HeTPort/Rsicv-soc/fpga/zynq_mini_revb/README.md

# ZYNQ MINI 20240221/REVB FPGA build

This directory targets the Bo Chen Jing Xin ZYNQ MINI board marked
`20240221/REVB`, with an XC7Z010 in the CLG400 package. The visible package
marking does not show a readable speed grade, so the flow uses the conservative
Vivado part `xc7z010clg400-1`. Set `ZYNQ_MINI_PART` only after positively
identifying a different speed grade.

The production profile remains 25 MHz. The P0 power baseline uses
`ZYNQ_MINI_CORE_CLOCK_HZ=95000000`, which configures the MMCM for an exact
95 MHz output and writes reports under an application-specific `_95mhz`
directory. For a timing experiment, `100000000` remains supported. The retained
100 MHz route does **not** close: WNS is -0.387 ns.

The top includes a retained but otherwise unused PS7 hard block because Vivado
requires it for correct Zynq device configuration. It supplies no clock or
application service: the custom RISC-V SoC remains entirely in PL.

No physical board is needed to build the bitstreams. A connected board is
needed only to verify JTAG discovery, program the device, and observe the real
clock/reset, LEDs, and UART.

Physical status through 2026-08-23: onboard FT232HL JTAG works after installing
the bundled Digilent Adept runtime; `timer_gpio`, `timer_irq`, external-UART
`hello`, production FreeRTOS heartbeat/D1 behavior, and repeated PL K2 restart
pass on the exact board. Speed-grade identification remains open. JTAG recovery
evidence is in the
[JTAG bring-up log](../../doc/ZYNQ_MINI_REVB_JTAG_BRINGUP_LOG.md).

## Interfaces

| Function | FPGA pin | Board location | Direction/polarity |
|---|---:|---|---|
| 50 MHz PL clock | K17 | X1 / `PL_CLK_50M` | input |
| Reset | M20 | PL K2 | input, active low |
| LED 0..3 | T12, U12, V12, W13 | PL D1..D4 | output, active high |
| UART RX | U15 | EXT IO U15 | adapter TX to board |
| UART TX | W15 | EXT IO W15 | board to adapter RX |

The onboard USB-UART is connected to Zynq PS MIO48/MIO49. It cannot carry the
custom PL UART. Use a separate **3.3 V TTL** USB-UART adapter:

1. adapter TX to EXT IO U15;
2. adapter RX to EXT IO W15;
3. adapter GND to EXT IO GND;
4. leave the adapter VCC pin disconnected.

Use 115200 baud, 8 data bits, no parity, one stop bit, and no flow control.

## Build firmware images

From WSL, build and install the Phase 5 images or the production FreeRTOS
image. The production FreeRTOS build keeps scheduling indefinitely; only its
separate `_sim` profile terminates through `tohost`:

```bash
cd /mnt/d/Rsicv-soc-worktrees/phase2-act4-cleanup
bash sw/build_firmware_wsl.sh --install hello timer_gpio timer_irq
bash sw/build_firmware_wsl.sh --install freertos_demo
bash sw/build_firmware_wsl.sh --install p0_mix
bash sw/build_firmware_wsl.sh --install p0_wfi_timer
bash sw/build_firmware_wsl.sh --install p0_ram_stream
bash sw/build_firmware_wsl.sh --install p0_idle_spin p0_uart_poll
SOC_FREERTOS_MTIME_HZ=95000000 SOC_FREERTOS_DEMO_TIME_SCALE=100 SOC_FREERTOS_SIM_COMPLETION=0 SOC_FREERTOS_POWER_PROFILE=1 SOC_FREERTOS_IMAGE_SUFFIX=_p0 bash sw/build_firmware_wsl.sh --install freertos_demo
```

## Build bitstreams with Vivado 2019.2

From PowerShell at the repository root:

```powershell
$vivado = 'D:\vivado\Vivado\2019.2\bin\vivado.bat'
& $vivado -mode batch -notrace `
  -source .\fpga\zynq_mini_revb\build.tcl -tclargs hello
& $vivado -mode batch -notrace `
  -source .\fpga\zynq_mini_revb\build.tcl -tclargs timer_gpio
& $vivado -mode batch -notrace `
  -source .\fpga\zynq_mini_revb\build.tcl -tclargs timer_irq
& $vivado -mode batch -notrace `
  -source .\fpga\zynq_mini_revb\build.tcl -tclargs freertos_demo

# Optional timing experiment; currently expected to fail the WNS gate.
$env:ZYNQ_MINI_CORE_CLOCK_HZ = '100000000'
& $vivado -mode batch -notrace `
  -source .\fpga\zynq_mini_revb\build.tcl -tclargs hello
Remove-Item Env:\ZYNQ_MINI_CORE_CLOCK_HZ

# Exact P0 routed profile.
$env:ZYNQ_MINI_CORE_CLOCK_HZ = '95000000'
& $vivado -mode batch -notrace `
  -source .\fpga\zynq_mini_revb\build.tcl -tclargs p0_mix
& $vivado -mode batch -notrace `
  -source .\fpga\zynq_mini_revb\build.tcl -tclargs p0_wfi_timer
& $vivado -mode batch -notrace `
  -source .\fpga\zynq_mini_revb\build.tcl -tclargs p0_ram_stream
& $vivado -mode batch -notrace `
  -source .\fpga\zynq_mini_revb\build.tcl -tclargs freertos_demo_p0
& $vivado -mode batch -notrace `
  -source .\fpga\zynq_mini_revb\build.tcl -tclargs p0_idle_spin
& $vivado -mode batch -notrace `
  -source .\fpga\zynq_mini_revb\build.tcl -tclargs p0_uart_poll
Remove-Item Env:\ZYNQ_MINI_CORE_CLOCK_HZ
```

Each run reads RTL and XDC, synthesizes, checks that both firmware images
survive as nonzero BRAM initialization, places, routes, writes utilization,
timing/clock/power/DRC reports, rejects negative routed WNS or any Error/Critical
Warning DRC, and generates:

```text
build/zynq_mini_revb/<application>/zynq_mini_revb_<application>.bit
```

The Phase 5 hardware profiles keep the same firmware images but slow `mtime`
so the results are visible: `timer_gpio` changes LEDs about once per second,
while `timer_irq` generates one interrupt about once per second for ten
interrupts. `freertos_demo` uses the real 25 MHz MTIME rate configured in its
production image, giving a 1 kHz RTOS tick.

The P0 measurement profiles keep `TIMER_TICK_CYCLES=1` to match ModelSim.
The routed `p0_mix` checkpoint closes setup at WNS +0.006 ns; the other five
P0 checkpoints each close at +0.003 ns. All six have TNS 0 and zero blocking
DRC findings. They are distinct workload/checkpoint identities; none can be
substituted for the other or for a 25 MHz production build. The
[power framework](../../power/README.md) and
[P0 results](../../doc/plans/p0-power-baseline/results.md) explain activity
mapping, estimates, and limits.

## Program and observe the board

These are the steps that require the board:

1. Power the board off and set BOOT to JTAG `00` (both switches toward the
   silk-screened ON/KEY side, according to the board legend).
2. Power the board only through its documented 5 V Type-C input. Connect the
   JTAG Type-C cable and the external 3.3 V UART wiring above. Do not connect
   the USB-UART adapter's VCC pin.
3. In Vivado, open Hardware Manager, select **Open Target > Auto Connect**, and
   confirm an XC7Z010 is detected.
4. Program one generated `.bit` file. If needed, press PL K2 once after
   programming.
5. For `hello`, confirm the expected UART banner at 115200 8N1. For
   `timer_gpio`, confirm the PL LEDs step through the firmware sequence. For
   `timer_irq`, confirm the ten timer-interrupt completion behavior. For
   `freertos_demo`, confirm `FreeRTOS RV32IM`, then a `heartbeat` line every
   second, while PL D1 toggles every 500 ms. Leave it running to exercise tick
   preemption, queue blocking/unblocking, and repeated context switches.

Observed through 2026-08-23:

- `timer_gpio`: PASS, `0001 -> 0010 -> 0100 -> 1000 -> 0101`, approximately
  one update per second;
- `timer_irq`: PASS, binary interrupt count `0001` through `1010`,
  approximately one update per second, with final D2/D4 on;
- `hello`: PASS through an external 3.3 V USB-TTL adapter at 115200 8N1;
- `freertos_demo`: PASS with sustained `heartbeat`, visible PL D1 toggling,
  and recovery after deliberate K2 resets.

The retained PuTTY transcript contains 74 exact hello strings, 17 banners
caused by deliberate resets, and 537 exact heartbeats. Evidence and hashes are
in [`doc/evidence/board_20260823/`](../../doc/evidence/board_20260823/README.md).

Programming is volatile: after power is removed, reload the bitstream. JTAG and
the UART/repeated-reset baseline are proven; QSPI/SD boot-image generation
remains deferred beyond the first milestone.

## JTAG cable recovery

If Hardware Manager connects to `hw_server` but shows `localhost (0)`, the
server is alive but has enumerated zero hardware cables. On this machine,
Windows already saw the FT232HL as `VID_0403:PID_6014` / `Digilent USB Device`,
which ruled out a power-only Type-C cable and moved the investigation to the
Vivado cable runtime.

Close Vivado, open an elevated PowerShell, and install the support bundled with
the same Vivado release:

```powershell
Set-Location -LiteralPath `
  'D:\vivado\Vivado\2019.2\data\xicom\cable_drivers\nt64'
.\install_drivers_wrapper.bat
```

The successful log installed Xilinx PC USB support, Digilent Adept Runtime
2.18.2/USB support, and SmartLynq support. After restarting/re-enumerating the
device, Vivado could program the board. Do not rewrite the FTDI EEPROM as a
first repair: this unit already reports a Digilent identity. Commands,
evidence, source links, rejected paths, and the reusable layer-by-layer
decision tree are in the
[JTAG bring-up log](../../doc/ZYNQ_MINI_REVB_JTAG_BRINGUP_LOG.md).

## What still needs manual review

- Confirm the physical package's speed grade with a vendor record or readable
  device-identification source. The `-1` build is deliberately conservative.
- The 50 MHz clock, active-high LED mapping, BRAM boot, timer progression, and
  interrupt-driven execution, external UART TX, production FreeRTOS, and K2
  restarts now have physical evidence. If later behavior differs from the
  schematic, stop and recheck continuity or vendor documentation before
  changing package pins.
- Vivado currently warns that asynchronously reset control registers feed data
  BRAM address/control logic (`REQP-1839`). Reset deassertion is synchronized
  and repeated K2 testing passes, but the warning remains a structural cleanup
  candidate before treating this as a production design.
