HeTPort/Rsicv-soc/sim/regress/README.md

# Automated regression runner

This directory contains the lightweight regression layer for the RV32IM core.
It deliberately does not require UVM. The runner compiles RTL once, selects
tests from a JSON manifest, launches each test in ModelSim, saves independent
logs, and returns a nonzero process status if any test fails.

## Files

- `tests.json` - test names, firmware images, timeouts, and selection tags.
- `soc_red_tests.json` - isolated Phase 2 SoC contract cases for data and
  instruction access faults.
- `phase3_tests.json` - precise timer/WFI and 10,000-interrupt Phase 3 cases.
- `phase4_tests.json` - polling UART TX/RX and GPIO Phase 4 cases.
- `phase5_tests.json` - split-image and reset-to-C Phase 5 firmware cases.
- `phase6_tests.json` - official FreeRTOS preemption/queue/UART/GPIO slice.
- `run_regression.ps1` - Windows PowerShell orchestration and result checking.
- `run_release_verification.ps1` - fail-fast release entry point for map/tool,
  focused fetch-error/fabric, directed Phase 3–6, and applicable ACT4 gates.
- `regression_result.ps1` - shared simulator result-classification policy.
- `test_regression_result.ps1` - dependency-free positive/negative classifier
  test, including the nonzero-exit false-pass case.
- `run_regression.cmd` - Command Prompt wrapper that bypasses script policy only
  for this one PowerShell process.
- `build_tests_wsl.sh` - optional GNU-toolchain builder for assembly tests in WSL.
- `elf_to_mem.py` - address-aware RV32 ELF to instruction/data RAM converter.
- `import_act4.py` - converts ACT4 ELF directories and generates a manifest.
- `build_act4_wsl.sh` - generates/imports ACT4 tests in WSL.
- `run_act4_build.ps1` - parameterized Windows/WSL ACT4 build entry point for
  either the I or M extension.
- `run_act4.ps1` - convenience wrapper for imported ACT4 ELF directories.

Generated files are kept outside the source directories:

```text
sim/build/regression/work   ModelSim work library
sim/logs/regression         compile and per-test logs
build/tests                 WSL-generated object, ELF, binary, hex, disassembly
```

## Quick start on Windows

From PowerShell:

```powershell
Set-Location D:\Rsicv-soc\sim\regress
Set-ExecutionPolicy -Scope Process -ExecutionPolicy Bypass
./run_regression.ps1
./test_regression_result.ps1
```

From Command Prompt:

```bat
cd /d D:\Rsicv-soc\sim\regress
run_regression.cmd
```

Useful selections:

```powershell
# Show the manifest without compiling or simulating.
./run_regression.ps1 -List

# Run tests having the lsu tag.
./run_regression.ps1 -Tag lsu

# A test matches when it has any requested tag.
./run_regression.ps1 -Tag csr,mret

# Explicit names take priority over tags.
./run_regression.ps1 -Test ebreak,mret

# Reuse the existing compiled library.
./run_regression.ps1 -Tag trap -NoCompile

# Enable commit and pipeline messages in each selected test log.
./run_regression.ps1 -Test ebreak -Trace

# Also request a VCD. Sequential tests overwrite the same VCD in the build
# directory, so use this mainly with one explicitly selected test.
./run_regression.ps1 -Test ebreak -Trace -DumpWaves
```

## One-command release verification

With an existing generated `build/act4/tests.json` manifest:

```powershell
./run_release_verification.ps1
```

From a clean checkout with the pinned WSL/ACT4 prerequisites installed:

```powershell
./run_release_verification.ps1 -RegenerateAct4 -Act4Jobs 8
```

This exact path passed from a new detached worktree on 2026-08-18. The wrapper
uses named hashtable splatting for `Jobs` and optional ACT4 paths; positional
array splatting is incorrect for forwarding named options to another
PowerShell script. Retained results are in
[`../../doc/evidence/release/BASELINE_2026-08-18.md`](../../doc/evidence/release/BASELINE_2026-08-18.md).

The command runs, in order:

1. generated SoC-map staleness and 9 map-generator tests;
2. 12 ELF-converter/ACT4-importer tests and the result-classifier negative test;
3. the focused fetch-error timing and SoC data-fabric protocol tests;
4. 23 directed smoke tests, including the precise illegal-JALR-funct3 case;
5. both Phase 3 tests, including 10,000 timer interrupts;
6. Phase 4 (3), Phase 5 (4), and Phase 6 (1) regressions;
7. ACT4 manifest classification (47 total, 39 RV32I, 8 RV32M) and all 47 cases.

Every step is fail-fast. `-SkipAct4` exercises the complete local preflight but
prints an explicit warning and cannot be reported as a release pass.

The Phase 2 SoC contract suite selects `tb_riscv_soc` through a separate
manifest. Run the implemented centralized data-decoder/default-target cases:

```powershell
./run_regression.ps1 `
  -Manifest .\soc_red_tests.json `
  -Tag phase2-data
```

All three selected runs (load, store, and store with inserted RAM waits) must
pass. Run the instruction-access-fault case separately with:

```powershell
./run_regression.ps1 `
  -Manifest .\soc_red_tests.json `
  -Tag phase2-fetch
```

The selected fetch case must also pass. The focused fetch timing and fabric
protocol tests are:

```powershell
Set-Location D:\Rsicv-soc\sim
vsim -c -do run_fetch_error_timing.do
vsim -c -do run_soc_data_fabric.do
```

Run the Phase 3 architectural and long-duration timer tests from
`sim/regress` with:

```powershell
./run_regression.ps1 -Manifest .\phase3_tests.json -Test soc_timer_wfi
./run_regression.ps1 -Manifest .\phase3_tests.json -Test soc_timer_10k
```

Run the Phase 4 peripheral vertical slices with:

```powershell
./run_regression.ps1 -Manifest .\phase4_tests.json -Test soc_uart_hello
./run_regression.ps1 -Manifest .\phase4_tests.json -Test soc_uart_echo
./run_regression.ps1 -Manifest .\phase4_tests.json -Test soc_gpio_out
```

The hello run enables the `tb_riscv_soc` serial-pin decoder. It passes only
after `uart_tx_o` decodes as `Hello, UART!\r\n` and firmware commits
`tohost=1`. The echo run drives 16 real 8N1 frames into `uart_rx_i`; polling
firmware drains the default 16-byte FIFO, echoes them, and passes only after
`uart_tx_o` decodes as `RX FIFO 16 OK!\r\n` with `tohost=1`.
The GPIO run writes and reads back five MMIO values while an independent
scoreboard observes `gpio_out_o = 01, 02, 04, 08, A5`. This catches both target
state errors and a missing SoC output connection.

Build the Phase 5 C firmware from WSL with:

```bash
bash sw/build_firmware_wsl.sh --install hello timer_gpio timer_irq
```

The build emits ELF, map, readelf, disassembly, size, and independent local
program/data images. It consumes `sim/generated/soc_map.json` rather than a
second handwritten map. Run all Phase 5 slices with:

```powershell
./run_regression.ps1 -Manifest .\phase5_tests.json -Tag phase5
```

The hello case checks ABI/runtime invariants before decoding
`Hello, UART!\r\n`. Its ELF-derived `.bss` tail is poisoned in the input data
image, so observing zero proves startup cleared it. The timer/GPIO case checks
timer-polled output/readback. The interrupt case independently requires ten
machine-timer trap entries, full-context `mret` return, and final GPIO `0x0A`.

Build the distinct Phase 6 simulation image from the repository root with:

```bash
SOC_FREERTOS_MTIME_HZ=5000000 \
SOC_FREERTOS_DEMO_TIME_SCALE=100 \
SOC_FREERTOS_SIM_COMPLETION=1 \
SOC_FREERTOS_IMAGE_SUFFIX=_sim \
bash sw/build_firmware_wsl.sh --install freertos_demo
```

Then run:

```powershell
./run_regression.ps1 -Manifest .\phase6_tests.json -Tag phase6
```

The scoreboard checks the FreeRTOS banner/heartbeat stream, alternating GPIO,
and at least ten timer interrupts. Firmware reports PASS only after ordered
queue traffic and the queue-forced `s2`-`s11` context sentinels succeed. Build
the production 25 MHz image without the simulation overrides.

The fast `phase6` case remains the normal release gate. A separate soak image
raises the firmware completion thresholds to 1,000 tick hooks and queue
receives, 100 GPIO updates, and 50 heartbeats:

```bash
SOC_FREERTOS_MTIME_HZ=5000000 \
SOC_FREERTOS_DEMO_TIME_SCALE=100 \
SOC_FREERTOS_SIM_COMPLETION=1 \
SOC_FREERTOS_IMAGE_SUFFIX=_soak \
SOC_FREERTOS_MIN_QUEUE_RECEIVES=1000 \
SOC_FREERTOS_MIN_LED_UPDATES=100 \
SOC_FREERTOS_MIN_HEARTBEATS=50 \
SOC_FREERTOS_MIN_TICK_HOOKS=1000 \
bash sw/build_firmware_wsl.sh --install freertos_demo
```

Run it explicitly; the `phase6-soak` tag is deliberately excluded from the
fast unified release command:

```powershell
./run_regression.ps1 -Manifest .\phase6_tests.json -Tag phase6-soak
```

Success produces process exit code `0`. Manifest, tool, compile, assertion,
timeout, simulator, or architectural failures produce a nonzero exit code. The
focused classifier test proves that a PASS-looking transcript cannot override
a nonzero simulator exit. This makes the same command usable by a person, a
batch file, or CI.

## Manifest grammar

`tests.json` uses JSON objects, arrays, strings, and numbers:

```json
{
  "schema_version": 1,
  "defaults": {
    "timeout_cycles": 20000
  },
  "tests": [
    {
      "name": "rv32im_waitstate",
      "image": "testdata/prog.hex",
      "timeout_cycles": 50000,
      "data_req_wait_cycles": 2,
      "data_rsp_wait_cycles": 3,
      "tags": ["all", "smoke", "lsu", "waitstate", "ar003"]
    }
  ]
}
```

Important JSON rules:

- `{ ... }` is an object containing named properties.
- `[ ... ]` is an ordered array.
- Property names and strings require double quotes.
- Commas separate properties and array elements, but JSON forbids a trailing
  comma after the final item.
- `image` is relative to the repository root, not the launch directory.
- Optional `data_image` initializes data RAM independently from instruction RAM.
- Optional `top` selects the elaborated simulation top. It may be supplied by
  a test or by `defaults`; when omitted it remains `work.tb_riscv_core`.
- Optional `tohost_addr` overrides the completion address for that test.
- `timeout_cycles` bounds the test independently of host execution time.
- Optional `data_req_wait_cycles` delays data-request acceptance.
- Optional `data_rsp_wait_cycles` independently delays the response after the
  synchronous RAM access. Both default to zero.
- Optional `data_error_addr` makes the RAM adapter return `rsp_error` for one
  selected address while leaving other accesses available to the trap handler.
- Optional `freertos_min_timer_irqs`, `freertos_min_uart_bytes`, and
  `freertos_min_gpio_transitions` set independent SoC-testbench minimums for a
  FreeRTOS profile.
- Tags describe capabilities and allow one test to belong to several suites.

The runner uses **any-tag matching**. `-Tag csr,mret` selects a test when it has
`csr` or `mret`. `-Test` performs exact name selection and takes priority.

## PowerShell grammar used by the runner

### Parameters and types

```powershell
param(
    [string[]]$Tag = @("smoke"),
    [switch]$Trace
)
```

- `[string[]]` declares an array of strings.
- `@(...)` forces an array even when there is only one result.
- `[switch]` is false when absent and true when written on the command line.

### Variables and interpolation

```powershell
$logPath = Join-Path $logDir "$testName.log"
```

Variables begin with `$`. Double-quoted strings expand variables; single-quoted
strings normally do not.

### Pipelines

```powershell
$failed = @($results | Where-Object { $_.Status -ne "PASS" })
```

`|` passes objects rather than plain text. `$_` means the current pipeline
object. `{ ... }` is a script block evaluated for every object.

### Splatting command arguments

```powershell
$vlogArgs = @("-sv", "-work", $workLibrary) + $sourceFiles
$output = & vlog @vlogArgs 2>&1
```

- `&` invokes a command whose name or path is an expression.
- `@vlogArgs` expands an array into separate command-line arguments.
- `2>&1` merges the error stream into captured output.
- `$LASTEXITCODE` contains the native executable's process exit status.

ModelSim can return zero after some simulation failures, depending on how Tcl
exits. The runner therefore requires all four conditions:

```text
the native simulator process exit status is zero
[TB] RESULT: PASS is present
no ** Fatal: message is present
the final ModelSim error count is zero
```

`test_regression_result.ps1` supplies a nonzero exit together with an otherwise
passing transcript and proves that the shared production classifier rejects it.

### Guaranteed directory restoration

```powershell
Push-Location $buildDir
try {
    # compile and simulate
} finally {
    Pop-Location
}
```

`finally` executes even when an exception is thrown. This prevents a failed
regression from leaving an interactive shell in a surprising directory.

## ModelSim command grammar

The runner ultimately invokes commands equivalent to:

```powershell
vlib D:/Rsicv-soc/sim/build/regression/work
vmap work D:/Rsicv-soc/sim/build/regression/work
vlog -sv -work D:/Rsicv-soc/sim/build/regression/work <absolute-source-files>
vsim -c -voptargs=+acc `
  -gPROGRAM_FILE=D:/Rsicv-soc/testdata/ebreak_test.hex `
  -gTIMEOUT_CYCLES=1000 `
  -gTRACE_ENABLE=0 `
  -gDUMP_WAVES=0 `
  work.tb_riscv_core `
  -do "run -all; quit -f"
```

- `vlib` creates a compiled HDL library.
- `vmap` assigns the logical name `work` to its physical directory.
- `vlog -sv` compiles SystemVerilog.
- `vsim -c` selects console mode.
- `-gNAME=value` overrides a top-level SystemVerilog parameter.
- `-do` supplies Tcl commands; semicolons separate Tcl commands.

The corresponding SystemVerilog parameter declaration is:

```systemverilog
module tb_riscv_core #(
  parameter string PROGRAM_FILE = "../testdata/prog.hex",
  parameter string DATA_FILE = "",
  parameter bit TRACE_ENABLE = 1'b0,
  parameter bit DUMP_WAVES = 1'b0,
  parameter int TIMEOUT_CYCLES = 20000,
  parameter logic [31:0] TOHOST_ADDR = 32'h0000_1000
);
```

Parameters are elaboration-time constants. ModelSim applies `-g` before the
testbench is elaborated, so each test can use a different image and watchdog
without recompiling the RTL.

## Building assembly tests in WSL

From Ubuntu/WSL:

```bash
cd /mnt/d/Rsicv-soc
bash sim/regress/build_tests_wsl.sh ebreak_test m_trap_test
```

Outputs are written to `build/tests`; checked-in images are not overwritten.
Inspect them before installing:

```bash
less build/tests/ebreak_test.dis
diff -u testdata/ebreak_test.hex build/tests/ebreak_test.hex
```

To copy generated images into `testdata` deliberately:

```bash
bash sim/regress/build_tests_wsl.sh --install ebreak_test m_trap_test
```

Environment variables can select another tool prefix or ISA:

```bash
RISCV_PREFIX=riscv64-unknown-elf- \
RISCV_MARCH=rv32im_zicsr \
RISCV_MABI=ilp32 \
bash sim/regress/build_tests_wsl.sh ebreak_test
```

Relevant Bash grammar:

- `set -euo pipefail` stops on command failure, unset variables, or failed
  pipeline elements.
- `$(command)` captures a command's output.
- `${name}` expands a variable without ambiguity.
- `"${array[@]}"` expands an array while preserving argument boundaries.
- `command -v tool` checks whether an executable is available.
- `a | b | c` forms a pipeline; here `od`, `tr`, and `sed` convert a
  little-endian binary into one 32-bit `$readmemh` word per line.

## Adding a test

1. Add or generate the `.hex` image.
2. Run it directly once with `-Trace` if it is new.
3. Add one object to `tests.json` with a unique name.
4. Choose a timeout based on expected architectural cycles, with margin.
5. Add meaningful tags such as `rv32m`, `lsu`, `csr`, `trap`, or `smoke`.
6. Run the focused tag, then the full smoke suite.

Example:

```powershell
./run_regression.ps1 -Test new_test -Trace
./run_regression.ps1 -Tag smoke
```

## Scope and future adapters

This runner is orchestration, not an official ISA test set. The ACT4 adapter is
documented in `verif/act4/README.md`. Future sources can include legacy
`riscv-tests`, randomized riscv-dv programs, or Spike comparison results. The
basic compile/run/log/report layer remains the same.
