HeTPort/Rsicv-soc/doc/PROJECT_KNOWLEDGE_BASE.md

# RISC-V SoC Project Knowledge Base

**Document type:** Living study guide

**Audience:** New contributors and learners

**Last updated:** 2026-10-16

**Production reference:** `codex/phase2-act4-cleanup`. Phases 1–4 are complete.
Phase 5 is complete in ModelSim and Vivado OOC synthesis. AR-024 adds the Bo
Chen Jing Xin ZYNQ MINI `20240221/REVB` top, schematic-derived XDC, 50-to-25 MHz
MMCM/reset wrapper, and routed bitstreams for all three bare-metal programs.
JTAG plus physical `timer_gpio` and `timer_irq` execution now pass. External
UART TX, production FreeRTOS heartbeat/D1 behavior, and repeated K2 restart now
also pass physically. AR-025 adds the official FreeRTOS V11.3.0 RISC-V port, a
GREEN ModelSim vertical slice and extended scheduler/context soak, a routed
exact-board bitstream, and physical execution evidence. Positive speed-grade
identification remains open.

The current owner-selected learning track is an independent specification-first
rewrite on `codex/core-v2-spec-first`, recorded in
[AR-034](ar/AR034_SPEC_FIRST_CORE_V2_REWRITE.md). Existing synthesizable `src/`
remains v1; future v2 ownership is documented in the
[directory map](plans/core-v2-foundation/architecture.md). The owner writes RTL
module by module, starting with the [ALU specification pilot](plans/core-v2-foundation/modules/alu.md).
Independent models, module/cluster tests, precise retirement observation and
later ISS checking follow the [CV2 verification plan](plans/core-v2-foundation/verification_plan.md).
This is a documentation foundation; new RTL, tests, timing and power are
unimplemented/NOT RUN. Mutable evidence is owned by
[CV2 results](plans/core-v2-foundation/results.md).

AR-026 accepts a future scalable UVM verification architecture based on stable
retirement, memory, translation, coherence, and accelerator transactions above
protocol-specific interfaces and VIP. ModelSim SE-64 2019.2 now compiles and
runs its installed UVM 1.2 library, including a passing negative result-gate
check, but there is still no DUT-facing UVM component or coverage claim. The
first DUT slice will passively adapt the existing
`commit_pkt_t` into a `retire_event`, preserve `trap_entry_t` as a separate
`trap_entry_event`, and feed an ordered scoreboard.

Post-FreeRTOS growth is now organized by an evidence-gated roadmap rather than
one flat wish list. Each active substantial phase records requirements,
architecture, registers when applicable, verification plan, and observed
results using [`PHASE_EVIDENCE_TEMPLATE.md`](PHASE_EVIDENCE_TEMPLATE.md).
The current synthesizable hierarchy, runtime paths, shared packages, and
replaceable interfaces are summarized in
[`MODULE_DEPENDENCY_VIEW.md`](MODULE_DEPENDENCY_VIEW.md).
The detailed sequence and learning prerequisites are in
[`ROADMAP_AND_LEARNING_PATH.md`](ROADMAP_AND_LEARNING_PATH.md). This planning
change adds no RTL, UVM, low-power, accelerator, or propulsion capability.
The central literature/reproduction map, W0 workload-discovery process,
decision policy, and benchmark policy are in
[`RESEARCH_PROGRAM_PLAN.md`](RESEARCH_PROGRAM_PLAN.md). Detailed paper audits
remain separate so research can grow without turning the roadmap or TODO into
an evidence dump. The first reading queue and exact source provenance are in
[`research/SOURCE_REGISTRY.md`](research/SOURCE_REGISTRY.md).

Documentation is governed through
[`CONTEXT_ROUTER.md`](CONTEXT_ROUTER.md) and
[`AR033_DOCUMENT_GOVERNANCE_AND_CONTEXT_ROUTING.md`](ar/AR033_DOCUMENT_GOVERNANCE_AND_CONTEXT_ROUTING.md).
The router defines the smallest task-specific reading set, `notes/inbox/`
accepts rough ideas without making them requirements, and the legacy `docs/`
tree is frozen pending gradual migration. This changes how project knowledge is
found and maintained; it does not change RTL or software behavior.

The repository now has an adopted noncommercial source-available license and
commercial contact (`Hetport@outlook.com`); FreeRTOS remains under its upstream
MIT terms. P0's six-scenario measurement-only portfolio is now technically
verified: mixed compute, WFI/timer, RAM stream, FreeRTOS, clocked spin idle,
and UART polling all pass deterministic marker-window backward-SAIF,
matching timing-clean 95 MHz routed analysis, reviewed per-block mapping,
and two-run <=2% dynamic-power repeatability. The old 4%/clockless OOC spike
is rejected. Direct name mapping remains about 5.5%; these are comparative
Vivado FPGA estimates, not board-rail or ASIC power. Spin idle is not deep
sleep: changing operands and repeated fetches keep BRAM and incidental DSP
logic active; WFI/timer is the separate sleep/wake reference.
AR-030 replaces AR-027's combinational RV32M multiply backend with a fixed
registered blocking backend. Four registered 17-bit partial products feed two
registered aligned sums and a registered final product; the core holds ID/EX
and emits EX/WB bubbles until the response. It retains 4 DSP48E1 cells, closes
the exact 95 MHz route at WNS +0.430 ns, reduces `p0_mix` energy 4.03%, and
eliminates multiplier switching in the no-MUL spin workload. The whole SoC
   initially missed 100 MHz at WNS -0.312 ns on a timer-to-EX/WB path.
AR-029 fixes the production architecture at RV32 instead of advertising an
unsupported RV64 macro/width matrix. The 64-bit timer and architectural
counters remain explicit paired-word state, while wide future NPU/MAC datapaths
remain independent of scalar XLEN. Fake core/SoC/bus/peripheral `AW`/`DW`
overrides were removed; genuinely generic RAM and divider parameters remain.
AR-031 centralizes pipeline movement in `core_ctrl`: typed EX and retirement
redirect candidates enter one priority point, and one `pipe_ctrl_t` drives
fetch, holds, flushes, delayed fetch invalidation, and kills. MRET redirect and
CSR restoration now occur together at retirement. Exact 95 and 100 MHz routes
pass at +0.078 and +0.098 ns; this costs 121 LUT versus P1 but leaves `p0_mix`
cycles and estimated dynamic power unchanged.
AR-032 then performs a behavior-preserving semantic cleanup: `decode` and
`execute` reserve `_i/_o` for ports and build outgoing packets from the named
canonical bubble before assigning boundary-owned fields. This changes neither
instruction behavior nor pipeline timing; focused/protocol tests, smoke 23/23,
ACT4 47/47, and layered lint pass.

> Update this document whenever a change alters a module boundary, pipeline
> timing, packet field, architectural behavior, memory map, verification
> workflow, or current project milestone. Historical reasons and tradeoffs
> belong in
> [`ARCHITECTURE_DESIGN_AND_DECISIONS.md`](ARCHITECTURE_DESIGN_AND_DECISIONS.md).

## 1. What this project is

This repository implements a small custom RISC-V processor and early SoC in
SystemVerilog. The processor currently supports:

- RV32I integer instructions;
- the RV32M multiply/divide extension;
- machine-mode CSR, synchronous-exception, and machine-timer-interrupt support;
- precise traps for the currently implemented exception classes;
- synchronous instruction and data Block RAM;
- an architectural commit interface for verification.

The first practical system milestone is:

> Run preemptive FreeRTOS on this custom RV32IM core in the programmable logic
> of a Zynq XC7Z010 device.

The FreeRTOS milestone is intentionally smaller than the original Linux goal.
It does not require S-mode, an MMU, OpenSBI, DDR, caches, atomics, AXI, or a
PLIC. Those features remain possible future work, but they should not distort
the minimal architecture needed for the first working system.

## 2. Current status at a glance

### Implemented

- RV32IM decode and execution.
- A deliberate fixed RV32 scalar/core-bus contract; RV64 is a separately
  specified future architecture rather than a compile-time setting.
- Radix-2 iterative DIV/DIVU/REM/REMU with EX backpressure and kill support;
  multiplication uses the registered blocking `rv32m_mul_reg` backend behind
  the shared `rv32m_unit` request/response facade.
- Packed pipeline packets.
- Canonical, side-effect-free pipeline bubbles.
- Register file with same-cycle WB-to-ID bypass.
- One-cycle synchronous instruction BRAM.
- Single-outstanding, wait-state-capable CPU data bus.
- Clocked LSU request/response transaction state machine.
- Synchronous data RAM outside the CPU behind a core-bus adapter.
- Centralized full-address data decode, base-subtracted RAM requests,
  registered response ownership, and a one-cycle default error target.
- EX/WB-owned raw/aligned memory response data and error status.
- Precise load/store access-fault completion.
- Precise instruction-access-fault completion for out-of-range program fetches.
- M-mode CSR instructions, WARL behavior, trap entry, and `mret`.
- Retirement-owned RF/CSR/trap/commit commands with post-retirement interrupt
  eligibility and separate asynchronous `trap_entry_t` observation.
- A CLINT-compatible 64-bit `mtime`/`mtimecmp` target and hardware MTIP.
- One-time WFI retirement followed by logical wait and precise interrupt wake.
- Timer/UART/GPIO/RAM/default full-address decode with registered response ownership.
- Parameterized polling UART TX with one queued byte plus one active byte,
  `TX_READY`/`TX_BUSY`, registered invalid-access errors, and 8N1 output.
- Parameterized polling UART RX with two-flop input synchronization, midpoint
  8N1 sampling, a default 16-byte FIFO, nonblocking empty reads, and sticky
  overrun/framing errors.
- A 32-bit memory-mapped GPIO output register with parameterized physical
  width/reset value, byte-lane merge, readback, and registered access errors.
- Precise illegal-instruction, ECALL, EBREAK, instruction-misalignment, and
  load/store-misalignment traps.
- Ordered architectural commit records.
- ModelSim directed regression and test manifest with native-exit,
  PASS-marker, fatal-marker, and error-count result gates.
- One fail-fast release entry point covering map/tool checks, focused fabric,
  smoke, Phases 3–6, ACT4 classification, and all applicable ACT4 cases.
- ELF/image conversion and ACT4 integration adapters.
- Dependency-free machine-readable SoC map validation and deterministic
  cross-language generation for the accepted configuration; the data-fabric
  RTL now consumes its SystemVerilog constants.
- Accepted Phase 1 core-to-SoC ownership, memory-map, bus, error, software, and
  verification-environment contract.
- Generated 16 KiB/64 KiB RAM experiment profiles and paired Vivado 2019.2
  out-of-context utilization and post-synthesis internal timing evidence on
  provisional `xc7z010clg400-1`.
- Current directed smoke baseline: 23/23 passing, including the precise
  illegal-JALR-funct3 case, with 4/4 Python utilities and the focused
  regression-result negative test passing.
- Separate AR-018 `tb_riscv_soc` contract manifest: all three data-path runs and
  the instruction-access-fault run are GREEN.
- Focused AR-018 decode hardening: errored fetches produce one canonical
  fault-only ID/EX packet for replacement words encoding LOAD, STORE, control
  flow, CSR, DIV, MRET, or WFI; focused PASS plus 23/23 smoke preservation.
- Focused AR-018 timing hardening: consecutive invalid responses, stale errors
  across redirect/fetch-kill, and an error held through a four-cycle LSU wait
  all PASS with exact trap/PC/side-effect scoreboarding.
- Official ACT4 baseline: 39/39 RV32I and 8/8 RV32M tests passing, with
  per-extension manifest tags and a compact checked-in evidence record.
- Clean-worktree unified release verification: all local gates, the current
  23-test smoke suite, regenerated ACT4 I/M artifacts, and ACT4 47/47 passed
  from one command on 2026-08-18 in 549.2 seconds wall time.
- Split-region ELF conversion with generated map geometry, independent local
  images, rejection tests, and optional ELF-tail `.bss` poison.
- Reset-to-C startup with ABI-safe `sp`/`gp`, direct `mtvec`, active `.bss`
  clearing, a split linker policy, and explicit failure paths.
- Minimal CSR, UART, GPIO, timer, and `tohost` firmware drivers plus C UART,
  timer-polled GPIO, and full-context timer-interrupt applications.
- Phase 5 regression: 4/4 passing, including ten independently observed
  timer interrupts and exact serial/GPIO scoreboards.
- Phase 6 initial regression: 1/1 passing with the official FreeRTOS V11.3.0
  GCC RISC-V port, 11 observed ticks, queue-forced context switching,
  `s2`-`s11` sentinels, UART heartbeat, and GPIO activity.
- Phase 6 extended regression: PASS at 7,262,975 cycles with 1,428 observed
  timer interrupts, 1,000 ordered queue/context checks, 1,579 UART bytes,
  and 286 alternating GPIO transitions.
- Vivado firmware INIT gate: 32 RAMB36E1 cells split 16 program/16 data, with
  nonzero INIT properties in both image-loaded banks.
- Exact ZYNQ MINI REVB boundary: K17 50 MHz clock, M20 active-low reset,
  T12/U12/V12/W13 LEDs, and external 3.3 V UART on U15/W15.
- Primitive MMCM/BUFG 25 MHz clock generation, four-cycle lock-qualified reset
  release, and a retained unused PS7 hard macro for Zynq configuration.
- Routed Vivado 2019.2 builds for `hello`, `timer_gpio`, `timer_irq`, and
  `freertos_demo`: all have 0 DRC errors, TNS 0.000 ns, at least +22.093 ns
  WNS, initialized 16+16 BRAMs, and generated bitstreams.
- Exact-board JTAG configuration and physical execution for `timer_gpio` and
  `timer_irq`, including the expected LED sequence and ten interrupt counts.
- Exact-board external UART TX and production FreeRTOS execution: 74 retained
  exact hello strings, 17 deliberate-reset banners, 537 heartbeats, visible D1
  activity, and repeatable K2 restart behavior on 2026-08-23.
- A reproducible FT232HL recovery record: diagnose `localhost (0)` at the cable
  layer, confirm Windows `VID_0403:PID_6014`, install the bundled Digilent Adept
  runtime, inspect its log, and retest before changing EEPROM or RTL.

### Not implemented yet

- GPIO input/direction/interrupt registers and other additional peripherals;
  polling UART TX/RX and output GPIO are implemented, while UART interrupts/
  PLIC are deferred.
- Positive identification of the package speed grade; local builds use
  conservative `xc7z010clg400-1`.
- The AR-026 passive DUT environment, ISS differential adapter, reactive memory
  agents, riscv-dv integration, generated RAL, and accelerator/cache/MMU
  domains are accepted future work. Only the standalone UVM 1.2 toolchain
  smoke and its negative result gate are implemented and verified.
- A `src/common/` primitive library. AR-030's registered multiplier is now
  implemented in `src/core`; new common blocks still require real reuse and
  their own entry gates.

The implementation contract and ordered verification gates for the first item
are defined in the
[Phase 5 startup/runtime guide](../docs/phase5-startup-runtime-guide.md).

### Phase numbers and AR numbers are different axes

Phases are ordered execution gates; AR numbers are stable review-finding IDs.
Therefore, Phase completion and AR cleanup status must be read independently.
The current mapping is:

| Work | Planning meaning |
|---|---|
| AR-001, AR-002, AR-005, AR-006, AR-007 | Phase 0A work, implemented and verified |
| AR-003, AR-004 | Phase 2 transaction/result sub-gates, implemented and verified |
| AR-009 | Phase 1 split 64 KiB map accepted and adopted by RTL, firmware, simulation, synthesis, and ACT4 consumers |
| AR-008 | Phase 3 precise timer interrupt/WFI/timer target, implemented and verified |
| AR-010 | Ongoing verification-depth work across phases |
| AR-011 | Early FPGA feasibility and exact-board timing/resource closure verified |
| AR-012 | Retirement owner and public-interface cleanup implemented and verified; obsolete `halt_o` removed |
| AR-013 | Regression infrastructure fix, implemented and verified |
| AR-023 | Phase 5 split-image runtime and applications; simulation plus physical timer/GPIO and timer-IRQ verified, UART pending |
| AR-014 | Accepted-map generation infrastructure, implemented and verified |
| AR-015 | Paired 16 KiB/64 KiB utilization/timing evidence, implemented and verified |
| AR-016 | Core-to-SoC environment contract accepted; Phase 1 complete |
| AR-017 | Radix-2 iterative divider, implemented and verified through exact-board route |
| AR-018 | SoC contract tests GREEN; fetch-error packets are canonical and consecutive/redirect/stall timing corners are executable and passing |
| AR-019 | Centralized data decoder/default target implemented and verified |
| AR-020 | Minimal polling UART TX implemented and verified through OOC synthesis |
| AR-021 | Polling UART RX and parameterized default 16-byte FIFO implemented and verified through OOC synthesis |
| AR-022 | Memory-mapped output GPIO implemented and verified through OOC synthesis |
| AR-025 | Official FreeRTOS V11.3.0 RISC-V port; focused and extended ModelSim profiles plus routed bitstream verified, physical execution pending |
| AR-026 | Scalable UVM architecture accepted; ModelSim/UVM 1.2 toolchain sub-gate verified, passive retirement vertical slice not implemented |

The authoritative phase checklist is [`TODO.md`](../TODO.md); the detailed
finding status is in
[`ARCHITECTURE_REVIEW_AND_ACTION_PLAN.md`](ARCHITECTURE_REVIEW_AND_ACTION_PLAN.md).
The overall review and FreeRTOS roadmap remain open.

### Configuration source versus RTL parameters

These mechanisms are complementary:

- `riscv_soc` parameters tell Vivado how to elaborate one hardware instance;
- [`config/soc_map.json`](../config/soc_map.json) describes the accepted
  hardware/software address-map contract;
- [`tools/gen_soc_map.py`](../tools/gen_soc_map.py) validates that contract and
  generates consumer-specific syntax;
- generated files must never be edited independently.

The current source is `accepted`: it freezes the split 64 KiB ABI while current
RTL decoding, RAM defaults, and directed test addresses remain unchanged. See
[`AR014_MACHINE_READABLE_SOC_MAP.md`](ar/AR014_MACHINE_READABLE_SOC_MAP.md) and
[`config/README.md`](../config/README.md) for the complete relationship.

The AR-015 baseline found that two 16 KiB banks use 8/60 RAMB36 tiles (13.33%),
while two 64 KiB banks use 32/60 (53.33%) on the provisional part. Its
single-cycle divider produced an identical 87.102 ns/305-level path for both
profiles and failed 50 MHz with WNS -67.124 ns and 25 MHz with WNS -47.124 ns.

AR-017 replaced only DIV/DIVU/REM/REMU with a 32-iteration restoring Radix-2
unit. LUT use fell to 3,504 for the 16 KiB profile and 3,542 for 64 KiB;
registers became 2,601, while RAMB36 and DSP counts stayed unchanged. Refreshed
OOC post-synthesis STA gives WNS +7.373 ns at 50 MHz and +27.373 ns at 25 MHz,
with a 12.605 ns/19-level multiply-high path now dominant for both profiles.
Board clock location, placement, routing, I/O timing, and physical closure
remain unmeasured. See
[`AR015_RAM_CAPACITY_UTILIZATION_COMPARISON.md`](ar/AR015_RAM_CAPACITY_UTILIZATION_COMPARISON.md)
for the RED baseline and
[`AR017_RADIX2_ITERATIVE_DIVIDER.md`](ar/AR017_RADIX2_ITERATIVE_DIVIDER.md) for the
GREEN optimization.

A separate learner-facing experiment now demonstrates the divider workflow on
the current source: deterministic ModelSim waves and a deliberate checker RED,
divider-only Vivado routed internal-path STA at 25 MHz plus a same-route 5 ns
negative constraint, RTL/netlist correspondence, and Verilator warning triage.
It changes no production RTL and deliberately does not claim board, P0 power,
reset-release, or ASIC signoff. Follow
[`DIVIDER_DIGITAL_DESIGN_LAB.md`](DIVIDER_DIGITAL_DESIGN_LAB.md); retained
scope, requirements and measured results are in
[`plans/divider-design-lab/results.md`](plans/divider-design-lab/results.md).

## 3. Recommended learning order

Read and experiment in this order:

1. **Instruction flow:** `pc_counter` → `prog_ram` → `if2id`.
2. **Decode and operands:** `decode`, `regfile`, `id2ex`.
3. **Execution:** `execute`, ALU, branches, jumps, and the `rv32m_unit` facade.
4. **Memory:** `lsu`, `data_ram`, and load/store alignment.
5. **Retirement:** `ex2wb`, `retire_stage`, semantic commands, and observations.
6. **Control:** `core_ctrl`, hazards, stalls, flushes, and kills.
7. **Privilege behavior:** `csr_regfile`, trap entry, and `mret`.
8. **Verification:** `tohost`, commit assertions, regressions, and ACT4.
9. **Future SoC work:** memory map, bus protocol, timer, peripherals, firmware,
   and FPGA integration.

Do not begin by memorizing every signal. First understand:

- what information belongs to one instruction;
- where that information is registered;
- when an instruction is allowed to cause an architectural side effect;
- how the design keeps a response paired with the request that produced it.

## 4. System-level picture

```mermaid
flowchart LR
  LOADER["External program loader"] -->|"prog_wr_*"| PRAM["Synchronous program BRAM"]
  LOADER -.->|"load_done releases CPU reset"| IF

  subgraph CORE["riscv core"]
    IF["Fetch request and response tag"]
    ID["Decode and register read"]
    EX["ALU, branch, CSR result"]
    MDU["rv32m_unit: shared MUL + iterative DIV"]
    LSU["LSU transaction FSM"]
    WB["retire_stage: RF/CSR/trap/commit/WFI"]
    CTRL["Hazard, flush, and kill control"]
    CSR["M-mode CSR state"]
  end

  EX <--> MDU

  FABRIC["Full-address data fabric"]
  TIMER["Registered mtime/mtimecmp target"]
  UART["Registered UART target + TX holding byte"]
  GPIO["Registered GPIO_OUT target"]
  SHIFTER["8N1 TX shifter"]
  RXSAMPLER["2-flop sync + 8N1 RX sampler"]
  RXFIFO["RX FIFO, default 16 bytes"]
  DEFAULT["Registered default error target"]
  ADAPTER["Core-bus to RAM adapter"]
  DRAM["Synchronous data RAM"]

  PRAM -->|"instruction response"| IF
  IF --> ID --> EX --> WB
  EX --> LSU
  LSU -->|"architectural request"| FABRIC
  FABRIC -->|"timer-local request"| TIMER
  FABRIC -->|"UART-local request"| UART --> SHIFTER -->|"uart_tx_o"| PIN["FPGA/serial pin"]
  FABRIC -->|"GPIO-local request"| GPIO -->|"gpio_out_o"| GPIOPIN["FPGA output pins"]
  RXPIN["uart_rx_i"] --> RXSAMPLER --> RXFIFO --> UART
  FABRIC -->|"base-subtracted RAM request"| ADAPTER --> DRAM
  FABRIC -->|"all unmapped data addresses"| DEFAULT
  TIMER -->|"response + MTIP"| FABRIC
  UART -->|"registered response"| FABRIC
  GPIO -->|"registered response"| FABRIC
  DRAM --> ADAPTER --> FABRIC
  DEFAULT --> FABRIC -->|"owned response/data/error"| LSU
  LSU -->|"one completion"| WB
  WB -->|"GPR result"| ID
  WB -->|"csr_retire_cmd_t"| CSR
  CSR -->|"read data / csr_irq_context_t"| WB
  CSR -->|"read data, mepc"| EX
  ID -.->|"dependency state"| CTRL
  EX -.->|"redirect / exception state"| CTRL
  WB -.->|"redirect / WFI movement events"| CTRL
  CTRL -.->|"stall / flush / kill"| IF
  CTRL -.->|"bubble / hold"| ID
  CTRL -.->|"suppress younger effects"| EX
```

`riscv.sv` exposes a small request/response data bus; `riscv_soc.sv` routes it
through `soc_data_fabric.sv` to the timer, UART, GPIO, RAM adapter, or
registered default target. Polling UART TX/RX and output GPIO are implemented.

## 5. Repository map

| Path | Purpose |
|---|---|
| `src/core/riscv.sv` | CPU composition and external data-bus wiring; consumes typed control actions without selecting policy |
| `src/core/riscv_pkg.sv` | Fixed RV32 architectural widths, ISA constants, enums, packet definitions, trap causes |
| `src/core/decode.sv` | Instruction fields, immediates, operands, and control generation |
| `src/core/execute.sv` | ALU, branches/jumps, completed RV32M result consumption, CSR operations, trap metadata |
| `src/core/rv32m_unit.sv` | Single-outstanding valid/ready RV32M facade, kill/wait ownership, and result selection |
| `src/core/rv32m_mul_reg.sv` | Fixed-latency blocking multiplier with registered partial-product, reduction, product, response/backpressure, and kill ownership |
| `src/core/radix2_divider.sv` | Iterative DIV/DIVU/REM/REMU arithmetic, completion, and kill handling |
| `src/core/core_ctrl.sv` | Redirect priority, RAW/wait policy, fetch/PC/stage movement, delayed fetch invalidation, and younger-work kills |
| `src/core/retire_stage.sv` | Final RF/CSR commands, exception/IRQ/MRET choice, WFI state, redirect candidate, and commit observations |
| `src/core/lsu.sv` | Effective address, alignment, store lanes, transaction FSM, load extension |
| `src/core/csr_regfile.sv` | M-mode CSR state, legality, WARL preview, MTIP composition, ordered retirement update |
| `src/core/regfile.sv` | 32 integer registers, x0 behavior, WB-to-read bypass |
| `src/core/if2id.sv` | Fetch-to-decode pipeline register |
| `src/core/id2ex.sv` | Decode-to-execute pipeline register |
| `src/core/ex2wb.sv` | Execute-to-writeback pipeline register |
| `src/mem/prog_ram.sv` | One-cycle synchronous instruction/program BRAM |
| `src/mem/data_ram.sv` | Synchronous byte-writeable BRAM template with native hold-last read behavior |
| `src/bus/core_bus_data_ram.sv` | CPU-local bus adapter; owns request timing and normalized read/write/error responses |
| `src/bus/soc_data_fabric.sv` | Full-address timer/UART/GPIO/RAM/default decode, local translation, registered response owner |
| `src/bus/core_bus_default_target.sv` | Registered zero-data error response with no write side effect |
| `src/periph/mtime_timer.sv` | Registered RV32 `mtime`/`mtimecmp` bus target and level-sensitive MTIP |
| `src/periph/core_bus_uart.sv` | Registered UART MMIO target, TX holding stage, parameterized RX FIFO, and sticky errors |
| `src/periph/uart_tx.sv` | Parameterized byte-handshake 8N1 serial shifter |
| `src/periph/uart_rx.sv` | Two-flop input synchronization and midpoint-sampling 8N1 receiver |
| `src/periph/core_bus_gpio.sv` | Registered output GPIO target, partial-write merge, readback, and errors |
| `src/riscv_soc.sv` | Program loader, memories, data fabric/targets, and CPU wrapper |
| `sim/tb/tb_riscv_core.sv` | Main testbench and architectural checks |
| `sim/regress/` | Manifest-driven ModelSim runner and image conversion |
| `verif/act4/` | Official architectural-test integration metadata |
| `testdata/` | Directed assembly tests and generated memory images |
| `doc/` | Architecture reviews, decisions, evidence, and learning notes |
| `doc/ar/` | Indexed numbered architecture/problem-resolution records |
| `doc/CONTEXT_ROUTER.md` | Task-to-document routing and context-loading rules |
| `docs/` | Frozen legacy notes; migrate only when a file is substantially revised |
| `notes/inbox/` | Git-synchronized, non-authoritative rough ideas awaiting triage |
| `doc/SEMANTIC_SIGNAL_SPEC.md` | Normative signal ownership, timing, naming, and packing rules |

`src/bus` contains the fabric, default target, and RAM adapter. Empty future
module placeholders were removed: a planned timer, UART, or GPIO appears in
the source tree only when its phase defines and implements a real interface.

## 6. The real pipeline

It is useful to call this a five-stage-style in-order core, but the actual
registered structure matters more than the textbook name:

```text
fetch request
    |
program BRAM response + registered request PC/valid
    |
IF/ID register
    |
decode + register-file reads
    |
ID/EX register
    |
execute and LSU request generation
    |
LSU REQUEST/RESPONSE wait while ID/EX is held
    |
one LSU completion / complete EX-WB memory result
    |
EX/WB register
    |
writeback and architectural commit
```

There is no explicit EX/MEM register and no MEM/WB register. The LSU holds the
memory instruction in EX until a response completes, then lets it enter EX/WB
once. At that completion boundary, EX/WB captures the request metadata, raw
response, aligned load value, and response-error status as one instruction-owned
result.

### 6.1 Instruction fetch timing

A fetch is accepted at a rising edge when `instr_ren_o` is high.

| Time | Event |
|---|---|
| Before edge N | `instr_addr_o=A` and `instr_ren_o=1` |
| Rising edge N | `prog_ram` captures address A; the core captures PC tag A |
| After edge N | RAM returns data plus `fetch_error_o`; PC tag is A |
| Rising edge N+1 | IF/ID may capture `{valid, error, A, instr}` |

The PC tag, instruction word, and error status must advance or hold together.
If fetch stalls, `instr_ren_o` is low, so the response and its metadata hold.
For an out-of-range address, the word is only replacement data; `error=1` is
the authoritative fact. It travels with the PC and becomes cause 1 with
`mepc=mtval=PC`. The normal register, CSR, redirect, LSU, and divider effects
of that packet are suppressed.

### 6.2 Pipeline packets

Pipeline packets let the design move one instruction's related information as
one typed value.

| Packet | Main contents | Registered by |
|---|---|---|
| `fetch_pkt_t` | `valid`, `error`, `pc`, `instr` | `if2id` |
| `id_ex_pkt_t` | operands, immediate, destination, ALU/branch/memory/CSR intent | `id2ex` |
| `ex_wb_pkt_t` | result, memory/trap metadata, resolved `next_pc`, CSR/MRET/WFI semantics | `ex2wb` |
| `rf_write_cmd_t` | selected GPR retirement effect | `retire_stage` to `regfile` |
| `csr_retire_cmd_t` | CSR write plus independent trap/MRET/instret events | `retire_stage` to `csr_regfile` |
| `csr_irq_context_t` | effective mstatus/mie/mip/mtvec preview | `csr_regfile` to `retire_stage` |
| `commit_pkt_t` | final instruction register, memory, and synchronous-trap observation | verification only |
| `trap_entry_t` | synchronous or asynchronous architectural trap-entry observation | verification only |

An invalid registered packet is always a canonical all-zero bubble. A bubble is
not a NOP instruction: it is the absence of an instruction.

Packet producers follow the same construction pattern as the registers that
consume them: begin with the packet type's canonical bubble, then fill only the
fields whose meaning is established at that boundary. `decode` keeps its
fetch-error replacement fault-only, while `execute` leaves LSU completion
fields zero for the LSU merge in `riscv.sv`. Internal helpers use semantic
names; `_i/_o` identify real module ports.

### 6.3 Valid, bubble, faulting, and killed are different

- **Valid normal instruction:** may retire and produce its permitted effects.
- **Bubble:** `valid=0`; must have no side-effect controls.
- **Faulting instruction:** remains `valid=1` so it can report a trap, but its
  normal register/memory/redirect effects are suppressed.
- **Killed younger instruction:** converted to a bubble because an older event
  has made it architecturally nonexistent.

This distinction is central to precise exceptions.

## 7. Walkthrough of a normal instruction

Consider:

```asm
add x5, x6, x7
```

1. `pc_counter` presents the instruction address.
2. `prog_ram` returns the instruction one cycle after request acceptance.
3. `if2id` registers its PC and instruction bits.
4. `decode` identifies `rs1=x6`, `rs2=x7`, and `rd=x5`.
5. `regfile` supplies the two source values.
6. `decode` creates an `id_ex_pkt_t` with:
   - `use_rs1=1`, `use_rs2=1`;
   - `rf.we=1`, `rf.addr=5`;
   - `alu_op=ALU_ADD`;
   - `wb_sel=WB_ALU`.
7. `id2ex` registers that packet.
8. `execute` adds the operands and builds an `ex_wb_pkt_t`.
9. `ex2wb` registers the result.
10. `retire_stage` selects the ALU value and emits `rf_write_cmd_t`.
11. `regfile` writes x5 on the rising edge.
12. `commit_o` reports the instruction, PC, destination, and result in order.

## 8. Data hazards

The current core has no general EX/MEM forwarding network. It uses:

- one RAW hazard bubble when the consumer is in ID and producer is in EX;
- register-file write-first bypass when the producer reaches WB.

The hazard condition is conceptually:

```text
ID is valid
AND EX is valid
AND EX will write rd != x0
AND ID actually uses a matching rs1 or rs2
```

Response:

1. hold PC;
2. hold IF/ID;
3. flush ID/EX to insert one bubble;
4. allow the producer to advance to WB;
5. use WB-to-ID bypass for the consumer's operand;
6. release the consumer on the next cycle.

`use_rs1` and `use_rs2` matter because instruction bit fields can resemble
register addresses even when the instruction does not use those operands.

## 9. Branch, jump, redirect, and stale fetch behavior

Branches, JAL, and JALR resolve in EX and emit a candidate. MRET's effective
target is captured into EX/WB, then retirement emits its redirect in the same
cycle as `mstatus` restoration.

```mermaid
flowchart TD
  C["Compute candidate target"] --> T{"Does the transfer occur?"}
  T -->|"No"| SEQ["Continue at sequential PC"]
  T -->|"Yes"| A{"Resolved target satisfies IALIGN=32?"}
  A -->|"Yes"| R["Redirect PC and flush younger pipeline state"]
  A -->|"No"| X["Keep valid trap packet; suppress redirect and link write"]
  R --> K["Delayed fetch_kill_q discards one old-path BRAM response"]
  X --> W["WB enters precise instruction-address-misaligned trap"]
```

Important details:

- A not-taken branch does not observe or fault on its encoded target.
- JALR clears target bit zero before checking alignment.
- Any older retirement redirect (trap, interrupt, or MRET) has priority over a
  younger EX branch/jump candidate in `core_ctrl`.
- One-cycle synchronous program memory permits one old-path response after a
  redirect, so one delayed kill is required.

## 10. Loads and stores

### 10.1 Address and alignment

The LSU computes:

```text
effective address = rs1 value + immediate
```

Alignment rules:

| Access | Legal offsets |
|---|---|
| Byte | 0, 1, 2, 3 |
| Halfword | 0 or 2 |
| Word | 0 only |

A misaligned request does not reach RAM. It becomes a valid load/store
misalignment trap packet.

### 10.2 Little-endian store lanes

The request `wstrb` field selects which bytes change:

| Operation | Offset | Strobe |
|---|---:|---|
| SB | 0/1/2/3 | one corresponding bit |
| SH | 0 | `0011` |
| SH | 2 | `1100` |
| SW | 0 | `1111` |

Store data is shifted into the selected byte lanes.

### 10.3 Transaction and load completion

The LSU captures a valid aligned EX memory operation, holds its request until
the target accepts it, then waits for a response:

```text
IDLE -> REQUEST -> RESPONSE -> COMPLETE -> IDLE
```

PC, IF/ID, and ID/EX stall during REQUEST and RESPONSE. EX/WB receives a
canonical bubble during the wait. COMPLETE lasts one cycle and authorizes the
memory instruction to enter EX/WB exactly once.

For a load, the LSU captures the full response word, then uses its saved access
size, unsigned flag, and byte offset to select and sign- or zero-extend the
result for WB.

During COMPLETE, the raw response, aligned load value, and error status move
from the LSU's transaction registers into the same EX/WB packet as the request
metadata. WB and the commit interface consume only that packet.

An error response completes as a valid precise trap: cause 5 for a load or 7
for a store, `mtval` equal to the attempted address, and no GPR write. The
commit record preserves request metadata but reports failed load data as zero.

### 10.4 Implemented single-outstanding core bus

AR-003 implements this CPU-local data bus:

```text
request:  valid, ready, byte address, write, size, write data, write strobes
response: valid, full-word read data, error
```

Only one request may be outstanding. Both loads and stores receive one
response. The LSU always accepts the expected response, so this milestone does
not need `rsp_ready`. AXI and APB remain adapter protocols outside the CPU; the
LSU does not inherit their channels, IDs, bursts, or setup phases.

The LSU owns the request registers and transaction state. `core_ctrl` consumes
only abstract busy state and does not duplicate bus protocol logic.

`core_bus_data_ram.sv` is the first target adapter. It can independently delay
request acceptance and response delivery, and then translates an accepted
request to the synchronous RAM controls.

The original Vivado 2019.2 OOC check retained four program-memory and four
data-memory `RAMB36E1` cells. Detailed AR-003 rationale and evidence are in
[`AR003_WAIT_STATE_SAFE_LSU.md`](ar/AR003_WAIT_STATE_SAFE_LSU.md).

### 10.5 Implemented centralized data fabric

AR-019 inserted `soc_data_fabric` between the LSU bus and targets. AR-008
extended it with the timer window, AR-020 added UART, and AR-022 adds GPIO. It compares the complete architectural
address, subtracts the selected target base only in that target-facing copy,
and records timer, UART, GPIO, RAM, or default ownership until the response arrives. It
never re-decodes a changed live address while a transaction is outstanding.

The implemented timer window selects `mtime_timer`; the UART window selects
`core_bus_uart`; the GPIO window selects `core_bus_gpio`; the data-RAM window
selects the RAM adapter; every other
address selects `core_bus_default_target`. The
default target returns zero data with `error=1` during the cycle after
acceptance and owns no writable state. The original architectural address
remains in the LSU/commit packet for correct `mtval` and debug output.

Focused boundary, back-pressure, owner-stability, cross-target, invalid-load,
and invalid-store tests pass. Instruction fetch uses a separate fixed-latency
interface whose paired `fetch_error_o` now produces precise cause-1 traps.

The accepted 64 KiB Vivado OOC check retains 32 `RAMB36E1` cells and the
fabric/default-target hierarchy. Detailed decisions and evidence are in
[`AR019_CENTRALIZED_DATA_FABRIC.md`](ar/AR019_CENTRALIZED_DATA_FABRIC.md). This
still does not replace exact-board routed timing closure.

### 10.6 Minimal polling UART TX

AR-020 implements the first observable character-output path:

```text
CPU MMIO -> fabric -> core_bus_uart holding byte -> uart_tx shifter -> uart_tx_o
```

`TXDATA` is at `0x1000_0000`; `STATUS` is at `0x1000_0004` with
`TX_READY` in bit 0 and `TX_BUSY` in bit 1. Only aligned full-strobe word
writes to TXDATA and aligned word reads from STATUS are legal. Invalid accesses
receive a registered error without enqueuing a byte.

The holding register decouples CPU transaction timing from the ten-bit serial
frame. When the shifter is idle, `valid && ready` transfers the queued byte.
The slot can accept a replacement in that same cycle, so ready means “can
transfer now,” not simply “the full register is clear.” A full legal TXDATA
write is backpressured rather than failed or dropped.

The shifter emits idle high, one low start bit, eight LSB-first data bits, and
one high stop bit. The default 25 MHz / 115200 configuration uses a rounded
integer divider. Final baud accuracy must use the actual board clock. See
[`AR020_MINIMAL_POLLING_UART_TX.md`](ar/AR020_MINIMAL_POLLING_UART_TX.md) and the
[`Phase 4 UART guide`](../docs/phase4-uart-guide.md).

### 10.7 Polling UART RX and the 16-byte FIFO

AR-021 completes the bidirectional polling path:

```text
uart_rx_i -> 2-flop synchronizer -> 8N1 sampler -> RX FIFO -> CPU MMIO
```

`RXDATA` is at local offset `0x08`; a nonempty aligned word read returns and
pops the oldest byte. An empty read returns zero without stalling or popping.
`RXERROR` at `0x0C` exposes sticky overrun and framing-error state and clears
selected bits through write-one-to-clear. `STATUS` adds RX valid/full,
overrun/framing, and the FIFO count while preserving TX bits 0 and 1.

The FIFO defaults to 16 bytes through `UART_RX_FIFO_DEPTH`. Explicit pointer
wrapping supports non-power-of-two depths from 1 to 255. When full, the newest
arrival is dropped, the already queued order is preserved, and overrun becomes
sticky. A bad stop bit sets framing error and is not enqueued. A new hardware
error wins over a same-cycle software clear.

This design separates four meanings that should not be collapsed into one
module: asynchronous synchronization, serial framing, temporary byte storage,
and architectural MMIO policy. It also makes overload behavior explicit;
adding storage without defining which data is lost is not a complete FIFO
contract. See
[`AR021_POLLING_UART_RX_FIFO.md`](ar/AR021_POLLING_UART_RX_FIFO.md).

### 10.8 Memory-mapped output GPIO

AR-022 adds a small persistent output path:

```text
CPU MMIO -> fabric -> core_bus_gpio GPIO_OUT -> gpio_out_o
```

`GPIO_OUT` is a 32-bit R/W register at `0x1000_1000`; the target sees local
offset `0x00`. Its low `GPIO_WIDTH` bits reach the SoC output, with a default
width of eight and reset value zero. Legal byte, aligned halfword, and aligned
word writes merge selected lanes. Reads return the containing word, allowing
the LSU to perform its normal byte/halfword extraction. Invalid offsets,
alignment, or strobes return a registered error with no output change.

GPIO is the fabric's fifth response owner, so the owner enum is three bits.
The owner is captured when the request transfers and selects the later
response; the fabric never re-decodes the live address during an outstanding
transaction. Focused target/fabric tests, firmware readback, an independent
pin-transition scoreboard, and OOC hierarchy retention are GREEN. See
[`AR022_MEMORY_MAPPED_GPIO_OUTPUT.md`](ar/AR022_MEMORY_MAPPED_GPIO_OUTPUT.md) and
the [`Phase 4 GPIO guide`](../docs/phase4-gpio-guide.md).

## 11. CSR and trap model

The current privilege model is machine mode only.

### 11.1 CSR instruction path

1. Decode determines CSR operation and architectural write intent.
2. EX checks implemented address, privilege, and read-only encoding.
3. EX computes the final read-modify-write value.
4. Retirement emits a raw CSR preview only when the packet is valid and not a
   synchronous trap.
5. `csr_regfile` applies WARL and returns the effective interrupt context.
6. Retirement emits one clocked command that may contain both the CSR write and
   an asynchronous trap entry.
7. A younger same-address CSR operation receives the older WARL-filtered value
   through WB-to-EX bypass.

Do not infer write intent from whether source data equals zero. CSR write intent
comes from the encoded source-register/immediate field and operation type.

### 11.2 WARL

WARL means software can write any value, but the implementation stores and
returns only a supported legal value.

Examples:

- `mstatus` retains only MIE/MPIE and fixed MPP=M.
- `mie` retains only MTIE.
- `mtvec` and `mepc` are forced to four-byte alignment.
- `misa` and delegation CSRs expose fixed supported values.

### 11.3 Precise synchronous trap sequence

```mermaid
sequenceDiagram
  participant EX as Execute
  participant EW as EX/WB
  participant WB as Retirement
  participant CSR as CSR state
  participant CTRL as Pipeline control
  participant PC as PC

  EX->>EW: valid trap packet with pc/cause/mtval
  EW->>WB: trapping instruction reaches retirement
  WB->>CSR: save mepc, mcause, mtval , update MIE/MPIE
  WB->>CTRL: pipe_kill younger instructions
  CTRL->>EX: suppress younger LSU/register/CSR effects
  WB->>PC: redirect to mtvec
```

Older instructions may complete. The faulting instruction reports the trap but
cannot perform its normal side effect. Younger instructions must disappear.

### 11.4 Precise machine-timer interrupt and WFI

An interrupt is selected at retirement, after the current normal instruction's
effects. Eligibility uses the post-retirement `csr_irq_context_t`:

```text
mstatus.MIE && mie.MTIE && mip.MTIP
```

The interrupt saves `ex_wb_pkt_t.next_pc`, not the retiring instruction PC. A
synchronous exception has priority. MRET excludes a same-boundary interrupt,
and `irq_defer_i` waits for an LSU/divider owner to complete.

WFI retires once, saves `next_pc`, kills younger packets, and leaves only a
logical wait record. WFI wake creates `trap_entry_t` without another
instruction commit or `minstret` increment. See
[`AR008_PRECISE_MACHINE_TIMER_INTERRUPTS.md`](ar/AR008_PRECISE_MACHINE_TIMER_INTERRUPTS.md).

### 11.5 Timer registers

The timer target receives local offsets from the fabric:

| Offset | Meaning |
|---:|---|
| `0x4000/0x4004` | `mtimecmp` low/high |
| `0xBFF8/0xBFFC` | `mtime` low/high |

MTIP is the level `mtime >= mtimecmp`. RV32 software replaces `mtimecmp` with
the safe low-all-ones, high, low sequence. Only aligned word accesses are
implemented in this milestone.

### 11.6 Official FreeRTOS context path

The Phase 6 application points the startup `trap_entry` symbol at the official
FreeRTOS `freertos_risc_v_trap_handler`. That assembly code, not repository
glue, owns the task stack frame, integer-register save/restore, ECALL yield,
timer-tick update, scheduler call, and `mret`.

The selected upstream chip header declares an MTIME/CLINT-compatible target
with no extra implementation-specific registers. The existing CPU already
supplies direct `mtvec`, ECALL, `mret`, `mhartid=0`, and the required M-mode CSR
bits, so the integration changes no RTL and needs no atomic `A` extension.

`heap_4.c` reserves 24 KiB in data BRAM. Task stacks come from that heap, while
the pre-scheduler 4 KiB main stack becomes the interrupt stack through
`__freertos_irq_stack_top`. The linker rejects overlap and RAM overflow.

The focused demo uses LED, heartbeat, queue producer, and queue receiver tasks.
The producer wraps a send with `s2`-`s11` sentinels; waking the higher-priority
receiver forces a scheduler switch, and any failed restore prevents PASS. See
[`AR025_OFFICIAL_FREERTOS_RISCV_PORT.md`](ar/AR025_OFFICIAL_FREERTOS_RISCV_PORT.md).

The short profile completes quickly and remains the normal release gate. The
separately tagged soak raises completion to 1,000 tick hooks and ordered queue
receives, 100 GPIO updates, and 50 heartbeats. Firmware failure hooks and
context checks are combined with independent commit-order, timer, UART, and
GPIO scoreboards, extending runtime evidence without changing production
defaults or the vendored kernel.

## 12. Architectural commit interface

`commit_o` is the stable observation record for each valid retired instruction.
It includes:

- monotonically increasing order;
- PC and instruction;
- destination-register address/data/write enable;
- memory address, masks, read data, and write data;
- trap flag, cause, and trap value.

A trapping instruction is reported as:

```text
valid = 1
trap  = 1
rd_we = 0
```

An interrupt after a normal instruction does not set that instruction's commit
`trap` bit. The separate `trap_entry_t` observation reports asynchronous entry.
This keeps commit trace semantics truthful and supports regression checking,
future differential testing, and debugging without fragile internal names.

## 13. Verification workflow

### 13.1 Main commands

From PowerShell:

```powershell
Set-Location D:\Rsicv-soc-worktrees\phase2-act4-cleanup\sim\regress
Set-ExecutionPolicy -Scope Process -ExecutionPolicy Bypass
./run_regression.ps1 -Tag smoke
./run_regression.ps1 -Manifest ./phase3_tests.json -Test soc_timer_wfi
./run_regression.ps1 -Manifest ./phase3_tests.json -Test soc_timer_10k
./run_regression.ps1 -Manifest ./phase4_tests.json -Test soc_uart_hello
./run_regression.ps1 -Manifest ./phase4_tests.json -Test soc_uart_echo
./run_regression.ps1 -Manifest ./phase4_tests.json -Test soc_gpio_out
./run_regression.ps1 -Manifest ./phase5_tests.json -Tag phase5
./run_regression.ps1 -Manifest ./phase6_tests.json -Tag phase6
./run_regression.ps1 -Manifest ./phase6_tests.json -Tag phase6-soak
./test_regression_result.ps1
python -m unittest test_elf_to_mem.py test_import_act4.py
```

From the repository root, validate generated SoC-map consumers with:

```powershell
python tools/gen_soc_map.py --check
python -m unittest tools/test_gen_soc_map.py
```

For the original single testbench:

```powershell
Set-Location D:\Rsicv-soc-worktrees\phase2-act4-cleanup\sim
vsim -do run.do
vsim -c -do run_decode_fetch_error.do
vsim -c -do run_fetch_error_timing.do
vsim -c -do run_retire_stage.do
vsim -c -do run_csr_retire_order.do
vsim -c -do run_mtime_timer.do
vsim -c -do run_soc_data_fabric.do
vsim -c -do run_uart_tx.do
vsim -c -do run_uart_rx.do
vsim -c -do run_core_bus_uart.do
vsim -c -do run_core_bus_uart_rx.do
vsim -c -do run_core_bus_gpio.do
```

The current out-of-context synthesis check consumes the retirement, timer,
UART, and GPIO source list:

```powershell
Set-Location D:\Rsicv-soc-worktrees\phase2-act4-cleanup\sim\synth
& 'D:\vivado\Vivado\2019.2\bin\vivado.bat' `
  -mode batch -source .\check_riscv_soc_ar003.tcl
```

The verified result is 0 errors, 0 critical warnings, 32 retained BRAM cells,
2 synthesized LSU-state cells, 389 UART-hierarchy objects, and 20
GPIO-hierarchy objects. This is an OOC structural result, not exact-board
timing closure.

Phase 5 also has a dedicated initialization check using the exact firmware
images produced by the bare-metal build:

```powershell
Set-Location D:\Rsicv-soc-worktrees\phase2-act4-cleanup\sim\synth
& 'D:\vivado\Vivado\2019.2\bin\vivado.bat' `
  -mode batch -source .\check_phase5_firmware_init.tcl
```

That check retains 16 program and 16 data `RAMB36E1` cells and finds nonzero
initialization properties in both banks. It proves that Vivado consumes both
images through the synthesizable top-level parameters; it does not prove the
provisional part matches the final board or replace implementation/timing and
pin-level testing.

### 13.2 Result reporting

Tests finish by committing a store to the configured `tohost` address:

- value `1`: PASS;
- another nonzero value: test-specific failure code.

The core exposes no halt output. A committed `tohost` store is the test
completion mechanism, and `commit_pkt_t` is the ordered retirement observation.

The regression runner classifies a test as PASS only when the native simulator
exit is zero, the architectural PASS marker is present, no fatal marker is
present, and ModelSim reports zero errors. The focused AR-013 infrastructure
test supplies a PASS-looking transcript with a nonzero simulator exit and
proves that it is rejected.

### 13.3 Debug from architecture inward

Use this order:

1. Read the first failing assembly check and its failure code.
2. Inspect `commit_o` for the first incorrect architectural result.
3. Decide whether the error began in fetch, decode, EX, memory, CSR, or
   retirement.
4. Inspect packet validity and PC/instruction pairing at that boundary.
5. Inspect control signals only after locating the failing instruction.
6. Turn the failure into a focused regression before changing RTL.
7. Run the focused test, then the full smoke suite and utility tests.

Recommended waveform groups:

- `if2id_pkt_out`, `id2ex_pkt_out`, `ex2wb_pkt_out`;
- `pipe_ctrl`, especially `pc_stall`, `ifid_stall`, `idex_flush`,
  `pipe_kill`, and `ex_kill`;
- `ex_redirect_candidate`, `retire_redirect`, and `selected_redirect`;
- `data_req_valid_o`, `data_req_ready_i`, `data_req_o`;
- `data_rsp_valid_i`, `data_rsp_i`, `lsu_busy`, `lsu_complete`;
- `div_start`, `div_busy`, `div_complete`, `div_wait`, `div_quotient`,
  `div_remainder`;
- `wb_rf_wen_safe`, `wb_rf_waddr`, `wb_rf_wdata`;
- CSR address/read/write/effective values;
- `commit_o`.

### 13.4 Planned UVM growth path

The current testbenches remain the release baseline. UVM will be introduced in
small vertical slices so the new framework is checked against known-good tests
before it begins driving the DUT.

```text
current directed program
        |
        v
registered commit_pkt_t + trap_entry_t
        |
        v
passive commit interface and UVM monitor
        |
        v
retire_event + trap_entry_event -> scoreboard -> tohost/coverage subscribers
```

This is the first step because `commit_pkt_t` already owns the architectural
identity and 64-bit retirement order, while `trap_entry_t` separately reports
synchronous/asynchronous trap entry. A SystemVerilog `interface` will group
clocked physical observations; the two UVM events preserve their distinct
architectural meanings. Later CoreBus, AXI, cache, MMU, GPU, or NPU agents may
change pin-level adapters without changing the retirement scoreboard.

The planned ownership tree and gates are documented in the
[verification framework](../docs/verification_framework.md) and
[`AR026_SCALABLE_UVM_VERIFICATION_ARCHITECTURE.md`](ar/AR026_SCALABLE_UVM_VERIFICATION_ARCHITECTURE.md).

## 14. Design invariants worth memorizing

1. Every architectural side effect requires a valid owner.
2. Every invalid registered packet has one canonical representation.
3. A faulting instruction is valid; a killed instruction is a bubble.
4. Metadata moves with the request or result that gives it meaning.
5. A redirect flush count comes from the number of outstanding responses.
6. The resolved value is validated before its side effect is enabled.
7. WARL-filtered architectural values, not raw operands, are forwarded.
8. Simulation behavior and FPGA resource inference are separate verification
   obligations.
9. Every accepted future bus request must receive exactly one completion.
10. A failure is not fixed until its regression remains in the suite.
11. A completed result's data, status, and identity must cross pipeline
    boundaries together.
12. A post-retirement interrupt preserves the retiring instruction's normal
    effects and saves its resolved `next_pc`.
13. Hardware-pending levels and one-cycle trap-entry events are different
    contracts.
14. WFI is a one-time retirement plus logical state, never a repeatedly valid
    pipeline instruction.
15. Verification reuse boundaries preserve semantic identity and ordering;
    physical protocol conversion remains explicit in an adapter.

## 15. Current architecture risks and open questions

| Topic | Current risk or question | Planned stage |
|---|---|---|
| Blocking LSU performance | Correct but the front end waits for every memory response | Measure before adding a MEM stage/cache |
| Memory-map implementation | Timer/UART/GPIO/RAM/default decode, 64 KiB RTL defaults, and fetch errors are implemented; future consumers must continue using generated constants | Continuous / AR-009/AR-014/AR-019/AR-022 |
| Unmapped access faults | Data load/store and out-of-range instruction fetches trap precisely; canonical fetch-fault packets plus consecutive-invalid, redirect/stale-response, and LSU-stall timing cases are directed and passing | Closed for current fixed-latency interface; revisit for instruction wait states/multiple targets / AR-018 |
| Interrupt boundary | Implemented and verified; broader randomized boundary coverage remains useful | Continuous verification / AR-008/AR-010 |
| Timer | Implemented word-access timer and polling/interrupt firmware APIs; both exact-board LED-visible timer profiles pass physically | Closed for bare-metal baseline / AR-024 |
| RV32M timing | AR-030's registered blocking backend removes multiply from the critical path, retains 4 DSPs, and passes 95 MHz at WNS +0.430 ns. It adds four cycles per MUL (+2.42% on `p0_mix`) but lowers dynamic power 6.30% and energy/work 4.03%. The 100 MHz SoC route remains -0.312 ns on `mtime_q -> EX/WB`, not multiplication | Registered multiplier closed for 95 MHz; address timer/read-to-writeback path only in a separately scoped 100 MHz phase / AR-030 |
| Central control timing | AR-031 closes the exact current 95/100 MHz routes at +0.078/+0.098 ns, but the worst path now runs from an ID/EX operand through branch/redirect selection to ID/EX enable and is route dominated | Closed for current target; pipeline or register the redirect/control boundary before raising frequency/depth / AR-031 |
| Retirement ownership | `retire_stage` is the owner; obsolete `halt_o` is removed and the public-interface cleanup is verified | Closed / AR-012 |
| Peripherals | Timer, GPIO, and external polling-UART TX pass physically; UART RX remains pin-level simulated, while UART interrupts/PLIC are deferred | Closed for first polling baseline; future interrupt phase if justified |
| UART RX capacity | The 16-byte default FIFO tolerates bounded polling latency but sustained traffic can still overrun | Firmware must monitor errors; revisit interrupts/DMA only after board baseline |
| Power and clock gating | Logical WFI and six 95 MHz activity-derived P0 workload estimates are verified, but direct SAIF mapping is only about 5.5% and no safe FPGA clock gating exists. P1 later uses clock enables/vendor clock resources and keeps wake sources alive | P0 then P1 / AR-028 |
| Reset-to-BRAM control | Deliberate K2 restart testing passes and reset deassertion is synchronized, but Vivado `REQP-1839` still warns that asynchronously reset control registers feed data-BRAM address/control logic | Keep warning visible; synchronous-reset cleanup if later behavior requires it / AR-024 |
| FreeRTOS duration/hardware | Focused and extended preemption/queue/context checks pass in ModelSim; physical production output adds 537 retained heartbeats, D1 activity, and repeatable K2 restarts | Closed for first FPGA demonstration / AR-025 |
| Documentation status and context | Duplicated status or broad recursive reading can obscure the active task | Route through `CONTEXT_ROUTER.md`, keep inbox notes non-authoritative, and run the governance checker / AR-033 |
| UVM scalability | AR-026 accepts the abstraction and the installed ModelSim/UVM 1.2 compile/runtime plus false-marker gate pass. This proves technical availability on this host, not license entitlement or DUT integration; no passive monitor/scoreboard/coverage result exists | Optional parallel U0 / AR-026 |

## 16. Practical study exercises

### Exercise 1: Follow one ADD

Run one test with trace enabled. Write down the ADD instruction's PC, source
values, ID/EX controls, ALU result, EX/WB destination, and commit record.

### Exercise 2: Observe one RAW bubble

Use two dependent arithmetic instructions. Identify:

- the comparison that raises `hazard_stall`;
- the held IF/ID packet;
- the canonical ID/EX bubble;
- the WB-to-register-read bypass;
- the consumer's eventual correct commit.

### Exercise 3: Follow a taken branch

Mark the branch request, target calculation, redirect edge, flushed younger
packets, stale program-memory response, and first target instruction.

### Exercise 4: Follow a trap

Use ECALL or a misaligned target. Record:

- the faulting instruction's PC;
- `mcause`, `mepc`, and `mtval`;
- which younger instruction was in EX;
- why that younger instruction could not update GPR/CSR/memory;
- the first instruction fetched from `mtvec`.

### Exercise 5: Check load byte lanes

Place four known bytes in a word. Execute LB/LBU/LH/LHU at legal offsets and
compare RAM data, `load_offset`, extracted value, and committed result.

## 17. Where to read next

- [Task-specific context router](CONTEXT_ROUTER.md)
- [Post-FreeRTOS roadmap and learning path](ROADMAP_AND_LEARNING_PATH.md)
- [Research program, decision gates, and W0 workload plan](RESEARCH_PROGRAM_PLAN.md)
- [Research source registry and first reading queue](research/SOURCE_REGISTRY.md)
- [Research directory and source-handling rules](research/README.md)
- [Paper audit and reproduction template](research/PAPER_AUDIT_TEMPLATE.md)
- [Phase evidence package template](PHASE_EVIDENCE_TEMPLATE.md)
- [Phase planning/evidence index](plans/README.md)
- [Engineering reference index](REFERENCE_INDEX.md)
- [Release readiness checklist](RELEASE_CHECKLIST.md)
- [License and IP strategy](LICENSE_STRATEGY.md)
- [P0 power-baseline requirements](plans/p0-power-baseline/requirements.md)
- [P0 six-scenario results and limitations](plans/p0-power-baseline/results.md)
- [AR-028 P0 95 MHz mapping decision and measured workloads](ar/AR028_P0_95MHZ_ACTIVITY_MAPPING_AND_WORKLOAD_BASELINE.md)
- [Architecture design and decisions](ARCHITECTURE_DESIGN_AND_DECISIONS.md)
- [AR-033 documentation governance and context routing](ar/AR033_DOCUMENT_GOVERNANCE_AND_CONTEXT_ROUTING.md)
- [Architecture review and action plan](ARCHITECTURE_REVIEW_AND_ACTION_PLAN.md)
- [Verification framework](../docs/verification_framework.md)
- [Memory-map and bus design guide](MEMORY_MAP_CONTRACT_DESIGN_GUIDE.md)
- [AR-009 accepted architectural memory map](ar/AR009_ARCHITECTURAL_MEMORY_MAP.md)
- [AR-016 core-to-SoC environment contract](ar/AR016_CORE_TO_SOC_ENVIRONMENT_CONTRACT.md)
- [AR-001 precise CSR squash](ar/AR001_PRECISE_CSR_SQUASH_FIX.md)
- [AR-002 canonical bubbles](ar/AR002_CANONICAL_PIPELINE_BUBBLES.md)
- [AR-005 synchronous instruction BRAM](ar/AR005_SYNCHRONOUS_INSTRUCTION_BRAM.md)
- [AR-006 control-flow misalignment](ar/AR006_CONTROL_FLOW_MISALIGNMENT.md)
- [AR-007 CSR contract](ar/AR007_CSR_LEGALITY_WARL_AND_HAZARDS.md)
- [AR-008 precise machine-timer interrupts](ar/AR008_PRECISE_MACHINE_TIMER_INTERRUPTS.md)
- [AR-012 retirement and public-interface cleanup](ar/AR012_RETIREMENT_INTERFACE_CLEANUP.md)
- [Semantic signal specification](SEMANTIC_SIGNAL_SPEC.md)
- [AR-013 regression exit-status gate](ar/AR013_REGRESSION_EXIT_STATUS_GATE.md)
- [AR-014 machine-readable SoC map](ar/AR014_MACHINE_READABLE_SOC_MAP.md)
- [AR-015 RAM-capacity utilization and timing comparison](ar/AR015_RAM_CAPACITY_UTILIZATION_COMPARISON.md)
- [AR-016 core-to-SoC environment contract](ar/AR016_CORE_TO_SOC_ENVIRONMENT_CONTRACT.md)
- [AR-017 Radix-2 iterative divider](ar/AR017_RADIX2_ITERATIVE_DIVIDER.md)
- [AR-018 SoC fabric RED tests](ar/AR018_SOC_FABRIC_RED_TESTS.md)
- [AR-019 centralized data fabric](ar/AR019_CENTRALIZED_DATA_FABRIC.md)
- [AR-020 minimal polling UART TX](ar/AR020_MINIMAL_POLLING_UART_TX.md)
- [AR-021 polling UART RX and parameterized FIFO](ar/AR021_POLLING_UART_RX_FIFO.md)
- [AR-022 memory-mapped GPIO output](ar/AR022_MEMORY_MAPPED_GPIO_OUTPUT.md)
- [AR-023 Phase 5 bare-metal runtime](ar/AR023_PHASE5_BARE_METAL_RUNTIME.md)
- [AR-024 ZYNQ MINI REVB FPGA integration](ar/AR024_ZYNQ_MINI_REVB_FPGA_INTEGRATION.md)
- [AR-025 official FreeRTOS RISC-V port](ar/AR025_OFFICIAL_FREERTOS_RISCV_PORT.md)
- [AR-026 scalable UVM verification architecture](ar/AR026_SCALABLE_UVM_VERIFICATION_ARCHITECTURE.md)
- [AR-027 common-library and multiplier-pipeline review](ar/AR027_RTL_COMMON_AND_MULTIPLIER_PIPELINE_REVIEW.md)
- [AR-029 fixed RV32 contract and refactoring scope](ar/AR029_RV32_CONTRACT_AND_REFACTORING_SCOPE.md)
- [Revised core refactoring specification](../RISC-V_Core_Refactoring_Spec.md)
- [Phase 4 UART implementation guide](../docs/phase4-uart-guide.md)
- [Phase 4 GPIO implementation guide](../docs/phase4-gpio-guide.md)
- [Phase 5 startup/runtime implementation guide](../docs/phase5-startup-runtime-guide.md)
- [ZYNQ MINI REVB build and wiring guide](../fpga/zynq_mini_revb/README.md)
- [ACT4 integration](../verif/act4/README.md)
- [ACT4 2026-08-17 compact baseline evidence](evidence/act4/BASELINE_2026-08-17.md)
- [Clean-worktree release baseline, 2026-08-18](evidence/release/BASELINE_2026-08-18.md)
- [Release-verification command](../sim/regress/README.md#one-command-release-verification)
- [Interview preparation guide](../docs/INTERVIEW_GUIDE.md)
- [Project roadmap](../TODO.md)

## 18. Living-document update checklist

When the project changes, update the relevant sections before calling the work
complete:

- [ ] Current status and milestone.
- [ ] System and timing diagrams.
- [ ] Repository/module map.
- [ ] Packet fields and ownership.
- [ ] Instruction, memory, trap, or interrupt flow.
- [ ] Build and regression commands.
- [ ] Current verification result.
- [ ] Risks and open questions.
- [ ] Learning exercises when a new concept is introduced.
- [ ] Cross-link to the detailed architecture decision entry.
