HeTPort/Rsicv-soc/doc/evidence/release/BASELINE_2026-08-18.md

# Clean-Worktree Release Baseline — 2026-08-18

## Purpose and scope

This record retains the clean-worktree evidence for the local release
follow-ups: the precise illegal-JALR regression, the extended FreeRTOS soak,
and the ACT4-regeneration wrapper correction. It does not close physical UART,
repeated-reset, speed-grade-identification, or FreeRTOS-on-board gates.

The exact modified tree was captured as detached snapshot
`f5e97da39966a673dc1a2861b974438d1a433cd5` and checked out into a new Git
worktree. `git status --porcelain=v2 --branch` reported only the detached HEAD
metadata and no tracked or untracked changes before verification.

## Problem found by the first clean run

The first `-RegenerateAct4` attempt passed every local gate but failed before
ACT4 generation. `run_release_verification.ps1` constructed
`@("-Jobs", $Act4Jobs)` and splatted that array after explicit `-Extension I`.
For a PowerShell script call, the array elements were positional arguments, so
the literal string `-Jobs` was bound as the integer `Jobs` value.

Named hashtable splatting was selected over manual positional ordering because
it preserves the meaning of `Jobs`, `Act4Root`, `Act4WorkDir`, and `WslRepoPath`
independently of parameter order. The corrected snapshot was recreated from
scratch and the complete command was rerun.

## Command

From `sim/regress/` in the detached worktree:

```powershell
Set-ExecutionPolicy -Scope Process -ExecutionPolicy Bypass
.\run_release_verification.ps1 -RegenerateAct4 -Act4Jobs 8
```

## Result

The corrected clean-worktree run completed successfully in 549.2 seconds wall
time. The release wrapper reported:

| Gate | Result | Seconds |
|---|---:|---:|
| Generated SoC map current | PASS | 0.26 |
| Map-generator tests | 9/9 PASS | 0.38 |
| ELF converter / ACT4 importer tests | 12/12 PASS | 0.74 |
| Regression-result classifier | PASS | 0.08 |
| Focused SoC data fabric | PASS | 5.36 |
| Directed smoke, including illegal JALR | 23/23 PASS | 120.45 |
| Phase 3 timer / 10,000 IRQ | 2/2 PASS | 25.70 |
| Phase 4 UART/GPIO | 3/3 PASS | 16.32 |
| Phase 5 firmware | 4/4 PASS | 21.71 |
| Phase 6 focused FreeRTOS | 1/1 PASS | 9.44 |
| Regenerate ACT4 RV32I | 195/195 build jobs; 39 imported | 104.97 |
| Regenerate ACT4 RV32M | 40/40 build jobs; combined 47 imported | 5.27 |
| ACT4 manifest classification | 47 total / 39 I / 8 M | 0.09 |
| Applicable ACT4 execution | 47/47 PASS | 237.11 |

The regenerated manifest SHA-256 was
`7632F0666E75D7556F2F2D9CF7117ECCEFB5296F7C5F3404FE1ED50D72A75C2C`.
All selected simulator processes exited zero.

## Separate extended FreeRTOS evidence

The long soak is deliberately excluded from the fast unified release tag. Its
separate 2026-08-18 run passed at 7,262,975 cycles with committed `tohost=1`,
1,428 observed timer interrupts, 1,579 valid UART bytes, 286 alternating GPIO
transitions, native simulator exit zero, and no ModelSim errors. Firmware
completion additionally requires 1,000 ordered queue receives, 1,000 tick
hooks, and the `s2`-`s11` context-sentinel checks.

## Conclusion

The local clean-checkout and ACT4-configuration gates are closed. Remaining
release work requires physical evidence or belongs to explicitly deferred
continuous-verification items; it is not hidden by this baseline.
