HeTPort/Rsicv-soc/doc/ar/README.md

# Architecture Review Index

Numbered Architecture Review (AR) reports live in this directory. They retain
focused problem statements, options, decisions, consequences, and verification
evidence. This index is for discovery; implementation status remains owned by
`TODO.md` and the applicable phase `results.md`.

AR numbers are stable identifiers. Missing numbers are historical gaps and are
not renumbered. New reports use the next unused number and are linked from the
architecture decision log and relevant phase package.

- [AR-001 Precise CSR Squash Fix](AR001_PRECISE_CSR_SQUASH_FIX.md)
- [AR-002 Canonical Pipeline Bubble Fix](AR002_CANONICAL_PIPELINE_BUBBLES.md)
- [AR-003 — Wait-State-Safe LSU Transaction Control](AR003_WAIT_STATE_SAFE_LSU.md)
- [AR-004 Registered Memory Result and Access-Fault Completion](AR004_REGISTERED_MEMORY_RESULT.md)
- [AR-005 Synchronous Instruction BRAM](AR005_SYNCHRONOUS_INSTRUCTION_BRAM.md)
- [AR-006 Precise Control-Flow Misalignment Fix](AR006_CONTROL_FLOW_MISALIGNMENT.md)
- [AR-007 — CSR Legality, WARL, No-Write Semantics, and Dependencies](AR007_CSR_LEGALITY_WARL_AND_HAZARDS.md)
- [AR-008 — Precise Machine-Timer Interrupt Retirement](AR008_PRECISE_MACHINE_TIMER_INTERRUPTS.md)
- [AR-009 Architectural Memory Topology and Map](AR009_ARCHITECTURAL_MEMORY_MAP.md)
- [AR-012 — Retirement and public-interface cleanup](AR012_RETIREMENT_INTERFACE_CLEANUP.md)
- [AR-013 Regression Simulator Exit-Status Gate](AR013_REGRESSION_EXIT_STATUS_GATE.md)
- [AR-014 Machine-Readable SoC Map](AR014_MACHINE_READABLE_SOC_MAP.md)
- [AR-015 RAM-Capacity Utilization and Timing Comparison](AR015_RAM_CAPACITY_UTILIZATION_COMPARISON.md)
- [AR-016 Core-to-SoC Environment Contract](AR016_CORE_TO_SOC_ENVIRONMENT_CONTRACT.md)
- [AR-017 — Radix-2 iterative divider timing optimization](AR017_RADIX2_ITERATIVE_DIVIDER.md)
- [AR-018 — SoC fabric contract tests](AR018_SOC_FABRIC_RED_TESTS.md)
- [AR-019 — Centralized data decoder and registered default target](AR019_CENTRALIZED_DATA_FABRIC.md)
- [AR-020 — Minimal Polling UART TX](AR020_MINIMAL_POLLING_UART_TX.md)
- [AR-021 — Polling UART RX with a Parameterized FIFO](AR021_POLLING_UART_RX_FIFO.md)
- [AR-022 — Memory-Mapped GPIO Output](AR022_MEMORY_MAPPED_GPIO_OUTPUT.md)
- [AR-023 — Phase 5 Bare-Metal Runtime and FPGA-Equivalent Images](AR023_PHASE5_BARE_METAL_RUNTIME.md)
- [AR-024 — ZYNQ MINI REVB FPGA Integration](AR024_ZYNQ_MINI_REVB_FPGA_INTEGRATION.md)
- [AR-025 — Official FreeRTOS RISC-V Port Integration](AR025_OFFICIAL_FREERTOS_RISCV_PORT.md)
- [AR-026 — Scalable UVM Verification Architecture](AR026_SCALABLE_UVM_VERIFICATION_ARCHITECTURE.md)
- [AR-027 — RTL Common-Library and Multiplier-Pipeline Review](AR027_RTL_COMMON_AND_MULTIPLIER_PIPELINE_REVIEW.md)
- [AR-028 — P0 95 MHz Activity Mapping and Workload Baseline](AR028_P0_95MHZ_ACTIVITY_MAPPING_AND_WORKLOAD_BASELINE.md)
- [AR-029 — RV32 Contract and Refactoring Scope](AR029_RV32_CONTRACT_AND_REFACTORING_SCOPE.md)
- [AR-030 — Registered Blocking Multiplier](AR030_REGISTERED_BLOCKING_MULTIPLIER.md)
- [AR-031 — Core Control Ownership Consolidation](AR031_CORE_CONTROL_OWNERSHIP.md)
- [AR-032 — P3 Semantic and Code Cleanup](AR032_P3_SEMANTIC_CODE_CLEANUP.md)
- [AR-033 — Document Governance and Just-in-Time Context Routing](AR033_DOCUMENT_GOVERNANCE_AND_CONTEXT_ROUTING.md)
- [AR-034 — Independent Specification-First Core V2 Rewrite](AR034_SPEC_FIRST_CORE_V2_REWRITE.md)
