HeTPort/Rsicv-soc/doc/evidence/board_20260823/putty_freertos_heartbeats.png

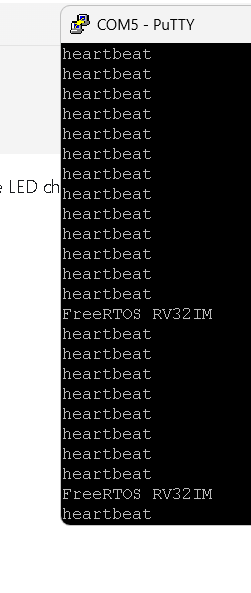
doc/evidence/board_20260823/putty_freertos_heartbeats.png
