HeTPort/Rsicv-soc/doc/evidence/board_20260823/putty_hello_to_freertos.png

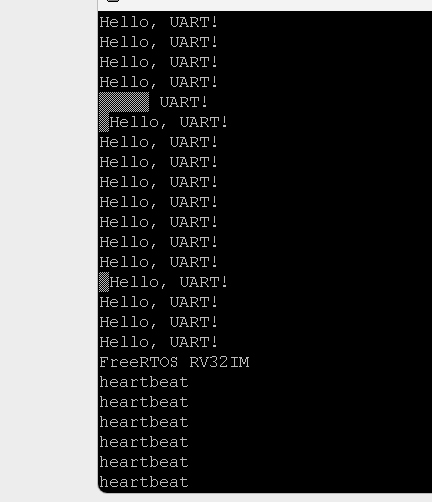
doc/evidence/board_20260823/putty_hello_to_freertos.png
