HeTPort/Rsicv-soc/doc/plans/core-v2-foundation/results.md

# CV2 Foundation Results

**Phase:** CV2 / core-v2-foundation

**Status:** Implemented documentation; governance/whitespace checks passed; new RTL/tests NOT RUN

**Owner:** Project owner / assistant

**Last updated:** 2026-10-18

**Depends on:** [requirements](requirements.md), [verification plan](verification_plan.md)

**Related evidence:** [AR-034](../../ar/AR034_SPEC_FIRST_CORE_V2_REWRITE.md)

## Tested identity

- Source/base commit: `e88bb3b62efa7074390bb948b96dfb1c3837a1de`.
- New local branch: `codex/core-v2-spec-first`, based on current worktree HEAD.
- Source changes: phase/decision/living documentation only; no v2 RTL/model/test exists yet.
- Git: `2.55.0.windows.2`; PowerShell: `7.6.5`; Python: `3.12.9`.
- Unrelated untracked `.analysis/`, `deliverables/`, `interview_deck_build/`,
  `interview_deck_planning/`, `output/` preserved.

## Actual commands and results

| Command | Native exit | Result |
| --- | --- | --- |
| `git status --short` | 0 | Starting tracked files clean; unrelated untracked directories present |
| `git branch --show-current` | 0 | Starting branch codex/phase2-act4-cleanup |
| `git rev-parse HEAD` | 0 | Base identity recorded above |
| `git switch -c codex/core-v2-spec-first` (sandbox) | 1 | Cannot create ref lock in parent Git common directory; no branch created |
| `git switch -c codex/core-v2-spec-first` (approved elevation) | 0 | New local branch created/switched; no commit or push |
| `& ./tools/check_doc_governance.ps1` | 0 | PASS: 114 Markdown files, 627 local links, AGENTS.md 188 lines |
| `git diff --check` | 0 | Tracked documentation diff clean; CRLF conversion warnings only |
| `git diff --no-index --check -- NUL <new-document>` (initial, each of six new docs) | 3 each | Found Markdown hard-break trailing spaces; replaced with separate metadata paragraphs |
| `git diff --no-index --check -- NUL <new-document>` (corrected, all six new docs) | 1 each | PASS: only expected no-index addition differences; no whitespace diagnostics; wrapper exit 0 |

The first whitespace wrapper incorrectly classified native no-index exit 1 as
a failure. Git no-index reports differences against NUL even when whitespace
is clean; corrected classification retains that native status. Exit 3 in the
initial run included actual whitespace errors and was repaired, not waived.

## Delivered artifacts

[requirements](requirements.md)、[architecture/directory ownership](architecture.md)、
[verification plan](verification_plan.md)、[first ALU specification](modules/alu.md)、
[AR-034](../../ar/AR034_SPEC_FIRST_CORE_V2_REWRITE.md)，以及相应 living-document 路由。

## RTL, regression, synthesis and hardware evidence

v2 lint/elaboration、module/cluster/core tests、ISS、formal、ACT4、UVM DUT monitor、
firmware、synthesis/route、power、board 均为 **NOT RUN**。
v1 historical passes are not new results and no v1 RTL/build manifest changed.

## Limitations and exit verdict

仅完成规格/验证工作流起点；没有生成或实现用户计划自主编写的 RTL。
Foundation documentation gate PASS；G0 ALU spec remains
Draft；G1–G5 new-DUT gates NOT RUN。

## Information-classification review

Generic engineering process and public reference links only. No third-party code,
private plant data or credentials imported. On 2026-10-18, the project owner
explicitly requested committing and pushing this branch for review on GitHub.
This documentation scope is classified DATA-PUBLIC for that authorized publication;
unrelated local/untracked directories and ignored agent plans are excluded.
Publication does not establish any new RTL, simulation or physical evidence.

## Decision outcome

**GO for the specification/model/user-RTL learning workflow.** This verdict
covers branch and foundation documentation only. Product/core correctness,
performance and power outcomes remain NOT RUN.
