HeTPort/Rsicv-soc/doc/evidence/ar018_soc_fabric_red/red_results.txt

AR=AR-018
DATE=2026-08-02
STATUS=RED_CONTRACT_VERIFIED_IMPLEMENTATION_OPEN

COMMON_COMPILE_ERRORS=0
COMMON_COMPILE_WARNINGS=20

SOC_RED_SELECTED=3
SOC_RED_EXPECTED_FAIL=3
SOC_RED_OBSERVED_FAIL=3
SOC_RED_RUNNER_EXIT=1

SOC_UNMAPPED_LOAD_RESULT=FAIL_CODE_6_EXECUTION_CONTINUED
SOC_UNMAPPED_LOAD_SIMULATOR_EXIT=0

SOC_UNMAPPED_STORE_RESULT=FAIL_CODE_6_EXECUTION_CONTINUED
SOC_UNMAPPED_STORE_SIMULATOR_EXIT=0

SOC_INVALID_FETCH_RESULT=FAIL_CODE_2_WRONG_CAUSE_EBREAK_SUBSTITUTED
SOC_INVALID_FETCH_SIMULATOR_EXIT=0

UNAFFECTED_DIRECTED_SMOKE=22_OF_22_PASS
UNAFFECTED_SIMULATOR_EXITS=ALL_ZERO
REGRESSION_CLASSIFIER_RESULT=PASS

GREEN_REQUIRES=DECODER_DEFAULT_TARGET_LOCAL_ADDRESS_REGISTERED_RESPONSE_OWNER_AND_FETCH_CAUSE_1
