HeTPort/Rsicv-soc/doc/evidence/ar017_divider/optimization_results.txt

AR=AR-017
DATE=2026-08-01
STATUS=IMPLEMENTED_AND_FUNCTIONALLY_VERIFIED
PART=xc7z010clg400-1
VIVADO_VERSION=2019.2
ANALYSIS_STAGE=OUT_OF_CONTEXT_POST_SYNTHESIS_STATIC_TIMING

DIVIDER=RESTORING_RADIX_2
DATA_WIDTH=32
ITERATION_CYCLES=32
KILL_SUPPORTED=YES

FOCUSED_DIVIDER_CASES=42
FOCUSED_DIVIDER_RESULT=PASS
RV32IM_INTEGRATION_RESULT=2_OF_2_PASS
DIRECTED_SMOKE_RESULT=22_OF_22_PASS
LSU_PROTOCOL_RESULT=PASS
REGRESSION_CLASSIFIER_RESULT=PASS

RAM_16K_BASELINE_LUT=7861
RAM_16K_ITERATIVE_LUT=3504
RAM_16K_BASELINE_REG=2465
RAM_16K_ITERATIVE_REG=2601
RAM_16K_RAMB36=8
RAM_16K_DSP=12

RAM_64K_BASELINE_LUT=7902
RAM_64K_ITERATIVE_LUT=3542
RAM_64K_BASELINE_REG=2467
RAM_64K_ITERATIVE_REG=2601
RAM_64K_RAMB36=32
RAM_64K_DSP=12

BASELINE_DATAPATH_DELAY_NS=87.102
BASELINE_LOGIC_LEVELS=305
BASELINE_50MHZ_WNS_NS=-67.124
BASELINE_25MHZ_WNS_NS=-47.124

ITERATIVE_DATAPATH_DELAY_NS=12.605
ITERATIVE_LOGIC_LEVELS=19
ITERATIVE_50MHZ_WNS_NS=7.373
ITERATIVE_50MHZ_TNS_NS=0.000
ITERATIVE_50MHZ_FAILING_ENDPOINTS=0
ITERATIVE_25MHZ_WNS_NS=27.373
ITERATIVE_25MHZ_TNS_NS=0.000
ITERATIVE_25MHZ_FAILING_ENDPOINTS=0
ITERATIVE_TIMING_IDENTICAL_FOR_16K_AND_64K=YES

NEW_CRITICAL_STARTPOINT=u_riscv/u_id2ex/pkt2ex_q_reg[ex_data][op1][16]/C
NEW_CRITICAL_ENDPOINT=u_riscv/u_ex2wb/pkt2wb_q_reg[alu_data][31]/D
NEW_CRITICAL_RESOURCES=CARRY4_12_DSP48E1_2_LUT2_1_LUT4_2_LUT6_2

LIMITATION=NOT_PLACED_OR_ROUTED_NO_EXACT_BOARD_XDC_NO_IO_TIMING_NO_ROUTED_FMAX
