HeTPort/Rsicv-soc/doc/evidence/ar015_ram_capacity/ram_64k_experiment_metadata.txt

SOURCE_MAP=freertos_64k_proposal
SOURCE_STATUS=proposed
PROFILE=ram_64k
PART=xc7z010clg400-1
VIVADO_VERSION=2019.2
BANK_BYTES=65536
DEPTH_WORDS=16384
RAMB18E1_COUNT=0
RAMB36E1_COUNT=32
