HeTPort/Rsicv-soc/doc/plans/p3-semantic-cleanup/results.md

# P3 Semantic Cleanup Results

**Phase:** p3-semantic-cleanup
**Status:** Verified
**Owner:** RTL architecture and verification
**Last updated:** 2026-09-25

| Gate | Result | Evidence |
|---|---|---|
| Structural naming | PASS | No selected internal declaration ends in `_i/_o`; suffixes remain on ports |
| Canonical packet construction | PASS | No scattered `assign decoded_pkt.*` or `assign pkt_exe_o.*`; both builders start from their typed bubble |
| Compile and fetch safety | PASS | Full hierarchy: 0 errors; decode fetch-error PASS; fetch timing 3/3 PASS |
| Control/retirement/protocol | PASS | core control 10/10; retirement, CSR ordering, and LSU protocol PASS |
| RV32M | PASS | registered multiplier 175/175; divider 42/42 |
| Smoke | PASS | 23/23 |
| ACT4 | PASS | 39 RV32I + 8 RV32M = 47/47 |
| Layered lint | PASS | Verilator 5.032 leaf/core/SoC |
| Diff integrity | PASS | `git diff --check` has no whitespace errors; only host LF/CRLF notices |

## Exit verdict

PASS. REQ-CLEAN-001/002, SAFE-CLEAN-001/002/003, and QUAL-CLEAN-001 are
satisfied. The accepted change is a behavior-preserving source cleanup, not an
area, frequency, or power optimization.

No Vivado implementation was rerun. The change adds no state, stage, interface,
physical constraint, or new critical Boolean equation, so a new route would
primarily measure implementation noise. AR-031's exact +0.078 ns at 95 MHz and
+0.098 ns at 100 MHz remain the current routed baseline, not fresh P3 evidence.

No `registers.rdl` applies because this phase adds no MMIO. No diagram update
applies because module ownership and the data/control path are unchanged.
