HeTPort/Rsicv-soc/TODO.md

# TODO.md — From a Custom RV32IM SoC Toward a Propulsion Research Platform

## Program vision, current position, and active target

The long-term goal is not merely to finish a small SoC. It is to explore an
atmospheric propulsion and control platform combining a mechanically compressed
inlet/front end with electrically assisted or electric propulsion at altitude,
supported by safe power electronics, sensing, closed-loop control, and
heterogeneous computation.

The current repository is only the **small control-SoC foundation**. It does not
yet implement or prove a power-management platform, motor/compressor controller,
plant model, thrust-producing device, or flight system.

| Program level | Exit evidence | Status |
| --- | --- | --- |
| Small control SoC | RV32IM + timer/UART/GPIO + firmware/FreeRTOS + FPGA execution | **Complete baseline** |
| Reproducible power measurement | Representative activity maps to matching 95 MHz routes and repeats within the gate | **P0 six-class technical portfolio verified; board-rail/ASIC power unmeasured** |
| Research workload basis | Audited algorithms, deterministic domain corpus, common data model, and CPU/WCET profiles | Planned W0; source registry and audit template created |
| Power-aware SoC state | Hardware counters and a truthful, wake-safe low-power state | Planned P1 after P0 |
| Safe control and low-order model | C0 PWM/capture/watchdog/fault kill plus M0 motor/inverter/compressor/flow MIL/SIL | Planned parallel C0/M0 wave |
| Sampled data and bench correlation | C1 ADC/SPI/IRQ/DMA followed by M1 HIL and low-energy measurements | Planned C1/M1 |
| Optional acceleration | Profiled A0 accelerator; RVV/NPU/GPU only after measured entry gates | Deferred |
| Propulsion feasibility and integration | Energy/thermal/flow/mission evidence, then much later integrated hardware | Long-term vision |

The former primary target was to boot **FreeRTOS on this repository's custom
RV32IM CPU** in the programmable logic (PL) of a Zynq XC7Z010 and demonstrate:

- preemptive task switching from a machine-timer interrupt;
- UART console output;
- an LED controlled through memory-mapped GPIO;
- repeatable ModelSim regression and Vivado bitstream generation;
- stable execution on the physical FPGA board.

That first hardware milestone is now complete. It remains below as historical
and regression evidence; completing it did not complete the propulsion program.

The completed measurement baseline is **P0 — Reproducible workload power
baseline**. The next research step is W0 workload/data-model discovery while
M0 and C0 requirements are developed as the first propulsion-relevant wave.
The old 4%/clockless OOC spike and 17.583 W estimate remain rejected. All six
P0 workload classes now have deterministic marker windows, matching 95 MHz
routed checkpoints, reviewed block activity coverage, and <=2% repeatability.
The 25 MHz production profile remains a separate build and measurement context.

For that completed milestone, FreeRTOS had to execute on the custom RISC-V core,
not on the Zynq ARM processing system. The ARM processing system could be used
only to provide a PL clock/reset if the selected board did not expose a suitable
oscillator directly to the PL.

Linux is intentionally deferred. This target does **not** require S-mode, an
MMU, OpenSBI, U-Boot, DDR, caches, RV64GC, AXI, or a PLIC.

The detailed architecture findings, remediation steps, verification cases, and
recommended Phase 0A gate are recorded in
[`doc/ARCHITECTURE_REVIEW_AND_ACTION_PLAN.md`](doc/ARCHITECTURE_REVIEW_AND_ACTION_PLAN.md).

> **Board identified:** Bo Chen Jing Xin ZYNQ MINI `20240221/REVB`, XC7Z010 in
> CLG400, with direct 50 MHz PL clock on K17. Clock/reset/UART/LED pins are
> recorded in AR-024 and `fpga/zynq_mini_revb/`. The package speed grade is not
> readable; builds conservatively target `xc7z010clg400-1` until it is
> positively identified.

## CV2 — Independent specification-first core rewrite

**Active user-selected learning/engineering track:** develop on
`codex/core-v2-spec-first` from the current baseline. The owner will write each
RTL module from its specification. Product/research value, clear contracts and
independent verification determine the architecture; diff size is not a goal.
This track does not establish W0/M0 or product-control evidence.

- [x] Create the independent local branch and record the baseline identity.
- [x] Define [directory ownership](doc/plans/core-v2-foundation/architecture.md),
      [requirements](doc/plans/core-v2-foundation/requirements.md), and
      [module-to-system verification gates](doc/plans/core-v2-foundation/verification_plan.md).
- [x] Draft the first [RV32 ALU module specification](doc/plans/core-v2-foundation/modules/alu.md).
- [ ] Accept the first module contract before writing its RTL.
- [ ] Implement an independent model/checker, including deliberate-mismatch tests.
- [ ] Owner writes ALU RTL; close required bins, lint, boundary/random tests and
      applicable formal checks with actual evidence.
- [ ] Freeze v2 core ISA/CSR, memory/IRQ/debug/power/trace contracts before
      relevant cluster/core integration.
- [ ] Establish passive retirement/trap observation, then ISS differential
      checking and generated ISA according to the CV2 gates.

No new RTL or verification capability is claimed by these documents. The owning
evidence package is [core-v2-foundation](doc/plans/core-v2-foundation/results.md);
the architectural direction is [AR-034](doc/ar/AR034_SPEC_FIRST_CORE_V2_REWRITE.md).

## Development and learning rules

1. Preserve the v1 reference and its regression identity. For v2, require the
   applicable module/cluster/core gates at each integration boundary; existing
   v1 passes do not establish correctness of a rewritten module.
2. Use focused tests while debugging, then run the complete smoke suite.
3. A checkbox is complete only when its implementation and verification
   evidence both exist.
4. Before completing a phase, be able to explain why the interface or mechanism
   is needed, not only how it was coded.
5. Design for accepted product/research requirements and measurable exit gates,
   not minimum diff size. Choose AXI, PLIC, DDR, accelerators, NPU/GPU and debug
   features through explicit requirements and workload evidence.
6. Use [`doc/CONTEXT_ROUTER.md`](doc/CONTEXT_ROUTER.md) to start from one scoped
   phase/context pack. Do not read every document or treat
   [`notes/inbox/`](notes/inbox/) as requirements or evidence.

New post-FreeRTOS work is coordinated by
[`doc/ROADMAP_AND_LEARNING_PATH.md`](doc/ROADMAP_AND_LEARNING_PATH.md). When a
substantial phase becomes active, create its evidence package under
`doc/plans/<phase-id>/` using
[`doc/PHASE_EVIDENCE_TEMPLATE.md`](doc/PHASE_EVIDENCE_TEMPLATE.md). Standards,
mature repositories, and reuse limits are indexed in
[`doc/REFERENCE_INDEX.md`](doc/REFERENCE_INDEX.md); release and licensing gates
are in [`doc/RELEASE_CHECKLIST.md`](doc/RELEASE_CHECKLIST.md) and
[`doc/LICENSE_STRATEGY.md`](doc/LICENSE_STRATEGY.md).
The research taxonomy, paper decision registry, workload-discovery gate, and
CoreMark/domain-benchmark policy are in
[`doc/RESEARCH_PROGRAM_PLAN.md`](doc/RESEARCH_PROGRAM_PLAN.md).
AR-033 records the progressive document-governance decision: new canonical
documents use `doc/`, `docs/` is a frozen legacy guide set, and ignored local
plans/generated output are not authoritative project context.

The repository license decision is now adopted: original material uses the
root noncommercial source-available terms, commercial requests go to
`Hetport@outlook.com`, and FreeRTOS retains its upstream MIT license.

The long-term atmospheric propulsion idea is a research-program vision. This
repository remains the experimental control-SoC foundation until later phases
produce model, control, power, and bench evidence. A longer TODO does not turn
future work into implemented capability.

---

## ACT4 policy: parallel verification, not a starting barrier

The complete official ACT4 suite does **not** have to pass before SoC and
FreeRTOS work starts. ACT4 checks ISA behavior; it does not implement or verify
the timer, UART, GPIO, linker script, FreeRTOS port, or FPGA constraints.

Development therefore proceeds in two parallel tracks:

```text
Track A: official ACT4 RV32I/RV32M coverage and CPU bug fixing
Track B: SoC bus -> timer interrupt -> UART/GPIO -> FreeRTOS -> FPGA
```

The tracks join at release gates:

- **Before timer/FreeRTOS debugging:** the existing directed smoke regression
  must remain green.
- **Before declaring FreeRTOS simulation complete:** CSR, trap, `mret`, timer
  interrupt, LSU, and context-switch-directed tests must pass.
- **Before declaring the CPU/FPGA target complete:** all applicable official
  RV32I/RV32M ACT4 tests should pass. Any unexecuted or unsupported test must be
  documented; a synthetic ACT4 harness smoke test is not ISA compliance.

This ordering prevents ACT4 integration work from blocking useful SoC progress
while still preventing FreeRTOS from hiding CPU correctness defects.

---

## Current project state — small SoC foundation, not a propulsion system

Implemented:

- [x] RV32IM in-order core with packed pipeline packets.
- [x] Explicit architectural commit/retirement interface.
- [x] Obsolete fixed-low `halt_o` removed; committed `tohost` stores are the
      single test-completion ABI.
- [x] M-mode CSR instructions and synchronous trap entry/return support.
- [x] Explicit M-mode CSR legality, no-write rules, WARL filtering, and
      same-address dependency bypass.
- [x] Lightweight JSON/PowerShell ModelSim regression runner with native
  simulator-exit and transcript result gates; UVM was not required to close
  the completed FreeRTOS target, and AR-026 adds it only as a future expansion
  track.
- [x] Separate instruction/data image support and commit-based `tohost`
  completion checking.
- [x] ELF-to-memory converter and ACT4 import/runner adapters.
- [x] Synthetic ACT4 harness smoke test.
- [x] Official ACT4 RV32IM baseline: 39/39 RV32I and 8/8 RV32M tests passed;
  refreshed after release-interface cleanup on 2026-08-17 with no failures,
  timeouts, or nonzero simulator exits.
- [x] Synchronous instruction BRAM with PC/response alignment across stalls and
      redirects, verified as four `RAMB36E1` primitives in Vivado 2019.2.
- [x] Single-outstanding wait-state-capable CPU data bus and LSU transaction
      state machine, with data RAM outside the CPU.
- [x] Registered EX/WB memory results with precise load/store access-fault
      completion and packet-owned WB/commit data.
- [x] Centralized full-address SoC data decoder and one-cycle registered default
  error target, plus registered instruction-access-fault reporting.
- [x] Existing directed regression last verified at 23/23 passing, including
  the precise illegal-JALR-funct3 case, with
  converter/importer tests at 12/12 and the regression-result negative test
  passing.

Completed after the original CPU-only baseline:

- [x] Hardware interrupt input and precise interrupt entry.
- [x] `mtime`/`mtimecmp` machine timer with registered core-bus target.
- [x] Polling UART TX with native bus target, queued byte, 8N1 shifter, and
  serial-pin firmware scoreboard.
- [x] Polling UART RX with synchronized 8N1 sampling, parameterized default
  16-byte FIFO, sticky errors, and pin-to-firmware-to-pin echo scoreboard.
- [x] Memory-mapped output GPIO peripheral with readback, partial writes,
  fabric ownership, firmware waveform checking, and OOC synthesis evidence.
- [x] Bare-metal startup code, linker script, split images, peripheral drivers,
  and three C sanity applications.
- [x] FreeRTOS application, focused ModelSim vertical slice, and separate
  extended scheduler/context soak.
- [x] FPGA top, XDC constraints, and routed Vivado bitstream build script.
- [x] Physical-board JTAG discovery plus LED-visible `timer_gpio` and
  `timer_irq` results.
- [x] Physical-board external-UART `hello`, production FreeRTOS UART/GPIO, and
  repeated PL K2 reset result.
- [x] Complete the six-class P0 95 MHz power-workload portfolio with reviewed
  block mapping and repeatability; direct name mapping remains about 5.5%.

Not implemented yet—the actual gap between this SoC and the long-term vision:

- [ ] Positive XC7Z010 speed-grade identification; the conservative `-1`
  target remains in use.
- [ ] Performance/activity counters and a verified safe low-power state.
- [ ] PWM, capture, watchdog and CPU-independent external-fault shutdown.
- [ ] ADC/SPI, interrupt controller and DMA sampled-data path.
- [ ] Versioned motor/inverter/compressor/flow model with MIL/SIL evidence.
- [ ] HIL and low-energy bench correlation with measured uncertainty.
- [ ] Workload-justified accelerator; RVV/NPU/GPU are not current requirements.
- [ ] Propulsion energy/thermal/flow feasibility, high-energy safety case,
  thrust-producing hardware, integrated vehicle, or flight qualification.

Current planning position:

- Phase 0A is complete; this closes its correctness gate, not the whole
  architecture review or post-FreeRTOS propulsion roadmap.
- Phase 1 is complete: AR-009 and the generated
  `freertos_split_64k_v1` hardware/software ABI are accepted.
- Phase 2 is complete: AR-003/AR-004 close transaction/result ownership,
  AR-019 supplies centralized data decode and the registered default target,
  and AR-018 verifies precise data and instruction access faults.
- AR-008 belongs to Phase 3; AR-010 is continuous verification; AR-011 is an
  early FPGA feasibility gate; AR-012 retirement/public-interface cleanup is
  complete and verified.
- Phase 3 is complete. Phase 4 is complete in RTL simulation and OOC
  synthesis: polling UART TX/RX and output GPIO satisfy its combined exit
  gate. Physical GPIO and external-UART TX output now pass; UART RX remains
  covered by pin-level simulation rather than a physical-board stress test.
- Phase 5 is complete in ModelSim and Vivado OOC synthesis: four firmware
  slices pass and both ELF-derived BRAM images retain nonzero initialization.
  Its timer/GPIO, timer-interrupt, and external-UART `hello` images now pass on
  the physical board.
- Phase 6 simulation is complete using the unmodified
  official FreeRTOS V11.3.0 GCC RISC-V port. Tick/preemption, queue traffic,
  context sentinels, UART, and GPIO pass in both the focused profile and a
  1,000-tick/1,000-queue-receive soak. The exact-board bitstream routes with
  positive timing; the production FPGA image now emits sustained heartbeats
  and toggles PL D1 on the physical board.
- Phase 7 is complete through exact-board bitstream generation: AR-024 adds
  the ZYNQ MINI REVB wrapper/XDC/build, removes a routed CPU combinational loop,
  and produces all three Phase 5 bitstreams with non-negative timing. JTAG
  programming, LED/timer applications, external UART, production FreeRTOS, and
  deliberate K2 restarts now pass on hardware. Only positive speed-grade
  identification remains open.
- AR-014 accepted-map generation infrastructure is complete. AR-019 uses its
  SystemVerilog constants in the implemented data decoder/default target;
  remaining software/tool consumers continue in their owning later phases.
- AR-015 records the paired 16 KiB/64 KiB baseline and its failing
  combinational MULDIV path. AR-017 replaces that divider with a verified
  Radix-2 iterative implementation; both profiles now pass the 25/50 MHz OOC
  post-synthesis checks, and AR-024 closes exact-board 25 MHz placement,
  routing, timing, DRC, power-estimate, and resource evidence.
- AR identifiers are stable finding numbers, not phase numbers. Detailed
  ownership and status are maintained in
  [`doc/ARCHITECTURE_REVIEW_AND_ACTION_PLAN.md`](doc/ARCHITECTURE_REVIEW_AND_ACTION_PLAN.md).
- AR-026 accepts the scalable UVM architecture. Its ModelSim/UVM 1.2 toolchain
  sub-gate is verified; the passive `commit_pkt_t`/`trap_entry_t` monitor and
  scoreboard remain unimplemented and must preserve all current regressions.

---

## Phase 0 — Freeze the present green baseline

**Purpose:** make failures introduced by the SoC work easy to identify.

- [x] Review and checkpoint the current uncommitted regression, ACT4 adapter,
  CSR, testbench, and test-image changes.
- [x] Run and archive the complete directed regression summary.
- [x] Run the ELF/importer unit tests and archive their summary.
- [x] Record the tool versions used: ModelSim/Questa, Python, WSL Ubuntu,
  RISC-V GNU toolchain, Spike, and Vivado.
- [x] Remove generated build/log files from source control while retaining
  reproducible scripts and manifests.
- [x] Require a zero native simulator exit in addition to the PASS/fatal/error
  transcript gates, with RED/GREEN evidence in
  [`doc/ar/AR013_REGRESSION_EXIT_STATUS_GATE.md`](doc/ar/AR013_REGRESSION_EXIT_STATUS_GATE.md).

Baseline evidence is archived in
[`doc/PHASE0_BASELINE_2026-07-24.md`](doc/PHASE0_BASELINE_2026-07-24.md).

Baseline commands on Windows:

```powershell
Set-Location D:\Rsicv-soc\sim\regress
Set-ExecutionPolicy -Scope Process -ExecutionPolicy Bypass
./run_regression.ps1 -Tag smoke
python -m unittest test_elf_to_mem.py test_import_act4.py
```

**Exit gate:** all checked-in directed tests and Python tests pass from a clean
build directory.

---

## Phase 0A — Make retirement and pipeline side effects precise

**Status:** complete. This does not close the overall architecture review or any
later phase.

**Purpose:** close the correctness gap identified by the architecture review
before a wait-state bus or asynchronous interrupts make the same failures more
difficult to isolate.

- [x] Reproduce AR-001 with a trap immediately followed by a younger CSR write.
- [x] Require packet validity for CSR writes and clear the complete younger
  EX/WB packet on `pipe_kill`.
- [x] Promote the precise CSR squash regression into the smoke suite.
- [x] Record the RED/GREEN evidence in
  [`doc/ar/AR001_PRECISE_CSR_SQUASH_FIX.md`](doc/ar/AR001_PRECISE_CSR_SQUASH_FIX.md).
- [x] Test a trap followed by a younger GPR write and a younger store.
- [x] Make every reset and flush produce a completely initialized packet bubble.
- [x] Record the AR-002 implementation problems, handling decisions, and
  reusable principles in
  [`doc/ar/AR002_CANONICAL_PIPELINE_BUBBLES.md`](doc/ar/AR002_CANONICAL_PIPELINE_BUBBLES.md).
- [x] Implement precise IALIGN=32 traps for taken branch, JAL, and JALR targets.
- [x] Record AR-006 implementation and verification evidence in
  [`doc/ar/AR006_CONTROL_FLOW_MISALIGNMENT.md`](doc/ar/AR006_CONTROL_FLOW_MISALIGNMENT.md).
- [x] Implement AR-007 CSR legality, no-write semantics, WARL behavior, and
      back-to-back dependency handling.
- [x] Record the AR-007 contract, RED/GREEN evidence, implementation decisions,
      and learning notes in
  [`doc/ar/AR007_CSR_LEGALITY_WARL_AND_HAZARDS.md`](doc/ar/AR007_CSR_LEGALITY_WARL_AND_HAZARDS.md).
- [x] Implement and verify AR-005 synchronous instruction BRAM timing across
      sequential fetch, RAW stalls, and redirects.
- [x] Record the AR-005 timing contract, Vivado inference evidence, problems,
      handling decisions, and reusable principles in
  [`doc/ar/AR005_SYNCHRONOUS_INSTRUCTION_BRAM.md`](doc/ar/AR005_SYNCHRONOUS_INSTRUCTION_BRAM.md).
- [x] Complete the remaining Phase 0A exit criteria in
  [`doc/ARCHITECTURE_REVIEW_AND_ACTION_PLAN.md`](doc/ARCHITECTURE_REVIEW_AND_ACTION_PLAN.md).

AR-003 and AR-004 are Phase 2 sub-gates completed early to satisfy the
cross-cutting wait-state and registered-result criteria. AR-019 now implements
the centralized data decoder and default error target. AR-018's cause-1 path
and SoC regression complete the Phase 2 exit gate; real peripherals belong to
Phases 3 and 4.

Current verification after the AR-013 regression-gate fix:
directed smoke **22/22 passed**
and regression utility tests **4/4 passed**. The AR-013 negative result
classifier test also passes.

---

## Continuous Track A — Maintain official ACT4 RV32IM coverage

**Status:** baseline complete. On 2026-08-03, all 39 applicable RV32I tests and
all 8 applicable RV32M tests passed on unchanged RTL. This is a verified
project baseline, not a formal RISC-V compliance certification.

**Purpose:** prove instruction semantics independently of FreeRTOS behavior.

- [x] Provide an address-aware ELF converter for separate instruction/data RAM.
- [x] Provide an ACT4 ELF importer and generated JSON manifest.
- [x] Provide a PowerShell wrapper that imports and runs ACT4 ELFs.
- [x] Build and import 39 official RV32I machine-mode self-checking ELFs.
- [x] Run all 39 RV32I tests through ModelSim: 39 PASS, 0 FAIL/TIMEOUT.
- [x] Extend the ACT4 configuration and import flow for the applicable RV32M
  corpus.
- [x] Build, import, and run all 8 RV32M tests: combined manifest 47/47 PASS.
- [x] Classify the complete baseline: no environment, adapter, harness,
  unsupported, or DUT/RTL failures remained.
- [x] Re-run the directed smoke regression and importer/converter unit tests.
- [x] Record counts, commands, scope, and classification evidence in
  `doc/ACT4_RV32I_INTEGRATION_HANDOFF_2026-07-27.md`.

Rebuild either extension with the consolidated Windows launcher:

```powershell
Set-Location D:\Rsicv-soc\sim\regress
.\run_act4_build.ps1 -Extension I
.\run_act4_build.ps1 -Extension M
```

Maintenance policy: keep the 47/47 baseline green after changes to decode,
ALU, LSU, CSR, trap, or pipeline control. If a future ACT4 test exposes an RTL
bug, first add a small directed regression that reproduces it. Use Spike only
when the ACT4 signature and commit trace cannot isolate the mismatch. These are
ongoing regression rules, not open Track A completion items.

---

## Phase 1 — Define the minimal FreeRTOS SoC contract

**Status:** complete. AR-009 and the 64 KiB split-memory ABI were accepted on
2026-08-01. Behavioral RTL adoption remains Phase 2 work.

**Purpose:** freeze the memory map and bus behavior before writing peripherals
or software.

The accepted design rules, transaction invariants, topology decision, and
freeze evidence are recorded in
[`doc/MEMORY_MAP_CONTRACT_DESIGN_GUIDE.md`](doc/MEMORY_MAP_CONTRACT_DESIGN_GUIDE.md).
The detailed accepted split-memory decision, consequences, verification plan,
and review answers are recorded in
[`doc/ar/AR009_ARCHITECTURAL_MEMORY_MAP.md`](doc/ar/AR009_ARCHITECTURAL_MEMORY_MAP.md).
It is accepted but must not be treated as implemented until Phase 2 is
verified. The accepted constants have one validated machine-readable source and
generated consumers, as recorded in
[`doc/ar/AR014_MACHINE_READABLE_SOC_MAP.md`](doc/ar/AR014_MACHINE_READABLE_SOC_MAP.md).
The complete core-to-SoC ownership and integration boundary is recorded in
[`doc/ar/AR016_CORE_TO_SOC_ENVIRONMENT_CONTRACT.md`](doc/ar/AR016_CORE_TO_SOC_ENVIRONMENT_CONTRACT.md).
The paired resource measurement is recorded in
[`doc/ar/AR015_RAM_CAPACITY_UTILIZATION_COMPARISON.md`](doc/ar/AR015_RAM_CAPACITY_UTILIZATION_COMPARISON.md):
the 16 KiB pair uses 8/60 RAMB36 tiles and the selected 64 KiB pair uses 32/60
on the provisional `xc7z010clg400-1`. Exact-board resource and timing closure
remain mandatory implementation gates.

Accepted first-milestone memory map:

| Region | Address | Initial size / registers |
|---|---:|---|
| Instruction BRAM | `0x0000_0000` | 64 KiB |
| CLINT-compatible timer | `0x0200_0000` | `mtimecmp=+0x4000`, `mtime=+0xBFF8` |
| UART | `0x1000_0000` | 4 KiB decode window |
| GPIO | `0x1000_1000` | 4 KiB decode window |
| Data BRAM | `0x8000_0000` | 64 KiB |

The linker will place `.text` in instruction BRAM and `.rodata`, `.data`,
`.bss`, heap, and stacks in data BRAM. Memory sizes remain parameters and must
be adjusted using the final ELF size report rather than guesswork.

- [x] Document byte addressing, little-endian lanes, alignment rules, response
  latency, unmapped access behavior, and reset behavior.
- [x] Review and accept the AR-009 split-memory contract,
      including topology, `tohost`, instruction access faults, and default
      target behavior.
- [x] Select 64 KiB for each instruction/data RAM bank, informed by the AR-015
      provisional utilization and timing comparison.
- [x] Define a small single-outstanding-transaction core bus:
  `req_valid`, `req_ready`, `req_addr`, `req_write`, `req_wdata`, `req_wstrb`,
  `req_size`, `rsp_valid`, `rsp_rdata`, and `rsp_error`.
- [x] Define how pipeline back-pressure uses `ex_stall` without duplicating or
  dropping a load/store.
- [x] Decide and document access-fault causes for unmapped or failed accesses.
- [x] Add a dependency-free generator and stale-file check for accepted
      SystemVerilog, C, linker, simulation, Vivado Tcl, and ACT4-facing map
      artifacts without changing current implemented addresses.
- [x] Generate named 16 KiB/64 KiB RAM profiles and preserve paired Vivado
      LUT/FF/BRAM/DSP utilization reports for the provisional XC7Z010 part.
- [x] Apply identical 25/50 MHz post-synthesis clock constraints to both RAM
      profiles and preserve WNS/TNS and critical-path reports; both identify
      the same failing 87.102 ns combinational MULDIV baseline. AR-017 records
      the later iterative-divider GREEN comparison.
- [x] Generate accepted memory-map and peripheral-register definitions for
      SystemVerilog, C, GNU linker, simulation, Vivado Tcl, and ACT4-facing
      consumers. Behavioral RTL/test adoption remains a Phase 2 gate.

**Exit gate:** satisfied. A review can answer the owner, address, access width,
latency, response, and fault behavior for every first-milestone region without
claiming that Phase 2 RTL has implemented it.

**Knowledge checkpoint:** explain request/response handshaking, why synchronous
BRAM reads need a response phase, and why memory-mapped peripherals must be
outside the CPU core.

---

## Phase 2 — Externalize the data bus

**Status:** complete (2026-08-03).

**Purpose:** allow load/store instructions to reach RAM or peripherals.

- [x] Correct the LSU interface direction: `ram_req_ready_i` must be supplied by
  the target rather than driven by the LSU.
- [x] Replace RAM-specific LSU names with the Phase 1 bus contract.
- [x] Move `data_ram` from `src/core/riscv.sv` into `src/riscv_soc.sv`.
- [x] Add centralized full-address decode, local RAM address subtraction, and
  registered return-path ownership. See
  [`doc/ar/AR019_CENTRALIZED_DATA_FABRIC.md`](doc/ar/AR019_CENTRALIZED_DATA_FABRIC.md).
- [x] Add a one-cycle registered, zero-data, side-effect-free default error
  target for every non-RAM data address.
- [x] Preserve byte/halfword store strobes, load sign extension, and
  misalignment behavior.
- [x] Connect `rsp_error` to load/store access-fault trap generation.
- [x] Keep the commit interface accurate for stalled, completed, and faulting
  memory instructions.
- [x] Add assertions for stable requests during stalls, one response per
  accepted request, and no memory operation after a pipeline kill.
- [x] Add isolated SoC-level RED tests for unmapped load/store access faults,
  side-effect-free invalid stores, and instruction access fault cause 1. See
  [`doc/ar/AR018_SOC_FABRIC_RED_TESTS.md`](doc/ar/AR018_SOC_FABRIC_RED_TESTS.md).
- [x] Add initial RAM-boundary, unmapped-address, request-wait, owner-stability,
  and back-to-back cross-target GREEN tests through the implemented decoder.
- [x] Add explicit instruction-fetch error signaling and turn the AR-018
  cause-1 case GREEN.

SoC-level target coverage expands in Phases 3 and 4 as timer/UART/GPIO targets
are implemented; that future expansion is not part of the Phase 2 exit gate.

**Exit gate:** all old LSU tests pass through the new bus, plus the new bus
tests pass with zero-delay and inserted-wait-state targets.

AR-003 transaction-control details and RED/GREEN evidence are recorded in
[`doc/ar/AR003_WAIT_STATE_SAFE_LSU.md`](doc/ar/AR003_WAIT_STATE_SAFE_LSU.md).
AR-004 registered-result ownership and access-fault evidence are recorded in
[`doc/ar/AR004_REGISTERED_MEMORY_RESULT.md`](doc/ar/AR004_REGISTERED_MEMORY_RESULT.md).
The AR-003/AR-004 sub-gates are satisfied. AR-019 closes centralized data
decode/default-target ownership with focused protocol coverage, 3/3 SoC data
fault runs (including inserted RAM waits), 23/23 smoke, and accepted-map OOC
synthesis. AR-018 is GREEN for all four selected SoC runs: three data cases
and one instruction-access-fault case.

### Non-blocking Phase 2 / ACT4 hardening

These maintenance items do not reopen Phase 2 and are not prerequisites for
Phase 3. Schedule them when the related fetch or verification interface is
next changed, or earlier only if a regression exposes a real failure.

- [x] Make a fetch-error decode packet canonical by clearing normal RF, CSR,
  memory, redirect, operand-use, and mul/div controls; verify with deliberately
  side-effectful replacement instruction data.
- [x] Turn the AR-018 consecutive-invalid, redirect/stale-response, and
  fault-during-stall scenarios into executable directed tests.
- [ ] If instruction wait states or multiple fetch targets are introduced,
  separate response-valid from response-error and move range ownership into a
  SoC-level instruction decoder.
- [x] Tag imported RV32I and RV32M entries distinctly and preserve the compact
  2026-08-17 baseline under `doc/evidence/act4/`.

---

## Phase 3 — Implement precise machine timer interrupts

**Status:** complete (2026-08-09). Detailed decisions and verification evidence
are in [`doc/ar/AR008_PRECISE_MACHINE_TIMER_INTERRUPTS.md`](doc/ar/AR008_PRECISE_MACHINE_TIMER_INTERRUPTS.md).

**Purpose:** provide the periodic scheduler tick required by preemptive
FreeRTOS.

### CPU interrupt work

- [x] Add a machine-timer interrupt input to the CPU.
- [x] Drive `mip.MTIP` from hardware and prevent ordinary CSR writes from
  falsely creating or clearing the hardware-pending state.
- [x] Gate timer interrupts with `mie.MTIE` and `mstatus.MIE`.
- [x] Give synchronous exceptions priority over an interrupt at the same
  retirement boundary.
- [x] On interrupt entry, write `mcause = 0x8000_0007`, save the correct resume
  PC in `mepc`, update `MIE/MPIE`, flush younger instructions, and suppress
  younger stores/register writes.
- [x] Verify `mret` restores interrupt-enable state and resumes exactly once.
- [x] Define useful `wfi` behavior; a simple wait-until-interrupt implementation
  is sufficient.

### Timer peripheral work

- [x] Implement 64-bit `mtime`, incrementing from the SoC clock.
- [x] Implement 64-bit memory-mapped `mtimecmp`.
- [x] Assert MTIP while `mtime >= mtimecmp`.
- [x] Support safe RV32 high/low-word accesses without a transient early tick.
- [x] Make timer frequency and reset values explicit parameters.

### Required verification

- [x] Timer increments and compare crossing test.
- [x] Masked-pending interrupt test.
- [x] Enabled interrupt entry test.
- [x] `mcause`, `mepc`, `mtval`, and `mstatus` value tests.
- [x] Interrupt taken around load, store, branch, CSR, and pipeline-stall tests.
- [x] Repeated tick and `mret` loop test to detect skipped or duplicated work.
- [x] Commit-interface assertions proving precise retirement around interrupts.

**Exit gate:** a bare-metal handler services at least 10,000 simulated timer
interrupts and returns correctly, with the complete smoke regression green.

---

## Phase 4 — Add minimal peripherals

**Status:** complete in RTL simulation and OOC synthesis (2026-08-11).
Polling UART TX/RX and output GPIO satisfy the Phase 4 exit gate. UART
interrupts/PLIC and physical-board validation remain deliberately deferred. See
[`doc/ar/AR020_MINIMAL_POLLING_UART_TX.md`](doc/ar/AR020_MINIMAL_POLLING_UART_TX.md)
[`doc/ar/AR021_POLLING_UART_RX_FIFO.md`](doc/ar/AR021_POLLING_UART_RX_FIFO.md), and
[`doc/ar/AR022_MEMORY_MAPPED_GPIO_OUTPUT.md`](doc/ar/AR022_MEMORY_MAPPED_GPIO_OUTPUT.md).

**Purpose:** provide observable hardware behavior and a FreeRTOS console.

### UART

- [x] Implement parameterized UART TX with data register, busy/ready status,
  baud divider, start/data/stop bits, and polling operation.
- [x] Add a loopback or serial decoder testbench that checks the transmitted
  byte stream and baud timing.
- [x] Add UART RX with two-flop synchronization, midpoint 8N1 sampling, and a
  parameterized FIFO whose default depth is 16 bytes.
- [x] Define and test empty-read, full/drop-newest, overrun, framing-error, and
  write-one-to-clear semantics.
- [x] Add a serial-input/firmware/serial-output echo regression for a 16-byte
  stream; separately fill all 16 FIFO entries in the focused target test.
- [x] Keep UART interrupts and PLIC deferred until polling TX/RX work on
  physical hardware.

### GPIO

- [x] Implement a memory-mapped output register for LEDs.
- [x] Parameterize output width and define reset value.
- [x] Add byte-strobe and readback tests.

### Integration

- [x] Add UART address decode and registered response ownership to the SoC bus.
- [x] Add GPIO address decode and registered response ownership.
- [x] Verify RAM, timer, UART, GPIO, and default targets cannot accept/respond to one
  request simultaneously.
- [x] Add a SoC-level polling program whose decoded UART output is
  `Hello, UART!\r\n`.
- [x] Add a SoC-level RX echo program whose decoded output is
  `RX FIFO 16 OK!\r\n`.
- [x] Extend the SoC-level peripheral program/scoreboard with GPIO output.

**Exit gate:** satisfied. ModelSim decodes the expected UART text and observes
the `01 -> 02 -> 04 -> 08 -> A5` GPIO waveform from bare-metal programs.

---

## Phase 5 — Establish bare-metal firmware and FPGA sanity tests

**Status:** complete in ModelSim/Vivado and on the physical board.
`timer_gpio` and `timer_irq` passed on 2026-08-15; external-UART `hello` passed
on 2026-08-23. The reset/runtime contract, decisions, and verification evidence
are recorded in
[`docs/phase5-startup-runtime-guide.md`](docs/phase5-startup-runtime-guide.md)
and [`doc/ar/AR023_PHASE5_BARE_METAL_RUNTIME.md`](doc/ar/AR023_PHASE5_BARE_METAL_RUNTIME.md).

**Purpose:** separate CPU/peripheral/board failures from FreeRTOS port failures.

- [x] Define the repository-specific reset-to-C contract, including the split
  BRAM `.data` preload policy, `.bss` clear, ABI-safe `sp`/`gp`, direct-mode
  `mtvec`, linker assertions, and verification ladder.
- [x] Extend `sim/regress/elf_to_mem.py` for ELF load segments split across the
  accepted program- and data-RAM regions, with positive and rejection tests.
- [x] Make `tb_riscv_soc.DATA_FILE` initialize data RAM before reset release and
  forward reproducible program/data initialization parameters through the SoC
  synthesis boundary.
- [x] Add `sw/common/startup.S`: initialize `sp`/`gp`, set `mtvec`, initialize
  memory as required, and call `main`.
- [x] Add `sw/common/linker.ld` matching the final BRAM memory map.
- [x] Add minimal UART, GPIO, timer, and CSR headers/drivers.
- [x] Add a reproducible WSL build script using
  `riscv64-unknown-elf-gcc -march=rv32im_zicsr -mabi=ilp32`.
- [x] Produce ELF, disassembly, size report, instruction image, and data image.
- [x] Run three separate programs in simulation:
  1. UART `hello`;
  2. timer-polled LED toggle;
  3. timer-interrupt counter with `mret`.
- [x] Run `timer_gpio` and `timer_irq` on the FPGA and observe their expected
  LED sequences.
- [x] Run `hello` on the FPGA through an external 3.3 V USB-TTL adapter.

**Exit gate:** the bare-metal timer-interrupt program works both in ModelSim and
on the physical board.

---

## Phase 6 — Integrate the official FreeRTOS RISC-V port

**Status:** official-port focused/extended ModelSim profiles and the routed
exact-board image pass; physical heartbeat/D1/restart execution passed on
2026-08-23. See
[`doc/ar/AR025_OFFICIAL_FREERTOS_RISCV_PORT.md`](doc/ar/AR025_OFFICIAL_FREERTOS_RISCV_PORT.md).

**Purpose:** run an existing, reviewed kernel rather than inventing a scheduler
or context-switch ABI.

- [x] Vendor a pinned FreeRTOS Kernel V11.3.0 source subset.
- [x] Use the official `portable/GCC/RISC-V` port and document any platform
  adaptation rather than rewriting its context switch.
- [x] Add `FreeRTOSConfig.h` with explicit CPU clock and a 1 kHz tick.
- [x] Start with one hart, M-mode only, preemption enabled, and no atomic `A`
  extension requirement.
- [x] Choose and document `heap_4.c`; keep heap and task
  stacks in data BRAM.
- [x] Enable `configASSERT`, stack-overflow checking, and malloc-failure hooks.
- [x] Avoid full `printf`; use a small polling UART writer.
- [x] Add build-time RAM/ROM overflow checks using the ELF size and linker map.
- [x] Add three demonstration functions (implemented as four tasks so queue
      producer/receiver priorities are explicit):
  1. toggle an LED every 500 ms;
  2. print a UART heartbeat every second;
  3. send and receive values through a FreeRTOS queue.
- [x] Verify register/context preservation using sentinel register values across
  forced context switches.
- [x] Run a separate long simulation with illegal/unexpected-trap failure
  hooks, ordered-commit assertions, stack/context checks, and UART/GPIO
  write scoreboards. The 2026-08-18 soak passed after 1,000 tick hooks and
  ordered queue receives, with 1,428 observed timer IRQs, 1,579 UART bytes,
  and 286 alternating GPIO transitions.

**Exit evidence:** FreeRTOS starts in ModelSim, the tick count advances,
tasks preempt through timer and ECALL paths, queue communication succeeds, the
`s2`-`s11` sentinels survive a forced switch, and UART/GPIO output matches the
scoreboard. The focused profile remains a fast release gate; the separately
tagged extended profile passed at 7,262,975 cycles without changing the
production firmware defaults or vendored kernel.

---

## Phase 7 — Zynq XC7Z010 FPGA integration

**Purpose:** prove the custom RISC-V SoC in silicon.

The board identity, schematic-derived PL pins, and local implementation flow
are known. JTAG, clock/BRAM boot, LED GPIO, timer progression, timer interrupt,
external-UART TX, production FreeRTOS, and repeated-reset execution now have
physical evidence. Speed-grade confirmation remains external; ACT4 is not a
blocker for that identification.

- [x] Record the exact board model, revision, XC7Z010 package, oscillator,
  reset, UART, and LED information.
- [ ] Confirm the unreadable XC7Z010 speed grade from a reliable device/vendor
  record; use conservative `xc7z010clg400-1` until then.
- [x] Create `fpga/zynq_mini_revb/top.sv` with explicit clock, reset, UART, and LED
  ports.
- [x] Create and review `fpga/zynq_mini_revb/constraints.xdc` from the board schematic
  or vendor reference file.
- [x] Add synchronizers and reset deassertion logic for asynchronous board
  inputs.
- [x] Retain the otherwise-unused PS7 hard block required for Zynq
  configuration; use neither PS FCLK nor ARM application execution.
- [x] Add a non-interactive Vivado Tcl flow for project creation, synthesis,
  implementation, reports, and bitstream generation.
- [x] Initialize instruction/data BRAM images reproducibly in the bitstream.
- [x] Run the early post-synthesis timing checkpoint and inspect the
      combinational RV32M divider critical path; AR-015 confirms it fails both
      25 MHz and 50 MHz for both RAM capacities.
- [x] Replace DIV/DIVU/REM/REMU with the AR-017 Radix-2 iterative divider and
      rerun the paired internal timing comparison. Both profiles pass 50 MHz
      with WNS +7.373 ns; the worst path is now multiply-high.
- [x] Begin with a conservative 25 MHz core clock; attempt 50 MHz only after
  timing closes with margin.
- [x] Capture utilization, WNS/TNS, clock, BRAM, LUT, FF, and power estimates.
- [x] Program and verify the bare-metal LED and timer-interrupt tests.
- [x] Program and verify bare-metal UART `hello` through external 3.3 V
  USB-TTL on U15/W15.
- [x] Repeat PL K2 reset testing and record behavior around the existing
  `REQP-1839` warning.
- [x] Program and verify the FreeRTOS demonstration.
- [x] Do not add an ILA: external UART/LED evidence was sufficient for this
  milestone; retain ILA as a future diagnostic option.

**Exit gate:** after programming or power-up, the custom RISC-V core boots the
BRAM firmware, prints the FreeRTOS banner and task heartbeats, switches tasks at
1 kHz, and controls the LED without ARM software executing the application.

**Result:** satisfied on 2026-08-23. The retained PuTTY transcript contains 74
exact `Hello, UART!` matches, 17 deliberate-reset FreeRTOS banners, and 537
heartbeats; PL D1 toggled and deliberate K2 restarts recovered. See
[`doc/evidence/board_20260823/README.md`](doc/evidence/board_20260823/README.md).

---

## Phase 8 — Release verification and definition of done

- [x] All applicable official RV32I and RV32M ACT4 tests pass (47/47 refreshed
  from a clean detached worktree on 2026-08-18 after regenerating the official
  artifacts).
- [x] All directed, CSR/trap, LSU, bus, timer, UART, GPIO, and focused FreeRTOS
  tests pass from one documented regression command; the extended FreeRTOS soak
  passes through its separately documented tag.
- [x] ModelSim logs contain no fatal errors or unexpected assertions.
- [x] Vivado synthesis and implementation complete with non-negative timing
  slack at the selected clock.
- [x] BRAM, LUT, FF, clock, and estimated power usage fit the XC7Z010 target.
- [x] FPGA UART output demonstrates task scheduling and sustained operation of
  the production queue application.
- [x] FPGA LED output demonstrates timed task execution.
- [x] Stack-overflow, malloc-failure, and unexpected-trap indicators remain
  clear during the approximately 23-minute captured hardware session, which
  included deliberate resets.
- [x] A reproducible README documents Windows 11, ModelSim, Vivado, WSL Ubuntu,
  GNU RISC-V toolchain, firmware build, simulation, bitstream build, and board
  programming commands.

---

## Continuous Track W — Workload and acceleration discovery

**Status:** W0 planning baseline, source registry, claim/product-hypothesis
registers, decision-outcome rules, and paper-audit template created; starter
sources are queued, but no paper has passed local audit, no W0 workload has
been profiled, and no accelerator is selected.

The central research map is
[`doc/RESEARCH_PROGRAM_PLAN.md`](doc/RESEARCH_PROGRAM_PLAN.md). It keeps
concise program-level paper decisions while detailed audits use
[`doc/research/PAPER_AUDIT_TEMPLATE.md`](doc/research/PAPER_AUDIT_TEMPLATE.md).
Exact citations, provenance, and first reading order are in
[`doc/research/SOURCE_REGISTRY.md`](doc/research/SOURCE_REGISTRY.md).
`TODO.md` remains the execution ledger; a paper or simulation result is not an
implemented feature.

### W0 — Workload and data-model discovery

- [x] Define the research-document structure, paper lifecycle, audit template,
      provenance boundary, and links to TODO/phase evidence.
- [x] Define stable research/product hypothesis IDs, revision rules,
      GO/PIVOT/DEFER/NO-GO outcomes, and evidence-preserving stop/re-entry
      requirements.
- [x] Define repository-wide `DATA-*` information classes, pre-commit/upload
      questions, external-storage boundaries, and phase result review rules.
- [ ] Execute `W0-D1`: decide whether one replaceable battery–DC-bus–motor/
      compressor surrogate is bounded enough for deterministic rule/PI
      comparison. Produce the signal/unit/range/status table, timing and safe
      state, three scenario classes, baseline contract, explicit unknowns, and
      an outcome using
      [`doc/research/W0_D1_EXECUTION_BRIEF.md`](doc/research/W0_D1_EXECUTION_BRIEF.md);
      keep it `NOT RUN` until those artifacts exist.
- [ ] After a `W0-D1` GO outcome, freeze the selected surrogate boundary in the
      active W0 phase requirements and trace stable requirement IDs into its
      scenarios and tests.
- [ ] Classify energy-management/control/estimation algorithm families and
      select auditable baselines rather than choosing by venue or novelty.
- [ ] Create deterministic high-level and bounded-C versions of the first
      rule/PI workload with one shared functional/control oracle.
- [ ] Add small optimizer/MPC and estimator or fault-classifier workloads only
      when the M0 signal model justifies them.
- [ ] Extract shared domain types, bounds, lifetimes, access patterns, and
      candidate kernels from real implementations; do not assume that a
      source-level list or dictionary deserves hardware.
- [ ] Characterize L0 machine costs, optional L1 CoreMark, L2 domain kernels,
      and L3 end-to-end tasks with exact clock/tool/flags/input identity.
- [ ] Record cycles, instructions, memory/branch/wait events, footprint,
      observed execution high-water marks, deadlines, control quality, and P0
      activity/energy comparisons.
- [ ] Open `doc/plans/w0-workload-discovery/` when implementation starts and
      trace stable W0 requirement IDs into tests and actual results.
- [ ] Pass the W0 accelerator gate before specifying A0: repeatable common
      hotspot, bounded numeric/fault behavior, full transfer/software overhead,
      and feasible area/timing/power/verification cost.

**W0 exit gate:** at least one stable C0/M0-relevant end-to-end workload and
comparable algorithm baselines identify a repeatable bounded kernel, or produce
a documented no-accelerator decision. A0 remains gated by P1 counters and a
stable C0/M0 workload.

---

## Continuous Track U — Scalable UVM adoption

**Status:** architecture accepted in AR-026; UVM 1.2 toolchain sub-gate
verified on 2026-09-16; passive retirement integration not started.

This track is additive. Directed smoke, ACT4, focused SVA testbenches,
firmware, synthesis/timing, and board checks remain required evidence. Create
only directories needed by the current slice; do not add empty cache/MMU/GPU/
NPU placeholders.

Detailed design and directory ownership are in
[`doc/ar/AR026_SCALABLE_UVM_VERIFICATION_ARCHITECTURE.md`](doc/ar/AR026_SCALABLE_UVM_VERIFICATION_ARCHITECTURE.md)
and [`docs/verification_framework.md`](docs/verification_framework.md).

### U0 — Toolchain and passive retirement vertical slice (optional parallel track)

- [x] Prove which UVM version the installed ModelSim/Questa toolchain can
      compile and run. ModelSim SE-64 2019.2 explicitly selects its installed
      UVM 1.2 library, runs `uvm_test`/`run_phase`, reports zero UVM
      errors/fatals, and rejects a false-marker run with exit 3. Commands and
      evidence are retained under `doc/plans/u0-passive-uvm/`.
- [ ] Create the minimum real tree: `verif/uvm/domains/retirement`,
      `verif/uvm/tb/interfaces`, `verif/uvm/adapters`,
      `verif/uvm/envs/core`, `verif/uvm/tests`, and the required simulation
      filelist/script. Do not create unused future directories.
- [ ] Define `retire_event` with a lossless mapping from `commit_pkt_t` and a
      separate `trap_entry_event` mapping from `trap_entry_t`; preserve
      instruction commit versus asynchronous entry semantics and include
      64-bit `order`, `hart_id=0`, and `retire_lane=0` from the start.
- [ ] Add a clocking-block-based passive commit interface and monitor. The
      slice must not drive the DUT or change memory/fetch timing.
- [ ] Add an ordered retirement scoreboard plus independent committed-`tohost`
      and retirement-coverage subscribers.
- [ ] Reproduce existing commit order/count, trap/write exclusion, and test
      completion on a small smoke subset.
- [ ] Add a negative infrastructure test proving an injected mismatch produces
      a native nonzero simulator result and cannot be classified PASS.
- [ ] Run focused retirement plus 23/23 smoke and keep the unified release flow
      green; record compile/runtime overhead.

**U0 exit gate:** the passive UVM slice agrees with the existing architectural
checks, detects a deliberate mismatch, introduces no DUT timing/behavior
change, and leaves every existing release gate available.

### U1 — ISA differential checking

- [ ] Place Spike, Sail, or another selected model behind a typed adapter; the
      core environment and scoreboard must not depend on model-specific APIs.
- [ ] Establish one authoritative memory view and define interrupt/MMIO/model
      synchronization rules before continuous comparison.
- [ ] Compare existing directed programs first, including traps, CSR behavior,
      loads/stores, and `tohost`, then preserve every mismatch as a regression.

### U2 — Generated instruction workloads

- [ ] Integrate riscv-dv through a target capability description and
      machine-readable testlist.
- [ ] Archive generator configuration, seed, generated program, tool/model
      versions, and failure signature for exact reproduction.
- [ ] Keep ACT4 as the architectural standards gate; random generation is
      complementary coverage, not a replacement.

### U3 — Active memory and register verification

- [ ] Add reactive instruction/data memory agents only after their latency,
      error, reset, kill, and authoritative-state contracts are documented.
- [ ] Extend the accepted SoC-map schema with access policy and side-effect
      metadata needed to generate UVM RAL; do not hand-maintain a parallel map.
- [ ] Add block/core/SoC virtual sequences without exposing protocol handles
      directly to domain scoreboards.

### U4 — Cache, MMU, multicore, GPU, and NPU expansion

- [ ] Add translation, coherence, and accelerator domains only with the RTL
      feature that consumes them.
- [ ] Use `source_id`, `hart_id`, `txn_id`, `epoch`, and explicit order rules;
      add warp/lane/context identity only to the accelerator domain.
- [ ] Replace FIFO-only comparison with associative or partial-order checking
      wherever legal completion order is not unique.
- [ ] Add SVA/formal checks for protocol safety, coherence invariants,
      deadlock, starvation, barriers/fences, and forward progress.

---

## Active Track P0 — Reproducible workload power baseline

**Status:** measurement infrastructure and all six REQ-P0-001 scenario classes
VERIFIED on exact 95 MHz routes. The older 4%/no-clock spike remains rejected;
direct SAIF mapping is still only about 5.5%, with a reviewed per-block
alternative. No physical board-rail power claim is made.

The authoritative package is
[`doc/plans/p0-power-baseline/`](doc/plans/p0-power-baseline/). P0 changes
measurement only; it does not add clock gating, power domains, or MMIO.

- [x] Confirm the installed ModelSim exposes VCD capture commands.
- [x] Confirm the installed ModelSim exposes `power add/on/off/report` and
      backward-SAIF output; this is capability evidence, not a power result.
- [x] Define stable P0 requirements, workload classes, measurement identity,
      negative test, repeatability gate, and explicit limitations.
- [x] Establish the source-controlled [`power/`](power/) workload hierarchy,
      mandatory per-workload design/KPI contract, structured manifest gate, and
      all six workload design, identity, mapping-policy, and measured-result
      packages.
- [x] Select one short compute/memory test and run its existing functional
      oracle with `-DumpWaves`; record image/configuration, cycles, file size,
      command, tool version, and hashes.
- [x] Add a narrow, deterministic capture window after reset/warmup and emit a
      backward-SAIF for the SoC hierarchy; keep large activity under ignored
      build output.
- [x] Freeze matching implemented 95 MHz checkpoints and record part/speed
      grade, XDC clock, WNS/TNS, DRC, LUT/FF/BRAM/DSP, and environmental
      assumptions.
- [x] Run `read_saif` with the explicit testbench strip path; retain parse,
      matched/unmatched hierarchy, and fallback information.
- [x] Produce vectorless and activity-based reports from the same checkpoint
      and compare total/static/dynamic plus clock/logic/signal/BRAM/DSP/I/O.
- [x] Repeat an identical workload independently and meet the 2% dynamic-power
      repeatability gate or explain/mark the result PARTIAL.
- [x] Add UART polling, FreeRTOS steady-state, and fixed clocked spin-idle
      windows; keep WFI+timer as the separate sleep/wake scenario. All six
      pass functional, route, reviewed block-coverage, and two-run <=2%
      dynamic-power gates.
- [x] Run one deliberate missing-file or bad-strip-path case and require a
      native error or explicit FAIL.

**P0 exit gate:** at least two representative workloads pass functionally,
map activity into the same valid routed design with retained annotation
summaries, repeat within the stated bound, and distinguish estimate from
unmeasured board/ASIC power.

---

## Deferred work after the FreeRTOS milestone

These may improve performance or broaden the SoC, but they are not prerequisites
for the first FreeRTOS FPGA demonstration:

- [ ] EX/MEM/WB forwarding and reduced RAW stalls.
- [x] Add the AR-027 replaceable RV32M facade and shared single-product
  combinational multiplier; focused protocol/corner/kill tests, smoke 23/23,
  ACT4 RV32M 8/8, FreeRTOS demo, layered lint, 4-DSP OOC synthesis, and the
  exact-board 25 MHz route at WNS +17.517 ns pass.
- [x] Freeze the production scalar/core-bus contract at RV32 in AR-029; remove
  unsupported RV64 macro branches and shadow core/SoC/bus/peripheral `AW`/`DW`
  parameters while retaining 64-bit timers/counters and genuine RAM/divider
  parameters. Focused/full verification is recorded in the phase evidence
  package.
- [x] Implement and evaluate the AR-030 registered blocking multiplier behind
  `rv32m_unit`. Focused 175-case, divider 42-case, smoke 23/23, ACT4 47/47,
  layered lint, 95/100 MHz routes, and two-run `p0_mix`/`p0_idle_spin` power
  comparisons pass their declared gates. Accept it for 95 MHz; 100 MHz remains
  deferred on the new timer-to-EX/WB critical path (WNS -0.312 ns).
- [x] Complete AR-031 core-control ownership: typed redirect candidates,
  retirement-over-EX priority, one `pipe_ctrl_t`, retirement-owned MRET, and
  centralized fetch/hold/flush/kill actions. Focused/protocol/smoke/ACT4/lint
  pass; exact 95/100 MHz routes close at +0.078/+0.098 ns. The P1-relative cost
  is +121 LUT/-2 FF with unchanged BRAM/DSP and neutral `p0_mix` power/cycles.
- [x] Complete the first AR-032 P3 semantic-cleanup slice: reserve `_i/_o` for
  ports in decode/execute, remove redundant pass-through aliases, and build
  ID/EX and EX/WB packets from canonical bubbles. Focused/protocol tests,
  smoke 23/23, ACT4 47/47, and layered lint pass; ALU/immediate/alignment
  extraction remains gated by dedicated contracts and tests.
- [x] UART RX FIFO baseline; keep external UART interrupt deferred.
- [ ] Machine software interrupt (`msip`).
- [ ] PLIC or a small external interrupt controller.
- [ ] AXI bridge and access to Zynq PS DDR.
- [ ] JTAG RISC-V Debug Module and GDB integration.
- [ ] Random instruction generation and continuous Spike differential testing;
      execute through U1/U2 rather than as an ad-hoc standalone environment.
- [ ] Additional performance events, `mcountinhibit`, and profiling beyond the
      existing `mcycle`/`minstret` baseline.
- [ ] Linux research: S/U modes, MMU, atomics, OpenSBI, DDR, and a larger ISA.

## Immediate next action — advance from the SoC foundation, not skip to hardware

The owner's current development focus is the CV2 specification-first rewrite
above. Start with its ALU specification/model/checker pilot while freezing the
core-facing contracts. The list below retains the independent v1/program
maintenance and research gates; it does not make CV2 RTL implemented.

1. Use the verified six-workload P0 baseline for later architectural
   comparisons; do not claim 80% direct SAIF mapping or physical board power.
2. AR-030's registered multiplier is the 95 MHz production default. Its next
   action is maintenance only; do not parameterize stage count without a new
   throughput/latency requirement.
3. The exact AR-031 build now closes 100 MHz, but with only +0.098 ns margin.
   Before treating 100 MHz as a product guarantee, run seed/temperature/board
   closure and address the operand-to-redirect-to-ID/EX-enable control path.
4. Continue U0 later or in parallel only through the installed/licensed tool
   path. UVM 1.2 compile/runtime and the negative result gate now pass; the next
   U0 work is the passive retirement contract/monitor, not a download. U0 does
   not block P0.
5. Execute the research plan's `W0-D1` decision contract first. Only after its
   GO outcome, start the bounded rule/PI reference and C workload; CoreMark is
   a secondary L1 baseline, not the accelerator-selection gate.
6. Advance M0 low-order modelling and C0 safe-control requirements in parallel;
   open their evidence packages only with stable requirement IDs, and do not
   treat documentation as implementation evidence.
7. Open P1 as the measurement-driven low-power/counter slice; its events should
   serve W0 profiling without making A0 eligible before stable C0/M0 evidence.
8. Confirm the XC7Z010 speed grade from a reliable vendor/device record; keep
   targeting conservative `xc7z010clg400-1` until then.
9. When rebuilding board images, retain the exact bitstream SHA-256 and run
   duration alongside the existing UART/reset evidence.
10. Keep the 47-test ACT4, 23-test smoke, scheduler-soak, and board timing/DRC
   gates active for future changes.

Do not jump directly from the present SoC to a motor, compressor, plasma/electric
thruster, or human-carrying platform. The first propulsion-relevant work starts
only after P0 with C0 safe low-energy control and M0 versioned plant modelling;
C1 sensing, M1 HIL/bench correlation, energy/thermal/flow feasibility and an
explicit safety case must precede any integrated high-energy experiment.

Default-branch integration is deliberately deferred. It must later follow the
reviewed [`doc/RELEASE_CHECKLIST.md`](doc/RELEASE_CHECKLIST.md); merely switching
the GitHub default branch is not an implementation or release gate.
