HeTPort/Rsicv-soc/src/core/riscv.sv

`timescale 1ns / 1ps
`default_nettype none
import riscv_pkg::*;

module riscv (
  input  wire logic          clk_i,
  input  wire logic          rst_ni,
  output logic          instr_ren_o,
  output logic [AW-1:0] instr_addr_o,
  input  wire logic [DW-1:0] instr_rdata_i,
  input  wire logic          instr_fetch_error_i,
  output logic          data_req_valid_o,
  input  wire logic          data_req_ready_i,
  output core_bus_req_t data_req_o,
  input  wire logic          data_rsp_valid_i,
  input  wire core_bus_rsp_t data_rsp_i,
  input  wire logic          irq_mti_i,
  output logic          wfi_wait_o,
  output trap_entry_t   trap_entry_o,
  output logic          illegal_instr_o,
  output logic          exception_o,
  output commit_pkt_t   commit_o
);
  // ============================================================
  // 1. Pipeline Payload Structures (Vertical Data Flow)
  // ============================================================
  fetch_pkt_t if2id_pkt, if2id_pkt_out;
  id_ex_pkt_t id2ex_pkt, id2ex_pkt_out;
  ex_wb_pkt_t ex2wb_pkt_in, ex2wb_pkt_in_safe, ex2wb_pkt_out;

  // ============================================================
  // 2. Horizontal Control & Bus Signals
  // ============================================================
  logic [AW-1:0] if_pc;
  logic [AW-1:0] if_resp_pc_q;
  logic          if_resp_valid_q;

  // Regfile interface
  logic [4:0]    id_rs1_raddr;
  logic [4:0]    id_rs2_raddr;
  logic [DW-1:0] id_rs1_rdata;
  logic [DW-1:0] id_rs2_rdata;
  logic          wb_rf_wen;
  logic [4:0]    wb_rf_waddr;
  logic [DW-1:0] wb_rf_wdata;

  // Architectural retirement contracts
  rf_write_cmd_t    retire_rf_write;
  csr_write_req_t   csr_preview_req;
  csr_retire_cmd_t  csr_retire_cmd;
  csr_irq_context_t csr_irq_context;
  redirect_t        retire_redirect;
  trap_entry_t      retire_trap_entry;
  logic             retire_wfi_enter;
  logic             retire_wfi_wait;

  // EX produces a candidate; centralized control owns redirect selection.
  redirect_t     ex_redirect_candidate;

  // CSR interface
  logic [DW-1:0] csr_rdata;
  logic [DW-1:0] csr_rdata_for_ex;
  logic          csr_implemented;
  logic          csr_read_only;
  logic          csr_privilege_ok;
  logic [AW-1:0] csr_mepc;

  // Trap / mret controls
  logic          wb_trap_event;

  // LSU <-> pipeline interface
  mem_pkt_t       lsu_mem_info;
  logic           lsu_mem_misaligned;
  logic [DW-1:0]  lsu_raw_rdata;
  logic [DW-1:0]  lsu_load_data;
  logic           lsu_load_fault;
  logic           lsu_store_fault;
  logic           lsu_busy;
  logic           lsu_complete;
  logic           ex_mem_transaction;

  // Replaceable RV32M unit <-> pipeline interface
  rv32m_req_t     rv32m_req;
  rv32m_rsp_t     rv32m_rsp;
  logic           rv32m_req_valid;
  logic           rv32m_req_ready;
  logic           rv32m_rsp_valid;
  logic           rv32m_wait;
  logic           ex_wait;

  // ============================================================
  // 3. Control Unit Interface Signals
  // ============================================================
  redirect_t selected_redirect;
  pipe_ctrl_t pipe_ctrl;

  retire_stage u_retire_stage (
    .clk_i             (clk_i),
    .rst_ni            (rst_ni),
    .pkt_i             (ex2wb_pkt_out),
    .csr_irq_context_i (csr_irq_context),
    .irq_defer_i       (ex_wait),
    .csr_preview_req_o (csr_preview_req),
    .rf_write_cmd_o    (retire_rf_write),
    .csr_retire_cmd_o  (csr_retire_cmd),
    .redirect_o        (retire_redirect),
    .trap_entry_o      (retire_trap_entry),
    .commit_o          (commit_o),
    .sync_trap_o       (wb_trap_event),
    .wfi_enter_o       (retire_wfi_enter),
    .wfi_wait_o        (retire_wfi_wait)
  );

  assign wfi_wait_o   = retire_wfi_wait;
  assign trap_entry_o = retire_trap_entry;

  // ============================================================
  // 4. Core Control Unit Instantiation
  // ============================================================
  core_ctrl u_core_ctrl (
    .clk_i             (clk_i),
    .rst_ni            (rst_ni),
    .id_valid_i        (if2id_pkt_out.valid),
    .id_rs1_addr_i     (id_rs1_raddr),
    .id_rs2_addr_i     (id_rs2_raddr),
    .id_use_rs1_i      (id2ex_pkt.use_rs1),
    .id_use_rs2_i      (id2ex_pkt.use_rs2),
    .ex_valid_i        (id2ex_pkt_out.valid),
    .ex_rd_addr_i      (id2ex_pkt_out.rf.addr),
    .ex_rf_we_i        (id2ex_pkt_out.rf.we),
    .ex_exc_i          (id2ex_pkt_out.exc),
    .ex_redirect_i     (ex_redirect_candidate),
    .ex_wait_i         (ex_wait),
    .retire_redirect_i (retire_redirect),
    .wfi_enter_i       (retire_wfi_enter),
    .wfi_wait_i        (retire_wfi_wait),
    .redirect_o        (selected_redirect),
    .pipe_ctrl_o       (pipe_ctrl)
  );

  assign illegal_instr_o = ex2wb_pkt_out.valid && ex2wb_pkt_out.exc.illegal_instr;
  assign exception_o     = wb_trap_event;

  // ============================================================
  // 4.5 CSR Register File
  // ============================================================
  logic wb_csr_we;
  logic [11:0] wb_csr_addr;
  logic [DW-1:0] wb_csr_wdata_effective;
  logic [AW-1:0] csr_mepc_for_ex;

  assign wb_csr_we    = csr_preview_req.valid;
  assign wb_csr_addr  = csr_preview_req.addr;
  // An adjacent CSR instruction in EX must observe the effective (WARL-filtered)
  // value written by the older CSR instruction in WB.
  assign csr_rdata_for_ex =
      (wb_csr_we && (wb_csr_addr == id2ex_pkt_out.csr.addr)) ?
      wb_csr_wdata_effective : csr_rdata;

  // MRET may immediately follow a write to mepc. Reuse the same effective
  // WB value so redirect generation cannot use stale or unaligned state.
  assign csr_mepc_for_ex =
      (wb_csr_we && (wb_csr_addr == CSR_MEPC)) ?
      AW'(wb_csr_wdata_effective) : csr_mepc;

  csr_regfile u_csr_regfile (
    .clk_i        (clk_i),
    .rst_ni       (rst_ni),
    .current_priv_i(PRIV_MODE_M),
    // Read port (used in EX stage)
    .csr_addr_i   (id2ex_pkt_out.csr.addr),
    .csr_rdata_o  (csr_rdata),
    .csr_implemented_o(csr_implemented),
    .csr_read_only_o(csr_read_only),
    .csr_privilege_ok_o(csr_privilege_ok),
    // Preview and clocked retirement command
    .preview_req_i             (csr_preview_req),
    .preview_wdata_effective_o (wb_csr_wdata_effective),
    .irq_context_o             (csr_irq_context),
    .retire_cmd_i              (csr_retire_cmd),
    .irq_mti_i                 (irq_mti_i),
    .mepc_o       (csr_mepc)
  );

`ifndef SYNTHESIS
  always_ff @(posedge clk_i) begin
    if (ex2wb_pkt_out.valid && ex2wb_pkt_out.exc.illegal_instr)
      $info("RV32IM core illegal instruction detected; entering trap handler");
    if (ex2wb_pkt_out.valid && ex2wb_pkt_out.exc.ecall)
      $info("RV32IM core ECALL detected; entering trap handler");
    if (ex2wb_pkt_out.valid && ex2wb_pkt_out.exc.ebreak)
      $info("RV32IM core EBREAK detected; entering trap handler");
    if (ex2wb_pkt_out.valid && ex2wb_pkt_out.instr_misaligned)
      $info("RV32IM core instruction-address misalignment detected; entering trap handler");
    if (ex2wb_pkt_out.valid && ex2wb_pkt_out.mem_misaligned)
      $info("RV32IM core memory misaligned access detected; entering trap handler");
  end
`endif

  // ============================================================
  // 5. PC & IF Stage
  // ============================================================
  pc_counter #(
    .RESET_PC('0)
  ) u_pc_counter (
    .clk_i        (clk_i),
    .rst_ni       (rst_ni),
    .stall_i      (pipe_ctrl.pc_stall),
    .redirect_en_i(selected_redirect.valid),
    .redirect_pc_i(selected_redirect.pc),
    .pc_o         (if_pc)
  );
  assign instr_ren_o  = pipe_ctrl.instr_req;
  assign instr_addr_o = if_pc;

  always_ff @(posedge clk_i or negedge rst_ni) begin
    if (!rst_ni) begin
      if_resp_pc_q    <= '0;
      if_resp_valid_q <= 1'b0;
    end else begin
      if (instr_ren_o) begin
        if_resp_pc_q    <= instr_addr_o;
        if_resp_valid_q <= 1'b1;
      end
    end
  end

  assign if2id_pkt.valid = if_resp_valid_q;
  assign if2id_pkt.error = if_resp_valid_q && instr_fetch_error_i;
  assign if2id_pkt.pc    = if_resp_pc_q;
  assign if2id_pkt.instr = instr_rdata_i;

  // ============================================================
  // 6. Pipeline Registers & Datapath
  // ============================================================
  if2id u_if2id (
    .clk_i   (clk_i),
    .rst_ni  (rst_ni),
    .flush_i (pipe_ctrl.ifid_flush),
    .stall_i (pipe_ctrl.ifid_stall),
    .pkt2id_i (if2id_pkt),
    .pkt2id_o (if2id_pkt_out)
  );

  decode u_decode (
    .pktd_i          (if2id_pkt_out),
    .rf_rs1_raddr_o (id_rs1_raddr),
    .rf_rs2_raddr_o (id_rs2_raddr),
    .rf_rs1_rdata_i (id_rs1_rdata),
    .rf_rs2_rdata_i (id_rs2_rdata),
    .pktd_o          (id2ex_pkt)
  );

  id2ex u_id2ex (
    .clk_i   (clk_i),
    .rst_ni  (rst_ni),
    .flush_i (pipe_ctrl.idex_flush),
    .stall_i (pipe_ctrl.idex_stall),
    .pkt2ex_i (id2ex_pkt),
    .pkt2ex_o (id2ex_pkt_out)
  );

  assign rv32m_req_valid = id2ex_pkt_out.valid &&
                           id2ex_pkt_out.ex_ctrl.muldiv_valid;
  assign rv32m_req.op    = id2ex_pkt_out.ex_ctrl.muldiv_op;
  assign rv32m_req.lhs   = id2ex_pkt_out.ex_data.op1;
  assign rv32m_req.rhs   = id2ex_pkt_out.ex_data.op2;

  assign ex_wait    = lsu_busy || rv32m_wait;

  rv32m_unit u_rv32m_unit (
    .clk_i       (clk_i),
    .rst_ni      (rst_ni),
    .req_valid_i (rv32m_req_valid),
    .req_ready_o (rv32m_req_ready),
    .req_i       (rv32m_req),
    .rsp_valid_o (rv32m_rsp_valid),
    .rsp_ready_i (1'b1),
    .rsp_o       (rv32m_rsp),
    .kill_i      (pipe_ctrl.ex_kill),
    .wait_o      (rv32m_wait),
    .busy_o      ()
  );

  // ============================================================
  // 7. Execute (no longer drives data_ram directly)
  // ============================================================
  execute u_execute (
    .pkt_exe_i        (id2ex_pkt_out),
    .mem_misaligned_i (lsu_mem_misaligned), // Feedback from LSU
    .csr_rdata_i      (csr_rdata_for_ex),
    .csr_implemented_i(csr_implemented),
    .csr_read_only_i  (csr_read_only),
    .csr_privilege_ok_i(csr_privilege_ok),
    .mepc_i           (csr_mepc_for_ex),
    .rv32m_result_i   (rv32m_rsp.result),
    .redirect_candidate_o(ex_redirect_candidate),
    .pkt_exe_o        (ex2wb_pkt_in)
  );

  // ============================================================
  // 8. LSU (Load/Store Unit) — transaction owner for the external data bus
  // ============================================================
  lsu u_lsu (
    .clk_i             (clk_i),
    .rst_ni            (rst_ni),
    .pkt_ex_i          (id2ex_pkt_out),
    .ex_kill_i         (pipe_ctrl.ex_kill),
    .bus_req_valid_o   (data_req_valid_o),
    .bus_req_ready_i   (data_req_ready_i),
    .bus_req_o         (data_req_o),
    .bus_rsp_valid_i   (data_rsp_valid_i),
    .bus_rsp_i         (data_rsp_i),
    .mem_info_o        (lsu_mem_info),
    .mem_misaligned_o  (lsu_mem_misaligned),
    .raw_rdata_o       (lsu_raw_rdata),
    .load_data_o       (lsu_load_data),
    .load_fault_o      (lsu_load_fault),
    .store_fault_o     (lsu_store_fault),
    .busy_o            (lsu_busy),
    .complete_o        (lsu_complete)
  );

  // ============================================================
  // 9. ex2wb_pkt_in_safe assembly
  //    A memory or divide instruction enters EX/WB only on completion.
  // ============================================================
  assign ex_mem_transaction = id2ex_pkt_out.valid &&
                              id2ex_pkt_out.ex_ctrl.mem_req &&
                              !lsu_mem_misaligned &&
                              !pipe_ctrl.ex_kill;

  always_comb begin
    ex2wb_pkt_in_safe = ex2wb_pkt_in;
    if (ex_mem_transaction) begin
      if (lsu_complete) begin
        ex2wb_pkt_in_safe.mem_info  = lsu_mem_info;
        ex2wb_pkt_in_safe.mem_valid = 1'b1;
        ex2wb_pkt_in_safe.mem_we    = data_req_o.write;
        ex2wb_pkt_in_safe.mem_addr  = data_req_o.addr;
        ex2wb_pkt_in_safe.mem_wdata = data_req_o.wdata;
        ex2wb_pkt_in_safe.mem_wstrb = data_req_o.wstrb;
        ex2wb_pkt_in_safe.mem_rdata = lsu_raw_rdata;
        ex2wb_pkt_in_safe.mem_load_data = lsu_load_data;
        ex2wb_pkt_in_safe.mem_error = lsu_load_fault || lsu_store_fault;
        if (lsu_load_fault || lsu_store_fault) begin
          ex2wb_pkt_in_safe.rf.we = 1'b0;
          ex2wb_pkt_in_safe.wb_sel = WB_NONE;
          ex2wb_pkt_in_safe.trap_cause =
              lsu_store_fault ? MCAUSE_STORE_ACCESS : MCAUSE_LOAD_ACCESS;
          ex2wb_pkt_in_safe.trap_val = data_req_o.addr;
        end
      end else begin
        ex2wb_pkt_in_safe = EX_WB_PKT_BUBBLE;
      end
    end

    if (rv32m_req_valid && !rv32m_rsp_valid)
      ex2wb_pkt_in_safe = EX_WB_PKT_BUBBLE;

    if (pipe_ctrl.pipe_kill)
      ex2wb_pkt_in_safe = EX_WB_PKT_BUBBLE;
  end

`ifndef SYNTHESIS
  always @(posedge clk_i) begin
    if (rst_ni) begin
      assert (!(wb_csr_we && !ex2wb_pkt_out.valid))
        else $error("Invalid EX/WB packet enabled a CSR write");

      if (pipe_ctrl.pipe_kill) begin
        assert (!(ex2wb_pkt_in_safe.valid ||
                  ex2wb_pkt_in_safe.rf.we ||
                  ex2wb_pkt_in_safe.csr.valid ||
                  ex2wb_pkt_in_safe.mem_valid))
          else $error("Pipeline kill did not clear EX/WB side effects");
        assert (!data_req_valid_o)
          else $error("Pipeline kill did not suppress the LSU request");
        assert (!rv32m_req_ready)
          else $error("Pipeline kill did not suppress RV32M request acceptance");
      end

      if (rv32m_req_valid && !rv32m_rsp_valid) begin
        assert (!ex2wb_pkt_in_safe.valid)
          else $error("Incomplete RV32M instruction entered EX/WB");
      end

    end
  end
`endif

  // ============================================================
  // 10. EX/WB Pipeline Register
  // ============================================================
  ex2wb u_ex2wb (
    .clk_i    (clk_i),
    .rst_ni   (rst_ni),
    .stall_i  (1'b0),
    .pkt2wb_i (ex2wb_pkt_in_safe),
    .pkt2wb_o (ex2wb_pkt_out)
  );

  // ============================================================
  // 11. Regfile
  // ============================================================
  assign wb_rf_wen      = retire_rf_write.valid;
  assign wb_rf_waddr    = retire_rf_write.addr;
  assign wb_rf_wdata    = retire_rf_write.data;

  regfile u_regfile (
    .clk_i       (clk_i),
    .rst_ni      (rst_ni),
    .rs1_raddr_i (id_rs1_raddr),
    .rs1_rdata_o (id_rs1_rdata),
    .rs2_raddr_i (id_rs2_raddr),
    .rs2_rdata_o (id_rs2_rdata),
    .rd_wen_i    (wb_rf_wen),
    .rd_waddr_i  (wb_rf_waddr),
    .rd_wdata_i  (wb_rf_wdata)
  );

`ifndef SYNTHESIS
  // Check stable post-clock values. Raw control fields may exist inside valid
  // instructions, so assert the externally effective side effects here.
  always @(negedge clk_i) begin
    if (rst_ni) begin
      if (!id2ex_pkt_out.valid) begin
        assert (!(data_req_valid_o || ex_redirect_candidate.valid))
          else $error("Invalid ID/EX packet caused an EX-stage side effect");
      end

      if (ex2wb_pkt_in.instr_misaligned) begin
        assert (!(ex_redirect_candidate.valid || ex2wb_pkt_in.rf.we))
          else $error("Misaligned control transfer was not suppressed");
        assert (ex2wb_pkt_in.trap_cause == MCAUSE_INST_MISALIGNED)
          else $error("Misaligned control transfer has the wrong trap cause");
        assert (ex2wb_pkt_in.trap_val[IALIGN_LSB-1:0] != '0)
          else $error("Misaligned control transfer has an aligned trap value");
      end

      if (!ex2wb_pkt_out.valid) begin
        assert (!(wb_rf_wen ||
                  wb_csr_we ||
                  ex2wb_pkt_out.mem_valid ||
                  ex2wb_pkt_out.mem_we ||
                  wb_trap_event ||
                  csr_retire_cmd.mret))
          else $error("Invalid EX/WB packet caused a retirement side effect");
      end
    end
  end
`endif

endmodule
`default_nettype wire
