HeTPort/Rsicv-soc/src/core/riscv_pkg.sv

`timescale 1ns / 1ps
`default_nettype wire
// ============================================================
// Package: riscv_pkg
// Description:
//   Global definitions for the simple RISC-V core.
//
// Notes:
//   - The production architecture is deliberately fixed to RV32IM.
//   - Opcode/funct3/funct7 constants are kept compatible with the original code.
//   - New enum control types are used to move instruction decode
//     out of execute and into decode.
// ============================================================
package riscv_pkg;

  // ------------------------------------------------------------
  // Section 1: Fixed architectural widths
  // ------------------------------------------------------------
  // Wide timers, counters, and future accelerators remain independent of XLEN.
  // A future RV64 core is a separately specified architecture, not a macro
  // configuration of this RV32 implementation.
  localparam int unsigned XLEN       = 32;
  localparam int unsigned AW         = 32;
  localparam int unsigned DW         = 32;
  localparam int unsigned REG_NUM    = 32;
  localparam int unsigned REG_ADDR_W = 5; // $clog2(32)
  localparam int unsigned BYTE_NUM   = DW / 8;
  localparam int unsigned IALIGN_BITS = 32;
  localparam int unsigned IALIGN_LSB  = $clog2(IALIGN_BITS / 8);

  localparam int unsigned SHAMT_W    = 5;

  // ------------------------------------------------------------
  // Section 2: Common instruction constants
  // ------------------------------------------------------------
  localparam logic [31:0] INST_NOP    = 32'h0000_0013; // addi x0,x0,0
  localparam logic [31:0] INST_ECALL  = 32'h0000_0073;
  localparam logic [31:0] INST_EBREAK = 32'h0010_0073;
  localparam logic [31:0] INST_MRET   = 32'h3020_0073; // 特权架构返回
  localparam logic [31:0] INST_WFI    = 32'h1050_0073;

  // ------------------------------------------------------------
  // Section 3: Opcodes
  // ------------------------------------------------------------
  localparam logic [6:0] OPCODE_LOAD     = 7'b0000011;
  localparam logic [6:0] OPCODE_MISC_MEM = 7'b0001111;
  localparam logic [6:0] OPCODE_OP_IMM   = 7'b0010011;
  localparam logic [6:0] OPCODE_AUIPC    = 7'b0010111;
  localparam logic [6:0] OPCODE_STORE    = 7'b0100011;
  localparam logic [6:0] OPCODE_OP       = 7'b0110011;
  localparam logic [6:0] OPCODE_LUI      = 7'b0110111;
  localparam logic [6:0] OPCODE_BRANCH   = 7'b1100011;
  localparam logic [6:0] OPCODE_JALR     = 7'b1100111;
  localparam logic [6:0] OPCODE_JAL      = 7'b1101111;
  localparam logic [6:0] OPCODE_SYSTEM   = 7'b1110011;
  
  // ------------------------------------------------------------
  // Section 4: OP-IMM funct3
  // ------------------------------------------------------------
  localparam logic [2:0] FUNCT3_ADDI  = 3'b000;
  localparam logic [2:0] FUNCT3_SLLI  = 3'b001;
  localparam logic [2:0] FUNCT3_SLTI  = 3'b010;
  localparam logic [2:0] FUNCT3_SLTIU = 3'b011;
  localparam logic [2:0] FUNCT3_XORI  = 3'b100;
  localparam logic [2:0] FUNCT3_SRI   = 3'b101;
  localparam logic [2:0] FUNCT3_ORI   = 3'b110;
  localparam logic [2:0] FUNCT3_ANDI  = 3'b111;

  // ------------------------------------------------------------
  // Section 5: OP funct3
  // ------------------------------------------------------------
  localparam logic [2:0] FUNCT3_ADD_SUB = 3'b000;
  localparam logic [2:0] FUNCT3_SLL     = 3'b001;
  localparam logic [2:0] FUNCT3_SLT     = 3'b010;
  localparam logic [2:0] FUNCT3_SLTU    = 3'b011;
  localparam logic [2:0] FUNCT3_XOR     = 3'b100;
  localparam logic [2:0] FUNCT3_SR      = 3'b101;
  localparam logic [2:0] FUNCT3_OR      = 3'b110;
  localparam logic [2:0] FUNCT3_AND     = 3'b111;

  // ------------------------------------------------------------
  // Section 6: Load funct3
  // ------------------------------------------------------------
  localparam logic [2:0] FUNCT3_LB  = 3'b000;
  localparam logic [2:0] FUNCT3_LH  = 3'b001;
  localparam logic [2:0] FUNCT3_LW  = 3'b010;
  localparam logic [2:0] FUNCT3_LBU = 3'b100;
  localparam logic [2:0] FUNCT3_LHU = 3'b101;

  // ------------------------------------------------------------
  // Section 7: Store funct3
  // ------------------------------------------------------------
  localparam logic [2:0] FUNCT3_SB = 3'b000;
  localparam logic [2:0] FUNCT3_SH = 3'b001;
  localparam logic [2:0] FUNCT3_SW = 3'b010;

  // ------------------------------------------------------------
  // Section 8: Branch funct3
  // ------------------------------------------------------------
  localparam logic [2:0] FUNCT3_BEQ  = 3'b000;
  localparam logic [2:0] FUNCT3_BNE  = 3'b001;
  localparam logic [2:0] FUNCT3_BLT  = 3'b100;
  localparam logic [2:0] FUNCT3_BGE  = 3'b101;
  localparam logic [2:0] FUNCT3_BLTU = 3'b110;
  localparam logic [2:0] FUNCT3_BGEU = 3'b111;

  // ------------------------------------------------------------
  // Section 9: funct7
  // ------------------------------------------------------------
  localparam logic [6:0] FUNCT7_BASE   = 7'b0000000;
  localparam logic [6:0] FUNCT7_ALT    = 7'b0100000;
  localparam logic [6:0] FUNCT7_MULDIV = 7'b0000001;

  // ------------------------------------------------------------
  // Section 10: Control Enumerations
  // ------------------------------------------------------------
  
  // ALU operation type
  typedef enum logic [4:0] {
    ALU_NONE   = 5'd0,
    ALU_ADD    = 5'd1,
    ALU_SUB    = 5'd2,
    ALU_SLL    = 5'd3,
    ALU_SLT    = 5'd4,
    ALU_SLTU   = 5'd5,
    ALU_XOR    = 5'd6,
    ALU_SRL    = 5'd7,
    ALU_SRA    = 5'd8,
    ALU_OR     = 5'd9,
    ALU_AND    = 5'd10,
    ALU_COPY_B = 5'd11
  } alu_op_e;

  // Branch operation type
  typedef enum logic [2:0] {
    BR_NONE = 3'd0,
    BR_BEQ  = 3'd1,
    BR_BNE  = 3'd2,
    BR_BLT  = 3'd3,
    BR_BGE  = 3'd4,
    BR_BLTU = 3'd5,
    BR_BGEU = 3'd6
  } branch_op_e;

  // Jump operation type
  typedef enum logic [1:0] {
    JMP_NONE = 2'd0,
    JMP_JAL  = 2'd1,
    JMP_JALR = 2'd2
  } jump_op_e;

  // Memory access size
  typedef enum logic [1:0] {
    MEM_SIZE_BYTE = 2'd0,
    MEM_SIZE_HALF = 2'd1,
    MEM_SIZE_WORD = 2'd2
  } mem_size_e;

  // Writeback select type
  typedef enum logic [2:0] {
    WB_NONE   = 3'd0,
    WB_ALU    = 3'd1,
    WB_MEM    = 3'd2,
    WB_PC4    = 3'd3,
    WB_MULDIV = 3'd4,
    WB_CSR    = 3'd5
  } wb_sel_e;

  // ------------------------------------------------------------
  // Section 10a: CSR addresses
  // ------------------------------------------------------------
  localparam logic [11:0] CSR_MSTATUS   = 12'h300;
  localparam logic [11:0] CSR_MISA      = 12'h301;
  localparam logic [11:0] CSR_MEDELEG   = 12'h302;
  localparam logic [11:0] CSR_MIDELEG   = 12'h303;
  localparam logic [11:0] CSR_MIE       = 12'h304;
  localparam logic [11:0] CSR_MTVEC     = 12'h305;
  localparam logic [11:0] CSR_MSCRATCH  = 12'h340;
  localparam logic [11:0] CSR_MEPC      = 12'h341;
  localparam logic [11:0] CSR_MCAUSE    = 12'h342;
  localparam logic [11:0] CSR_MTVAL     = 12'h343;
  localparam logic [11:0] CSR_MIP       = 12'h344;
  localparam logic [11:0] CSR_MCYCLE    = 12'hB00;
  localparam logic [11:0] CSR_MINSTRET  = 12'hB02;
  localparam logic [11:0] CSR_MCYCLEH   = 12'hB80;
  localparam logic [11:0] CSR_MINSTRETH = 12'hB82;
  localparam logic [11:0] CSR_MVENDORID = 12'hF11;
  localparam logic [11:0] CSR_MARCHID   = 12'hF12;
  localparam logic [11:0] CSR_MIMPID    = 12'hF13;
  localparam logic [11:0] CSR_MHARTID   = 12'hF14;
  localparam logic [11:0] CSR_MCONFIGPTR = 12'hF15;

  // ------------------------------------------------------------
  // Section 10b: mcause exception / interrupt codes
  // ------------------------------------------------------------
  // Interrupt bit is at RV32 mcause[31].
  localparam logic [DW-1:0] MCAUSE_INST_MISALIGNED  = {1'b0, 31'd0};
  localparam logic [DW-1:0] MCAUSE_INST_ACCESS      = {1'b0, 31'd1};
  localparam logic [DW-1:0] MCAUSE_ILLEGAL_INST     = {1'b0, 31'd2};
  localparam logic [DW-1:0] MCAUSE_BREAKPOINT       = {1'b0, 31'd3};
  localparam logic [DW-1:0] MCAUSE_LOAD_MISALIGNED  = {1'b0, 31'd4};
  localparam logic [DW-1:0] MCAUSE_LOAD_ACCESS      = {1'b0, 31'd5};
  localparam logic [DW-1:0] MCAUSE_STORE_MISALIGNED = {1'b0, 31'd6};
  localparam logic [DW-1:0] MCAUSE_STORE_ACCESS     = {1'b0, 31'd7};
  localparam logic [DW-1:0] MCAUSE_ECALL_U          = {1'b0, 31'd8};
  localparam logic [DW-1:0] MCAUSE_ECALL_S          = {1'b0, 31'd9};
  localparam logic [DW-1:0] MCAUSE_ECALL_M          = {1'b0, 31'd11};

  localparam logic [DW-1:0] MCAUSE_IRQ_M_SOFT       = {1'b1, 31'd3};
  localparam logic [DW-1:0] MCAUSE_IRQ_M_TIMER      = {1'b1, 31'd7};
  localparam logic [DW-1:0] MCAUSE_IRQ_M_EXT        = {1'b1, 31'd11};

  localparam int MSTATUS_MIE_BIT  = 3;
  localparam int MSTATUS_MPIE_BIT = 7;
  localparam int MIE_MTIE_BIT     = 7;
  localparam int MIP_MTIP_BIT     = 7;

  // Multiply/divide operation type
  typedef enum logic [3:0] {
    MULDIV_NONE   = 4'd0,
    MULDIV_MUL    = 4'd1,
    MULDIV_MULH   = 4'd2,
    MULDIV_MULHSU = 4'd3,
    MULDIV_MULHU  = 4'd4,
    MULDIV_DIV    = 4'd5,
    MULDIV_DIVU   = 4'd6,
    MULDIV_REM    = 4'd7,
    MULDIV_REMU   = 4'd8
  } muldiv_op_e;

  // Stable transaction payloads for replaceable RV32M implementations.
  // The current core is RV32-only, but using DW here keeps the contract tied
  // to the architectural data width rather than to one implementation.
  typedef struct packed {
    muldiv_op_e    op;
    logic [DW-1:0] lhs;
    logic [DW-1:0] rhs;
  } rv32m_req_t;

  typedef struct packed {
    logic [DW-1:0] result;
  } rv32m_rsp_t;

  // Privilege modes
  typedef enum logic [1:0] {
    PRIV_MODE_U = 2'd0,
    PRIV_MODE_S = 2'd1,
    PRIV_MODE_M = 2'd3
  } priv_mode_e;

  // CSR operation type (matches SYSTEM funct3)
  typedef enum logic [2:0] {
    CSR_OP_NONE = 3'b000,
    CSR_OP_RW   = 3'b001,
    CSR_OP_RS   = 3'b010,
    CSR_OP_RC   = 3'b011,
    CSR_OP_RWI  = 3'b101,
    CSR_OP_RSI  = 3'b110,
    CSR_OP_RCI  = 3'b111
  } csr_op_e;

  typedef enum logic [2:0] {
    REDIRECT_NONE      = 3'd0,
    REDIRECT_BRANCH    = 3'd1,
    REDIRECT_JUMP      = 3'd2,
    REDIRECT_MRET      = 3'd3,
    REDIRECT_SYNC_TRAP = 3'd4,
    REDIRECT_INTERRUPT = 3'd5
  } redirect_reason_e;

   // ============================================================
  // Section 11: Pipeline Payload Structures
  // ============================================================

  // 11.1 Fetch Packet (对应 if2id 模块的接口)
  // error: instruction fetch returned an invalid/unmapped response.
  //        The instruction field is architecturally meaningless when error=1.
  typedef struct packed {
    logic          valid;
    logic          error;
    logic [AW-1:0] pc;
    logic [DW-1:0] instr;
  } fetch_pkt_t;

  // 11.2 Register File Write Control (对应 rd, rf_we)
  // 注意：wdata 不在此包内，因为 wdata 是在 WB 阶段才最终生成的
  typedef struct packed {
    logic          we;    // 对应 rf_we
    logic [4:0]    addr;  // 对应 rd / rf_waddr
  } rf_pkt_t;

  // 11.3 Execute Data Payload (对应 op1, op2, imm, store_data)
  typedef struct packed {
    logic [DW-1:0] op1;
    logic [DW-1:0] op2;
    logic [DW-1:0] imm;
    logic [DW-1:0] store_data;
  } ex_data_pkt_t;

  // 11.4 Execute Control Payload (对应译码后的所有控制信号)
  typedef struct packed {
    alu_op_e       alu_op;
    branch_op_e    branch_op;
    jump_op_e      jump_op;
    logic          mem_req;
    logic          mem_we;
    mem_size_e     mem_size;
    logic          mem_unsigned;
    wb_sel_e       wb_sel;
    logic          muldiv_valid;
    muldiv_op_e    muldiv_op;
  } ex_ctrl_pkt_t;

  // 11.5 Exception Packet (对应 ID/EX 阶段的异常信号)
  // 注意: mem_misaligned 是在 EX 阶段计算出的，所以不在此包中
  //       instr_access_fault is set when the instruction fetch itself failed;
  //       it suppresses decode-time exception interpretation of the bogus instr bits.
  typedef struct packed {
    logic          illegal_instr;
    logic          instr_access_fault;
    logic          ecall;
    logic          ebreak;
  } exc_pkt_t;

  // 11.6 Memory Info Packet (对应 ex2wb 和 wb_stage 的 mem 接口)
  typedef struct packed {
    mem_size_e     mem_size;
    logic          mem_unsigned;
    // RV32 byte offset within one 32-bit word.
    logic [1:0]    load_offset;
  } mem_pkt_t;

  // Single-outstanding CPU data-bus payloads. Handshake state remains in the
  // LSU; adapters outside the CPU translate these payloads to RAM/APB/AXI.
  typedef struct packed {
    logic [AW-1:0]   addr;
    logic            write;
    mem_size_e       size;
    logic [DW-1:0]   wdata;
    logic [DW/8-1:0] wstrb;
  } core_bus_req_t;

  typedef struct packed {
    logic [DW-1:0] rdata;
    logic          error;
  } core_bus_rsp_t;

  // Semantic retirement contracts. These structures group signals that share
  // one owner, validity rule, direction, and architectural lifetime.
  typedef struct packed {
    logic          valid;
    logic [4:0]    addr;
    logic [DW-1:0] data;
  } rf_write_cmd_t;

  typedef struct packed {
    logic          valid;
    logic [11:0]   addr;
    logic [DW-1:0] wdata;
  } csr_write_req_t;

  typedef struct packed {
    logic [DW-1:0] mstatus;
    logic [DW-1:0] mie;
    logic [DW-1:0] mip;
    logic [AW-1:0] mtvec;
  } csr_irq_context_t;

  typedef struct packed {
    logic          valid;
    logic          interrupt;
    logic [AW-1:0] pc;
    logic [DW-1:0] cause;
    logic [DW-1:0] tval;
  } trap_entry_t;

  typedef struct packed {
    logic             valid;
    logic [AW-1:0]    pc;
    redirect_reason_e reason;
  } redirect_t;

  // Same-cycle pipeline movement actions. These fields share one producer
  // (`core_ctrl`), direction, and validity window; functional-unit protocol
  // state and architectural retirement commands deliberately remain separate.
  typedef struct packed {
    logic pc_stall;
    logic instr_req;
    logic ifid_stall;
    logic idex_stall;
    logic ifid_flush;
    logic idex_flush;
    logic pipe_kill;
    logic ex_kill;
  } pipe_ctrl_t;

  typedef struct packed {
    csr_write_req_t csr_write;
    trap_entry_t    trap;
    logic           mret;
    logic           instret;
  } csr_retire_cmd_t;

  // 11.7 CSR Packet
  typedef struct packed {
    logic          valid;     // This instruction is a CSR operation
    logic          write;     // Architectural write intent after zero-source rules
    csr_op_e       op;        // CSR sub-operation
    logic [11:0]   addr;      // CSR address
    logic [DW-1:0] wdata;     // Source data (rs1 or zero-extended uimm)
    logic [4:0]    rd;        // Destination register
  } csr_pkt_t;

  // ============================================================
  // Section 12: Aggregate Pipeline Packets
  // ============================================================

  // 12.1 ID/EX Pipeline Register Payload (精确对应 id2ex 模块的数据接口)
  typedef struct packed {
    logic          valid;
    logic [AW-1:0] pc;
    logic [DW-1:0] instr;
    rf_pkt_t       rf;          // 包含 rf_we, rd
    ex_data_pkt_t  ex_data;     // 包含 op1, op2, imm, store_data
    ex_ctrl_pkt_t  ex_ctrl;     // 包含 alu_op, branch_op, mem_req 等
    exc_pkt_t      exc;         // 包含 illegal_instr, instr_access_fault, ecall, ebreak
    csr_pkt_t      csr;         // CSR 指令信息
    logic          is_mret;     // Instruction is mret
    logic          is_wfi;      // Instruction is wfi
    logic          use_rs1;
    logic          use_rs2;
  } id_ex_pkt_t;

  // 12.2 EX/WB Pipeline Register Payload (精确对应 ex2wb 模块的数据接口)
  typedef struct packed {
    logic          valid;
    logic [AW-1:0] pc;
    logic [AW-1:0] next_pc;     // Architectural resume PC after this instruction
    logic [31:0]   instr;
    rf_pkt_t       rf;          // 包含 rf_wen, rf_waddr
    wb_sel_e       wb_sel;
    logic [DW-1:0] alu_data;
    logic [DW-1:0] pc4_data;
    mem_pkt_t      mem_info;    // 包含 mem_size, mem_unsigned, load_offset
    logic          mem_valid;   // Memory request was actually issued
    logic          mem_we;      // 1: store, 0: load
    logic [AW-1:0] mem_addr;
    logic [DW-1:0] mem_wdata;
    logic [DW/8-1:0] mem_wstrb;
    logic [DW-1:0] mem_rdata;     // Registered raw bus response
    logic [DW-1:0] mem_load_data; // Registered aligned/extended load value
    logic          mem_error;     // Registered response error
    logic          instr_misaligned; // Taken control-flow target violates IALIGN
    logic          mem_misaligned; // EX 阶段新增的异常
    exc_pkt_t      exc;         // 包含 illegal_instr, instr_access_fault, ecall, ebreak
    csr_pkt_t      csr;         // CSR 指令信息
    logic [AW-1:0] trap_pc;     // Trapping instruction PC
    logic [DW-1:0] trap_cause;  // mcause value
    logic [DW-1:0] trap_val;    // mtval value
    logic          is_mret;     // Instruction is mret
    logic          is_wfi;      // Instruction is wfi
  } ex_wb_pkt_t;

  // Canonical pipeline bubbles. All-zero packets make every control and
  // side-effect field safe, and automatically cover fields added in the future.
  localparam fetch_pkt_t FETCH_PKT_BUBBLE = '0;
  localparam id_ex_pkt_t ID_EX_PKT_BUBBLE = '0;
  localparam ex_wb_pkt_t EX_WB_PKT_BUBBLE = '0;

  // Stable architectural completion record for verification/co-simulation.
  // A trapped instruction is reported with valid=1, trap=1, and rd_we=0.
  typedef struct packed {
    logic             valid;
    logic [63:0]      order;
    logic [AW-1:0]    pc;
    logic [31:0]      instr;
    logic             rd_we;
    logic [4:0]       rd_addr;
    logic [DW-1:0]    rd_data;
    logic             mem_valid;
    logic             mem_we;
    logic [AW-1:0]    mem_addr;
    logic [DW/8-1:0]  mem_rmask;
    logic [DW/8-1:0]  mem_wmask;
    logic [DW-1:0]    mem_rdata;
    logic [DW-1:0]    mem_wdata;
    logic             trap;
    logic [DW-1:0]    trap_cause;
    logic [DW-1:0]    trap_val;
  } commit_pkt_t;
endpackage
`default_nettype wire
