HeTPort/Rsicv-soc/src/core/regfile.sv

`timescale 1ns / 1ps
`default_nettype none
module regfile (
  input  wire logic          clk_i,
  input  wire logic          rst_ni,
  input  wire logic [4:0]    rs1_raddr_i,
  output logic [riscv_pkg::DW-1:0] rs1_rdata_o,
  input  wire logic [4:0]    rs2_raddr_i,
  output logic [riscv_pkg::DW-1:0] rs2_rdata_o,
  input  wire logic          rd_wen_i,
  input  wire logic [4:0]    rd_waddr_i,
  input  wire logic [riscv_pkg::DW-1:0] rd_wdata_i
);
  logic [riscv_pkg::DW-1:0] regs [0:31];
  integer i;
  always_comb begin
    if (rs1_raddr_i == 5'd0)
      rs1_rdata_o = '0;
    else if (rd_wen_i && rd_waddr_i != 5'd0 && rs1_raddr_i == rd_waddr_i)
      rs1_rdata_o = rd_wdata_i;
    else
      rs1_rdata_o = regs[rs1_raddr_i];
  end
  always_comb begin
    if (rs2_raddr_i == 5'd0)
      rs2_rdata_o = '0;
    else if (rd_wen_i && rd_waddr_i != 5'd0 && rs2_raddr_i == rd_waddr_i)
      rs2_rdata_o = rd_wdata_i;
    else
      rs2_rdata_o = regs[rs2_raddr_i];
  end
  always_ff @(posedge clk_i or negedge rst_ni) begin
    if (!rst_ni) begin
      for (i = 0; i < 32; i = i + 1)
        regs[i] <= '0;
    end
    else if (rd_wen_i && rd_waddr_i != 5'd0) begin
      regs[rd_waddr_i] <= rd_wdata_i;
    end
  end
endmodule
`default_nettype wire
