HeTPort/Rsicv-soc/sim/tb/tb_soc_data_fabric.sv

`timescale 1ns/1ps
`default_nettype wire
import riscv_pkg::*;

module tb_soc_data_fabric;
  localparam logic [31:0] TIMER_BASE = 32'h0200_0000;
  localparam logic [31:0] TIMER_END  = 32'h0200_ffff;
  localparam logic [31:0] UART_BASE = 32'h1000_0000;
  localparam logic [31:0] UART_END  = 32'h1000_0fff;
  localparam logic [31:0] GPIO_BASE = 32'h1000_1000;
  localparam logic [31:0] GPIO_END  = 32'h1000_1fff;
  localparam logic [31:0] DATA_BASE = 32'h8000_0000;
  localparam logic [31:0] DATA_END  = 32'h8000_ffff;

  logic clk;
  logic rst_n;

  logic cpu_req_valid;
  logic cpu_req_ready;
  core_bus_req_t cpu_req;
  logic cpu_rsp_valid;
  core_bus_rsp_t cpu_rsp;

  logic timer_req_valid;
  logic timer_req_ready;
  core_bus_req_t timer_req;
  logic timer_rsp_valid;
  core_bus_rsp_t timer_rsp;

  logic uart_req_valid;
  logic uart_req_ready;
  core_bus_req_t uart_req;
  logic uart_rsp_valid;
  core_bus_rsp_t uart_rsp;

  logic gpio_req_valid;
  logic gpio_req_ready;
  core_bus_req_t gpio_req;
  logic gpio_rsp_valid;
  core_bus_rsp_t gpio_rsp;

  logic data_req_valid;
  logic data_req_ready;
  core_bus_req_t data_req;
  logic data_rsp_valid;
  core_bus_rsp_t data_rsp;

  int cpu_accept_count;
  int timer_accept_count;
  int uart_accept_count;
  int gpio_accept_count;
  int data_accept_count;
  int cpu_response_count;

  soc_data_fabric #(
    .TIMER_BASE(TIMER_BASE),
    .TIMER_END(TIMER_END),
    .UART_BASE(UART_BASE),
    .UART_END(UART_END),
    .GPIO_BASE(GPIO_BASE),
    .GPIO_END(GPIO_END),
    .DATA_RAM_BASE(DATA_BASE),
    .DATA_RAM_END(DATA_END),
    .DEFAULT_RDATA(32'h0000_0000),
    .DEFAULT_ERROR(1'b1)
  ) u_dut (
    .clk_i            (clk),
    .rst_ni           (rst_n),
    .cpu_req_valid_i  (cpu_req_valid),
    .cpu_req_ready_o  (cpu_req_ready),
    .cpu_req_i        (cpu_req),
    .cpu_rsp_valid_o  (cpu_rsp_valid),
    .cpu_rsp_o        (cpu_rsp),
    .timer_req_valid_o(timer_req_valid),
    .timer_req_ready_i(timer_req_ready),
    .timer_req_o      (timer_req),
    .timer_rsp_valid_i(timer_rsp_valid),
    .timer_rsp_i      (timer_rsp),
    .uart_req_valid_o (uart_req_valid),
    .uart_req_ready_i (uart_req_ready),
    .uart_req_o       (uart_req),
    .uart_rsp_valid_i (uart_rsp_valid),
    .uart_rsp_i       (uart_rsp),
    .gpio_req_valid_o (gpio_req_valid),
    .gpio_req_ready_i (gpio_req_ready),
    .gpio_req_o       (gpio_req),
    .gpio_rsp_valid_i (gpio_rsp_valid),
    .gpio_rsp_i       (gpio_rsp),
    .data_req_valid_o (data_req_valid),
    .data_req_ready_i (data_req_ready),
    .data_req_o       (data_req),
    .data_rsp_valid_i (data_rsp_valid),
    .data_rsp_i       (data_rsp)
  );

  always #5 clk = ~clk;

  always_ff @(posedge clk or negedge rst_n) begin
    if (!rst_n) begin
      cpu_accept_count   <= 0;
      timer_accept_count <= 0;
      uart_accept_count  <= 0;
      gpio_accept_count  <= 0;
      data_accept_count  <= 0;
      cpu_response_count <= 0;
    end else begin
      if (cpu_req_valid && cpu_req_ready)
        cpu_accept_count <= cpu_accept_count + 1;
      if (timer_req_valid && timer_req_ready)
        timer_accept_count <= timer_accept_count + 1;
      if (uart_req_valid && uart_req_ready)
        uart_accept_count <= uart_accept_count + 1;
      if (gpio_req_valid && gpio_req_ready)
        gpio_accept_count <= gpio_accept_count + 1;
      if (data_req_valid && data_req_ready)
        data_accept_count <= data_accept_count + 1;
      if (cpu_rsp_valid)
        cpu_response_count <= cpu_response_count + 1;
    end
  end

  task automatic set_request(
    input logic [31:0] addr,
    input logic write,
    input mem_size_e size,
    input logic [31:0] wdata,
    input logic [3:0] wstrb
  );
    begin
      cpu_req       = '0;
      cpu_req.addr  = addr;
      cpu_req.write = write;
      cpu_req.size  = size;
      cpu_req.wdata = wdata;
      cpu_req.wstrb = wstrb;
    end
  endtask

  initial begin
    clk            = 1'b0;
    rst_n          = 1'b0;
    cpu_req_valid  = 1'b0;
    cpu_req        = '0;
    data_req_ready = 1'b1;
    data_rsp_valid = 1'b0;
    data_rsp       = '0;
    timer_req_ready = 1'b1;
    timer_rsp_valid = 1'b0;
    timer_rsp       = '0;
    uart_req_ready  = 1'b1;
    uart_rsp_valid  = 1'b0;
    uart_rsp        = '0;
    gpio_req_ready  = 1'b1;
    gpio_rsp_valid  = 1'b0;
    gpio_rsp        = '0;

    repeat (3) @(posedge clk);
    @(negedge clk);
    rst_n = 1'b1;

    // Timer decode uses the full SoC window but presents a base-subtracted
    // local register offset to the target. The registered owner must retain
    // timer response ownership even if the live CPU request changes.
    set_request(TIMER_BASE + 32'h4000, 1'b0, MEM_SIZE_WORD, '0, '0);
    cpu_req_valid = 1'b1;
    #1;
    assert (cpu_req_ready && timer_req_valid && !data_req_valid &&
            timer_req.addr == 32'h0000_4000)
      else $fatal(1, "timer decode/local address translation is wrong");
    @(posedge clk);
    @(negedge clk);
    cpu_req_valid = 1'b0;
    set_request(DATA_BASE, 1'b0, MEM_SIZE_WORD, '0, '0);
    timer_rsp.rdata = 32'h1234_abcd;
    timer_rsp.error = 1'b0;
    timer_rsp_valid = 1'b1;
    #1;
    assert (!cpu_req_ready && !data_req_valid && cpu_rsp_valid &&
            cpu_rsp.rdata == 32'h1234_abcd && !cpu_rsp.error)
      else $fatal(1, "registered timer owner did not route its response");
    @(posedge clk);
    @(negedge clk);
    timer_rsp_valid = 1'b0;

    // UART decode also presents a local offset. Its registered response owner
    // must not be affected by the live CPU address after acceptance.
    set_request(UART_BASE + 32'h4, 1'b0, MEM_SIZE_WORD, '0, '0);
    cpu_req_valid = 1'b1;
    #1;
    assert (cpu_req_ready && uart_req_valid && !timer_req_valid &&
            !data_req_valid && uart_req.addr == 32'h0000_0004)
      else $fatal(1, "UART decode/local address translation is wrong");
    @(posedge clk);
    @(negedge clk);
    cpu_req_valid = 1'b0;
    set_request(TIMER_BASE, 1'b0, MEM_SIZE_WORD, '0, '0);
    uart_rsp.rdata = 32'h0000_0001;
    uart_rsp.error = 1'b0;
    uart_rsp_valid = 1'b1;
    #1;
    assert (!cpu_req_ready && !timer_req_valid && cpu_rsp_valid &&
            cpu_rsp.rdata == 32'h0000_0001 && !cpu_rsp.error)
      else $fatal(1, "registered UART owner did not route its response");
    @(posedge clk);
    @(negedge clk);
    uart_rsp_valid = 1'b0;


    // GPIO uses a full architectural address at the CPU boundary, but the target
// must receive only the base-subtracted local byte offset.
set_request(
  GPIO_BASE + 32'h0000_0000,
  1'b1,
  MEM_SIZE_WORD,
  32'hdead_beef,
  4'b1111
);

cpu_req_valid = 1'b1;

#1;

assert (
  cpu_req_ready &&
  gpio_req_valid &&
  !timer_req_valid &&
  !uart_req_valid &&
  !data_req_valid
)
  else $fatal(
    1,
    "GPIO full-address decode or target selection is wrong"
  );

assert (
  gpio_req.addr  == 32'h0000_0000 &&
  gpio_req.write == 1'b1 &&
  gpio_req.size  == MEM_SIZE_WORD &&
  gpio_req.wdata == 32'hdead_beef &&
  gpio_req.wstrb == 4'b1111
)
  else $fatal(
    1,
    "GPIO local-address translation or request payload is wrong"
  );

// This edge transfers ownership of the request to GPIO.
@(posedge clk);
@(negedge clk);

/*
 * Change the live CPU request to UART while GPIO is still outstanding.
 *
 * A correct fabric must:
 *
 * 1. refuse to accept/redecode the UART request;
 * 2. continue waiting for the GPIO response;
 * 3. route the GPIO response when it arrives.
 */
set_request(
  UART_BASE + 32'h0000_0004,
  1'b0,
  MEM_SIZE_WORD,
  '0,
  '0
);

cpu_req_valid = 1'b1;

gpio_rsp.rdata = 32'h4750_494f; // ASCII-like "GPIO" sentinel
gpio_rsp.error = 1'b0;
gpio_rsp_valid = 1'b1;

#1;

assert (
  !cpu_req_ready &&
  !timer_req_valid &&
  !uart_req_valid &&
  !gpio_req_valid &&
  !data_req_valid
)
  else $fatal(
    1,
    "fabric redecoded a live request while GPIO owned a transaction"
  );

assert (
  cpu_rsp_valid &&
  cpu_rsp.rdata == 32'h4750_494f &&
  !cpu_rsp.error
)
  else $fatal(
    1,
    "registered GPIO owner did not route the GPIO response"
  );

/*
 * The GPIO response retires on this edge. The already-present UART request
 * should then become eligible, but it must not have been accepted earlier.
 */
@(posedge clk);
#1;

gpio_rsp_valid = 1'b0;

assert (
  cpu_req_ready &&
  uart_req_valid &&
  !gpio_req_valid
)
  else $fatal(
    1,
    "next target was not released after the GPIO response"
  );

// Keep valid and payload stable until the released UART request is accepted.
@(posedge clk);
#1;
assert (uart_accept_count == 2 && cpu_accept_count == 4)
  else $fatal(1, "released UART request was not accepted exactly once");

@(negedge clk);
cpu_req_valid = 1'b0;
uart_rsp.rdata = 32'h5552_5421; // ASCII-like "URT!" sentinel
uart_rsp.error = 1'b0;
uart_rsp_valid = 1'b1;
#1;
assert (cpu_rsp_valid && cpu_rsp.rdata == 32'h5552_5421 && !cpu_rsp.error)
  else $fatal(1, "released UART request did not retain response ownership");
@(posedge clk);
@(negedge clk);
uart_rsp_valid = 1'b0;

    // An unmapped store must select only the registered default target.
    set_request(32'h4000_0000, 1'b1, MEM_SIZE_WORD,
                32'hdead_beef, 4'b1111);
    cpu_req_valid = 1'b1;
    #1;
    assert (cpu_req_ready && !data_req_valid && !cpu_rsp_valid)
      else $fatal(1, "unmapped store decode/ready is wrong");

    @(posedge clk);
    #1;
    assert (cpu_rsp_valid && cpu_rsp.error && cpu_rsp.rdata == 32'h0)
      else $fatal(1, "default response is not registered zero-data error");
    assert (data_accept_count == 0)
      else $fatal(1, "unmapped store reached data RAM");

    @(negedge clk);
    cpu_req_valid = 1'b0;
    @(posedge clk);
    #1;
    assert (!cpu_rsp_valid && cpu_req_ready)
      else $fatal(1, "default response did not retire after one cycle");

    // RAM request back-pressure must propagate and the RAM address must be
    // base-subtracted without changing the other payload fields.
    @(negedge clk);
    data_req_ready = 1'b0;
    set_request(DATA_BASE + 32'h4, 1'b0, MEM_SIZE_WORD, '0, '0);
    cpu_req_valid = 1'b1;
    #1;
    assert (data_req_valid && !cpu_req_ready)
      else $fatal(1, "RAM back-pressure was not propagated");
    assert (data_req.addr == 32'h0000_0004 &&
            data_req.size == MEM_SIZE_WORD && !data_req.write)
      else $fatal(1, "RAM request translation/payload is wrong");

    @(posedge clk);
    @(negedge clk);
    data_req_ready = 1'b1;
    @(posedge clk);
    #1;
    assert (!cpu_rsp_valid && data_accept_count == 1)
      else $fatal(1, "mapped RAM request acceptance is wrong");

    // Change the live request to an unmapped address while RAM is outstanding.
    // The registered owner must still route only the RAM response.
    @(negedge clk);
    set_request(DATA_END + 32'h1, 1'b0, MEM_SIZE_BYTE, '0, '0);
    cpu_req_valid  = 1'b1;
    data_rsp.rdata = 32'h1234_5678;
    data_rsp.error = 1'b0;
    data_rsp_valid = 1'b1;
    #1;
    assert (!cpu_req_ready && !data_req_valid)
      else $fatal(1, "fabric accepted/redecoded a request while outstanding");
    assert (cpu_rsp_valid && cpu_rsp.rdata == 32'h1234_5678 && !cpu_rsp.error)
      else $fatal(1, "registered RAM owner did not route its response");

    // Keep the next request asserted. It becomes eligible immediately after
    // the RAM response retires and must then select the default target.
    @(posedge clk);
    #1;
    data_rsp_valid = 1'b0;
    assert (cpu_req_ready && !data_req_valid)
      else $fatal(1, "cross-target request was not released after response");
    @(posedge clk);
    #1;
    assert (cpu_rsp_valid && cpu_rsp.error && cpu_rsp.rdata == '0)
      else $fatal(1, "above-RAM boundary did not select the default target");
    assert (data_accept_count == 1)
      else $fatal(1, "above-RAM boundary reached RAM");

    @(negedge clk);
    cpu_req_valid = 1'b0;
    @(posedge clk);

    // The final byte of the configured region is mapped and translated to the
    // final local byte address.
    @(negedge clk);
    set_request(DATA_END, 1'b0, MEM_SIZE_BYTE, '0, '0);
    cpu_req_valid = 1'b1;
    #1;
    assert (data_req_valid && cpu_req_ready &&
            data_req.addr == 32'h0000_ffff)
      else $fatal(1, "inclusive RAM end boundary is wrong");
    @(posedge clk);
    @(negedge clk);
    cpu_req_valid  = 1'b0;
    data_rsp.rdata = 32'h0000_00a5;
    data_rsp.error = 1'b0;
    data_rsp_valid = 1'b1;
    #1;
    assert (cpu_rsp_valid && cpu_rsp.rdata == 32'h0000_00a5)
      else $fatal(1, "RAM end-boundary response was not routed");
    @(posedge clk);
    #1;
    data_rsp_valid = 1'b0;

    assert (cpu_accept_count == 8)
      else $fatal(1, "CPU acceptance count mismatch: %0d", cpu_accept_count);
    assert (timer_accept_count == 1)
      else $fatal(1, "timer acceptance count mismatch: %0d", timer_accept_count);
    assert (uart_accept_count == 2)
      else $fatal(1, "UART acceptance count mismatch: %0d", uart_accept_count);
    assert (gpio_accept_count == 1)
      else $fatal(1, "GPIO acceptance count mismatch: %0d", gpio_accept_count);
    assert (data_accept_count == 2)
      else $fatal(1, "RAM acceptance count mismatch: %0d", data_accept_count);
    assert (cpu_response_count == 8)
      else $fatal(1, "response count mismatch: %0d", cpu_response_count);

    $display("[SOC-DATA-FABRIC-TB] RESULT: PASS");
    $finish;
  end

endmodule
`default_nettype wire
