HeTPort/Rsicv-soc/tools/divider_lab/lint_fixtures/latch_bad.sv

// Teaching fixture, NOT connected to the SoC.
// Contract: sample_o equals data_i when enable_i=1, otherwise sample_o=0.
// Deliberate bug: no assignment for enable_i=0 infers storage instead.
module latch_bad (
  input  logic       enable_i,
  input  logic [7:0] data_i,
  output logic [7:0] sample_o
);
  always_comb begin
    if (enable_i)
      sample_o = data_i;
  end
endmodule
