HeTPort/Rsicv-soc/(commit log)

2026-05-27 imporove for 5th stage and verification in fpga
2026-05-29 A complete version that has no error in vivado
    [data_ram.sv, execute.sv, prog_ram.sv, tb_riscv_core.sv]
2026-06-12 缩短decode关键路径,提升主频性能
2026-06-22 default nettype from none to wire for vivado check reduce data_ram's complex logic to fit into future bus design recommend module design from the design graph
2026-07-22 Add ACT4 readiness flow and architecture action plan
2026-07-26 Prevent CSR writes from killed pipeline packets
    [riscv.sv]
2026-07-26 Document CPU verification framework
2026-07-26 Add failing control-flow misalignment regressions
2026-07-26 Trap precise misaligned control-flow targets
    [execute.sv, riscv.sv, riscv_pkg.sv]
2026-07-27 Add RISC-V SoC architecture flowchart
    Added a flowchart diagram for the RISC-V SoC architecture using Mermaid syntax.
2026-07-28 Add failing synchronous fetch timing check
    [tb_riscv_core.sv]
2026-07-28 Add failing AR-003 LSU protocol contract
    [riscv_pkg.sv, tb_lsu_protocol.sv]
2026-07-29 Add failing AR-004 memory result tests
    [core_bus_data_ram.sv, tb_ar004_packet_contract.sv, tb_riscv_core.sv]
2026-08-03 feat: close AR-018 fetch fault and pass ACT4 RV32I/RV32M baselines
    - Add explicit instr_access_fault path via prog_ram.fetch_error_o
    - Carry fetch error through fetch_pkt_t and exc_pkt_t
    - Decode suppresses illegal/ebreak/ecall when fetch error is present
    - Execute prioritizes MCAUSE_INST_ACCESS (cause 1) over other traps
    - Remove fetch-time diagnostics now that out-of-range fetch is expected
    - Update core and SoC testbenches for the new error signal
    - Complete ACT4 no-op interrupt macro contract
    - Add run_act4_rv32i.ps1 and run_act4_rv32m.ps1 helper scripts
    - Fix run_regression.ps1 relative manifest path resolution
    - Document AR-018 GREEN status and ACT4 39/39 + 8/8 PAS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
    [decode.sv, execute.sv, prog_ram.sv, riscv.sv, riscv_pkg.sv, riscv_soc.sv, tb_riscv_core.sv]
2026-08-06 Add Phase 3 Implementation Guide for Timer Interrupts
    Add Phase 3 Implementation Guide for machine timer interrupts, detailing tasks, CPU core logic changes, timer peripheral, clock control unit, and SoC integration.
2026-08-09 feat: implement precise timer interrupts and WFI
2026-08-09 feat: add minimal polling UART TX
2026-08-09 feat: add polling UART RX FIFO
2026-08-15 feat(fpga): add ZYNQ MINI REVB board flow
2026-08-15 docs: record zynq board validation and jtag recovery
2026-08-23 fix: canonicalize fetch-error decode packets
    [decode.sv, tb_decode_fetch_error.sv]
2026-08-23 test: cover fetch-error timing corners
    [tb_fetch_error_timing.sv]
2026-08-23 docs: record physical FreeRTOS board validation
2026-09-07 docs: adopt licensing and power roadmap
2026-09-11 docs: clarify propulsion vision and current SoC stage
2026-09-21 feat(power): complete six-workload P0 baseline
